Doomn00b/Open-SVGA/Docs/Connectors/USB-C/usbC-PIN/usb-type-c-hdmi.png

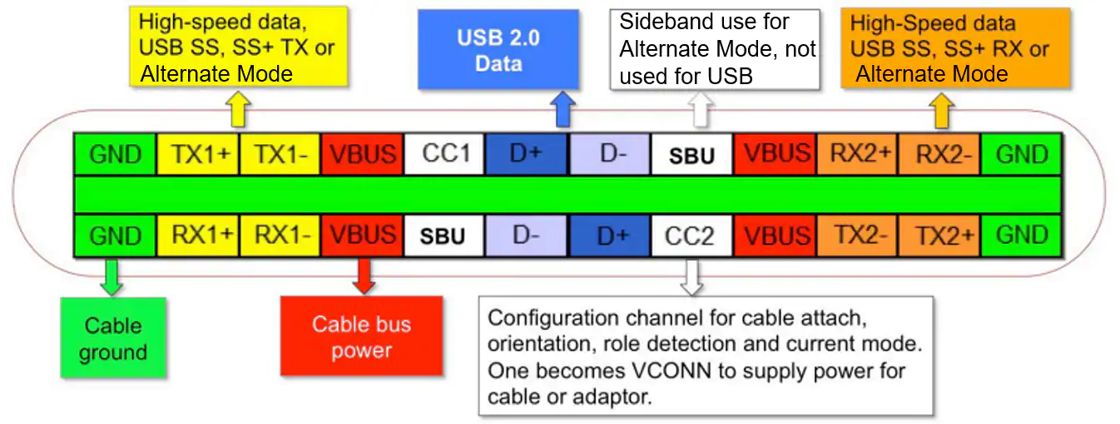
Docs/Connectors/USB-C/usbC-PIN/usb-type-c-hdmi.png
