Doomn00b/Open-SVGA/Docs/RAM/MT52L256M32D1PF-107-WT-B-package-BGA-178-new-original-genuine-ic-chip-DDR-SDRAM.png

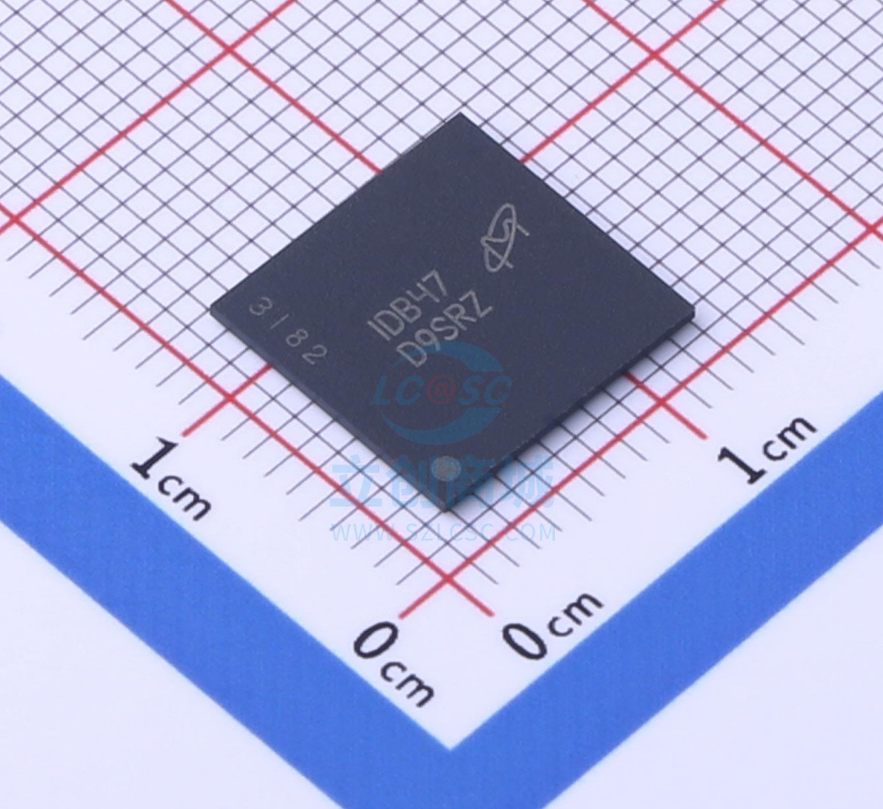
Docs/RAM/MT52L256M32D1PF-107-WT-B-package-BGA-178-new-original-genuine-ic-chip-DDR-SDRAM.png
