Doomn00b/Open-SVGA/README.md

# Open-SVGA
Video-card and GPU for the PC x86 platform, including PCB reference-design

This project is meant to encompass a PCI 3.0 31-bits video-card capable of displaying the majority of resolutions and video-modes from CGA, EGA, VGA and finally SVGA. Drivers are meant to be developed for DoS 6.5, Windows 98SE and Windows 10.
