Doomn00b/Open-SVGA/Docs/Connectors/VGA-pin/VGA-Connector.pdf

VGA connector | 1

# VGA connector

VGA connector (DE-15/HD-15)

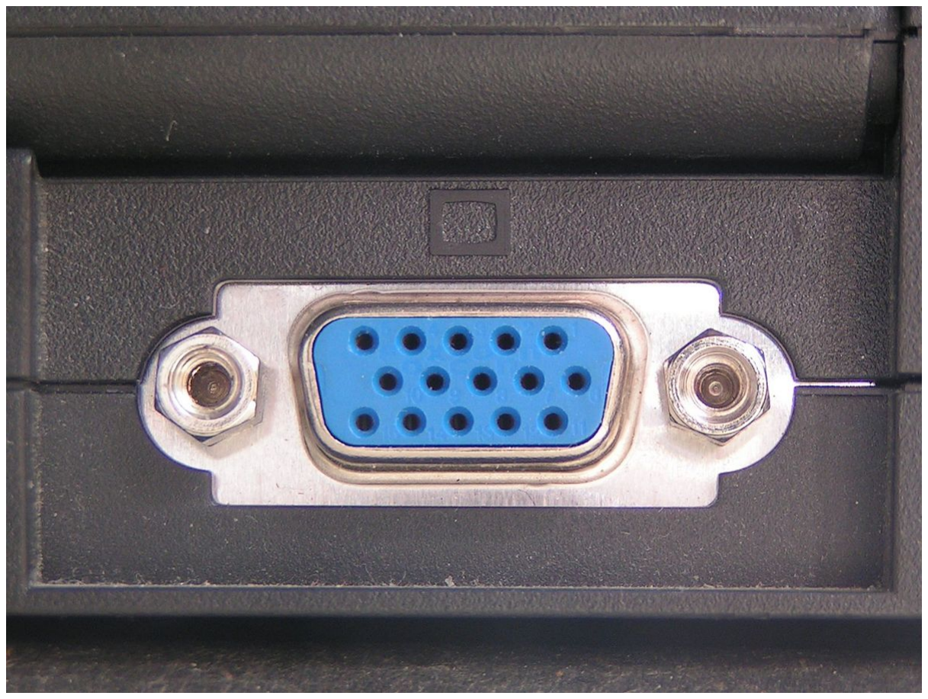
[picture p3: figure]

A female DE-15 output in a laptop computer.
Type | Computer analog video connector
| Production history
Designer | IBM (http://en.wikipedia.org/w/index.php?title=International_Business_Machines) based on D-subminiature (http://en.wikipedia.org/w/index.php?title=D-subminiature)
Designed | 1987
Produced | 1987 to present
Superseded by | DVI (http://en.wikipedia.org/w/index.php?title=Digital_Visual_Interface) (1999)

General specifications

Hot pluggable | No
Video signal | RGB video signal plus option H and V sync
Pins | 15
Connector | DE-15

Data

Data signal | I²C (http://en.wikipedia.org/w/index.php?title=I%C2%B2C) data channel for DDC (http://en.wikipedia.org/w/index.php?title=Display_Data_Channel) information
| Pin out

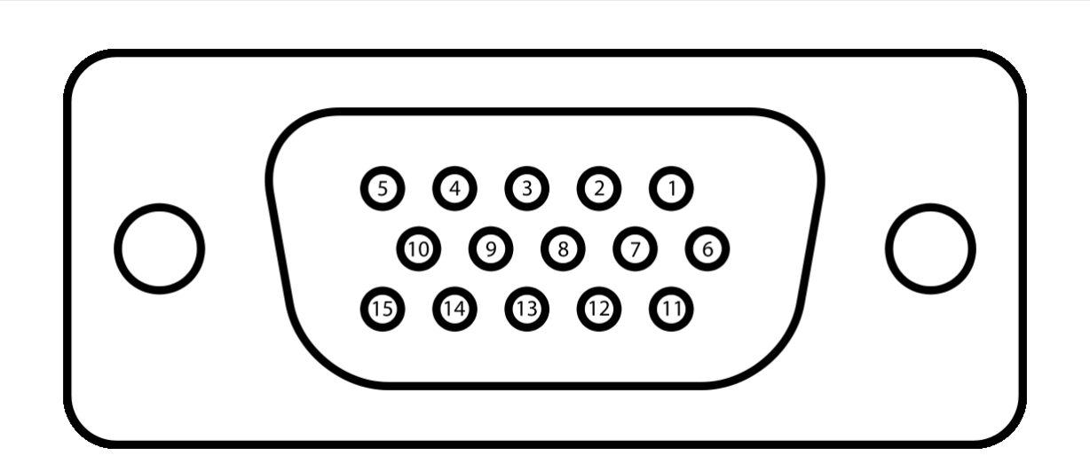
[picture p4: figure]

A female DE15 socket (videocard side).

Pin 1 | RED | Red video
Pin 2 | GREEN | Green video
Pin 3 | BLUE | Blue video

Pin 4 | ID2/RES | formerly Monitor ID bit 2, reserved since E-DDC
Pin 5 | GND | Ground (HSync)
Pin 6 | RED_RTN | Red return
Pin 7 | GREEN_RTN | Green return
Pin 8 | BLUE_RTN | Blue return
Pin 9 | KEY/PWR | formerly key, now +5V DC
Pin 10 | GND | Ground (VSync, DDC)
Pin 11 | ID0/RES | formerly Monitor ID bit 0, reserved since E-DDC
Pin 12 | ID1/SDA | formerly Monitor ID bit 1, I²C (http://en.wikipedia.org/w/index.php?title=I%C2%B2C) data since DDC2
Pin 13 | HSync | Horizontal sync
Pin 14 | VSync | Vertical sync
Pin 15 | ID3/SCL | formerly Monitor ID bit 3, I²C (http://en.wikipedia.org/w/index.php?title=I%C2%B2C) clock since DDC2

The image and table detail the 15-pin VESA DDC2/E-DDC connector; the diagram’s pin numbering is that of a female connector functioning as the graphics adapter (http://en.wikipedia.org/w/index.php?title=Graphics_adapter) output. In the male connector, this pin numbering corresponds with the mirror image (http://en.wikipedia.org/w/index.php?title=Mirror_image) of the cable’s wire-and-solder side.

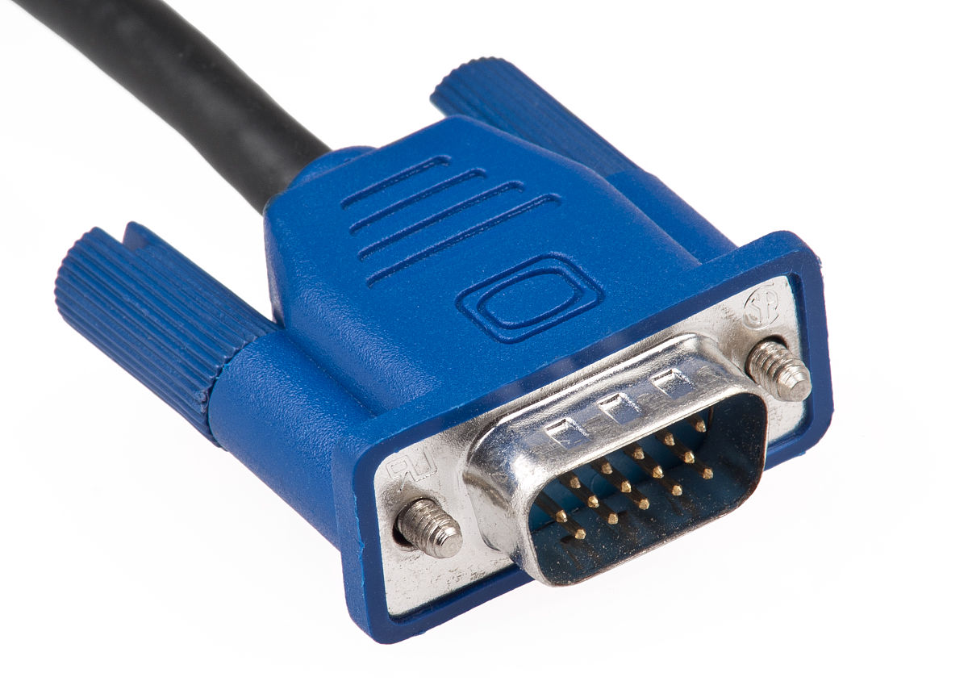
[picture p5: figure]

A VGA cable

A Video Graphics Array (http://en.wikipedia.org/w/index.php?title=Video_Graphics_Array) (VGA) connector is a three-row 15-pin DE-15 (http://en.wikipedia.org/w/index.php?title=D-subminiature) connector. The 15-pin VGA connector is found on many video cards, computer monitors, and some high definition television (http://en.wikipedia.org/w/index.php?title=High_definition_television) sets. On laptop computers or other small devices, a mini-VGA (http://en.wikipedia.org/w/index.php?title=Mini-VGA) port is sometimes used in place of the full-sized VGA connector.

DE-15 is also conventionally called RGB connector, D-sub (http://en.wikipedia.org/w/index.php?title=D-subminiature) 15, mini sub D15, mini D15, DB-15, HDB-15, HD-15 or HD15 (High Density, to distinguish it from the older and less flexible DE-9 connector (http://en.wikipedia.org/w/index.php?title=DE-9_connector) used on some older VGA cards, which has the same shell size but only two rows of pins).

VGA connectors and cables carry analog (http://en.wikipedia.org/w/index.php?title=Analog_television) component (http://en.wikipedia.org/w/index.php?title=Component_video) RGBHV (red, green, blue, horizontal sync, (http://en.wikipedia.org/w/index.php?title=Horizontal_sync) vertical sync) (http://en.wikipedia.org/w/index.php?title=Vertical_sync) video signals, and VESA (http://en.wikipedia.org/w/index.php?title=VESA) Display Data Channel (http://en.wikipedia.org/w/index.php?title=Display_Data_Channel) (VESA DDC) data. In the original version of DE-15 pinout, one pin was keyed and 4 pins carried Monitor ID bits (http://en.wikipedia.org/w/index.php?title=Display_Data_Channel%23Physical_link) which were rarely used; VESA DDC redefined some of these pins and replaced the key pin with +5 V DC power supply.

The VGA interface is not engineered to be hotpluggable (so that the user can connect or disconnect the output device while the host is running), although in practice this can be done and usually does not cause damage to the hardware or other problems. However, nothing in the design ensures that the ground pins make a connection first and break last, so hotplugging may introduce surges in signal lines which may or may not be adequately protected against. Also, depending on the hardware and software, detecting a monitor being connected might not work properly in all cases.

## Cable quality

The same VGA cable can be used with a variety of supported VGA resolutions, ranging from 640×400px @70 Hz (24 MHz of signal bandwidth) (http://en.wikipedia.org/w/index.php?title=Signal_bandwidth) to 1280×1024px (SXGA) (http://en.wikipedia.org/w/index.php?title=SXGA) @85 Hz (160 MHz) and up to 2048×1536px (QXGA) (http://en.wikipedia.org/w/index.php?title=QXGA) @85 Hz (388 MHz). There are no standards defining the quality required for each resolution, but higher-quality cables typically contain coaxial wiring and insulation which make them thicker. A quality cable should not suffer from signal crosstalk which occurs when the signals in one wire induce unwanted currents in adjacent wires, ghosting (http://en.wikipedia.org/w/index.php?title=Ghosting_%28television%29) which occurs when impedance mismatches cause signals to be reflected (note that ghosting with long cables may not be the fault of the cable but may instead be caused by equipment with incorrect termination or by use of passive splitters), and other signal degradation effects; shorter VGA cables are less likely to introduce significant degradation. Some higher-end monitors and video cards featured 5 separate BNC connectors (http://en.wikipedia.org/w/index.php?title=BNC_connector) for RGBHV (http://en.wikipedia.org/w/index.php?title=RGBHV) signal, allowing highest quality connection using five 75 ohm coaxial cables. (http://en.wikipedia.org/w/index.php?title=Coaxial_cable)

## Adapters

There are HDMI (http://en.wikipedia.org/w/index.php?title=HDMI) to VGA [1] and DVI (http://en.wikipedia.org/w/index.php?title=Digital_Visual_Interface) to VGA adapters, and VGA to SCART (http://en.wikipedia.org/w/index.php?title=SCART) converters. [2][3][4]

For a simple VGA to SCART adapter cable to be viable, the display card must have sufficient features. Namely the ability to provide interlaced output and adjust the frequency, number of total scan lines and number of visible lines (the actual resolution) to match those of the prevailing TV standard. [5] Signal incompatibility rises from the fact that

SCART uses composite sync, (http://en.wikipedia.org/w/index.php?title=Composite_sync) so either display card must be able to do so too, or sync signals must be summed with a simple circuit. Additionally some TV sets may require 1 volt voltage on SCART pin 16 as explicit signal to use component instead of composite signal. [6] Likewise, three conductor analog RGB signal uses composite sync on

green, (http://en.wikipedia.org/w/index.php?title=Sync_on_green) but a converter circuit for to achieve that is simple as well. http://www. epanorama. net/ circuits/sync_r. html (http://www.epanorama.net/circuits/sync_r.html)

HDMI/DVI to VGA adapters do not carry the audio channel. Separate audio cables are used.

HDMI to VGA adapters generally won't be useful as most displays can't read analog over the HDMI port. The display's EDID (http://en.wikipedia.org/w/index.php?title=EDID) can still be read.

## References

[1] http://www.amazon.com/dp/B001OLCHJ6
[2] http://www.epanorama.net/circuits/vga2tv/cindex.html
[3] http://pinouts.ru/VideoCables/scart2vga_scheme_pinout.shtml
[4] http://www.amazon.co.uk/dp/B0002W69MY
[5] http://www.nexusuk.org/projects/vga2scart/
[6] http://www.nexusuk.org/projects/vga2scart/

## External links

- DE-9 pinout (http://old.pinouts.ru/Video/VGA9_pinout.shtml)
- DE-15 Monitor ID pinout (http://pinouts.ru/data/VGA15_pinout.shtml)
- DE-15 VESA DDC pinout (http://pinouts.ru/Video/VGAVesaDdc_pinout.shtml)
- DE-15 to 5 BNC (http://www.repairfaq.org/REPAIR/F_vidconv.html#VIDCONV_056)

Article Sources and Contributors | 4

# Article Sources and Contributors

VGA connector Source: http://en.wikipedia.org/w/index.php?oldid=498841275 Contributors: Abisys, Academic Challenger, Airplaneman, Alansohn, Ali@gwc.org.uk, Antilived, ArglebargleIV, Atif5561, Atlant, Ayda D, Beland, Bourgeoisdude, Brycen, Canterbury Tail, Cburnett, Ctachme, David Edgar, Dherm8or, Diamondland, DmitryKo, DracoDan82, Dtcdthingy, Edwulf, Electron9, Etienne.navarro, Evan-Amos, Evil saltine, Fastilysock, Femto, FlyingPenguins, Frap, Fredylibrary, Fuhghettaboutit, Gbm, Ghiraddje, GoingBatty, Gotanda, Gracefool, Guyom, Harvalumn, Heywøød, Hummingbirdfrost, IceCreamAntisocial, Inferno, Lord of Penguins, Int21h, Jncraton, Johnchiu, JonHarder, Joshua 70448, Julien, Kainaw, Kevin, Kickin' Da Speaker, Kkemp, Kstinch, Lordkosmos, Mark Rizo, Markhobley, Mcleodm, Megapixie, Merlion444, Mhazard9, Miernik, Mobius, Mrschimpf, Nicolaasuni, Oldmountains, Ozkidzez91, Pagingmrherman, Pako, Pbb, Peaceduck, Pfranson, Phy1729, Plugwash, Reisio, RevRagnarok, Rjwilmsi, RoseTech, ST47, SmartAVI, Stickeylabel, Strandist, TX-TransAm, ULTRA
ANNIHILATOR, Ugnich Anton, VasuVR, Venkatesan2488, Vespristiano, Vrenator, Wbm1058, Wtshymanski, WuWei, Xx521xx, Ydroneaud, Yottie, Zujua, | المحارب | محمد | , 178 anonymous edits

# Image Sources, Licenses and Contributors

Image:SVGA port.jpg Source: http://en.wikipedia.org/w/index.php?title=File:SVGA_port.jpg License: Public Domain Contributors: Duncan Lithgow
Image:DE15 Connector Pinout.svg Source: http://en.wikipedia.org/w/index.php?title=File:DE15_Connector_Pinout.svg License: Public Domain Contributors: 32bitmaschine, Mobius Image:Vga-cable.jpg Source: http://en.wikipedia.org/w/index.php?title=File:Vga-cable.jpg License: Public Domain Contributors: Evan-Amos

# License

Creative Commons Attribution-Share Alike 3.0 Unported //creativecommons.org/licenses/by-sa/3.0/
