Doomn00b/Open-SVGA/Docs/Connectors/dvi/2000px-DVI_Connector_Types.svg.png

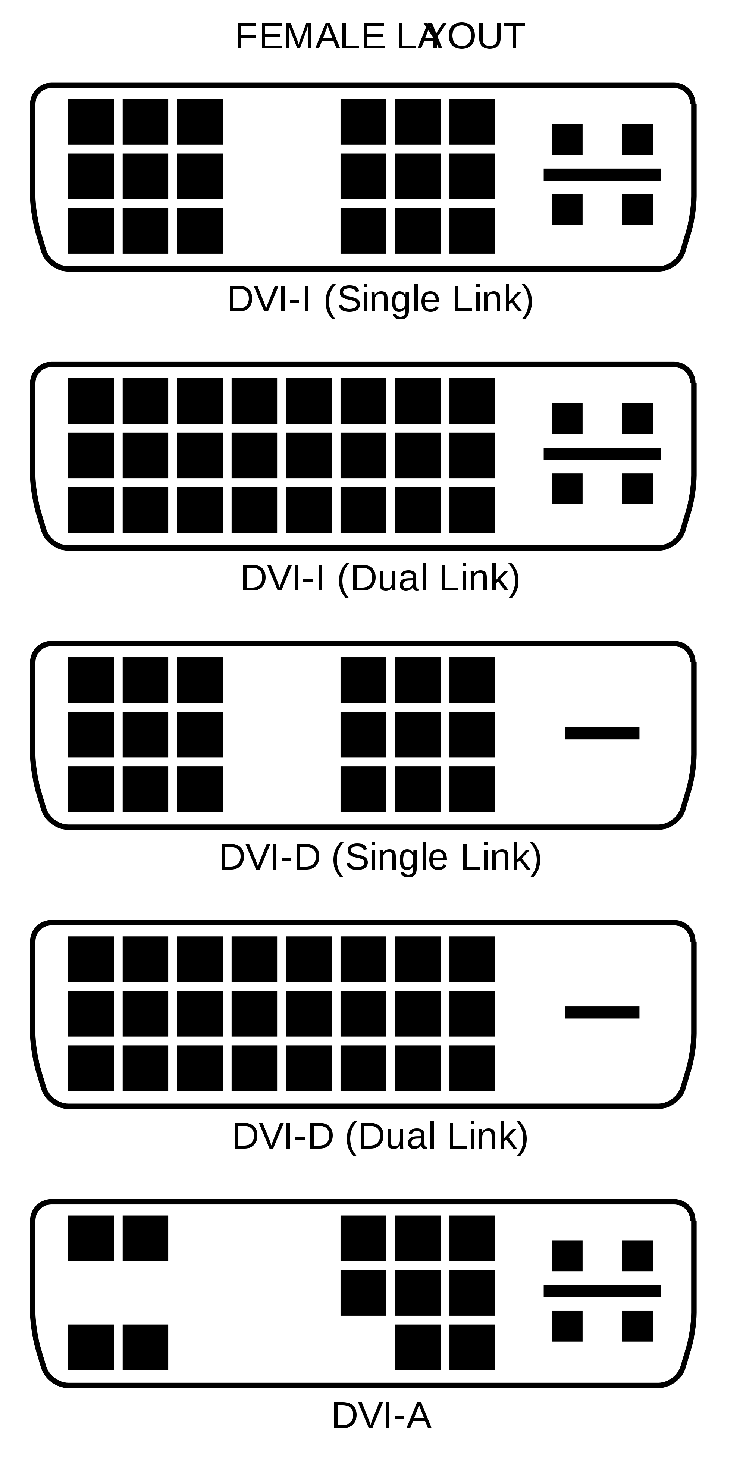
Docs/Connectors/dvi/2000px-DVI_Connector_Types.svg.png
