Doomn00b/Open-SVGA/Docs/Connectors/dvi/2000px-DVI_pinout.svg.png

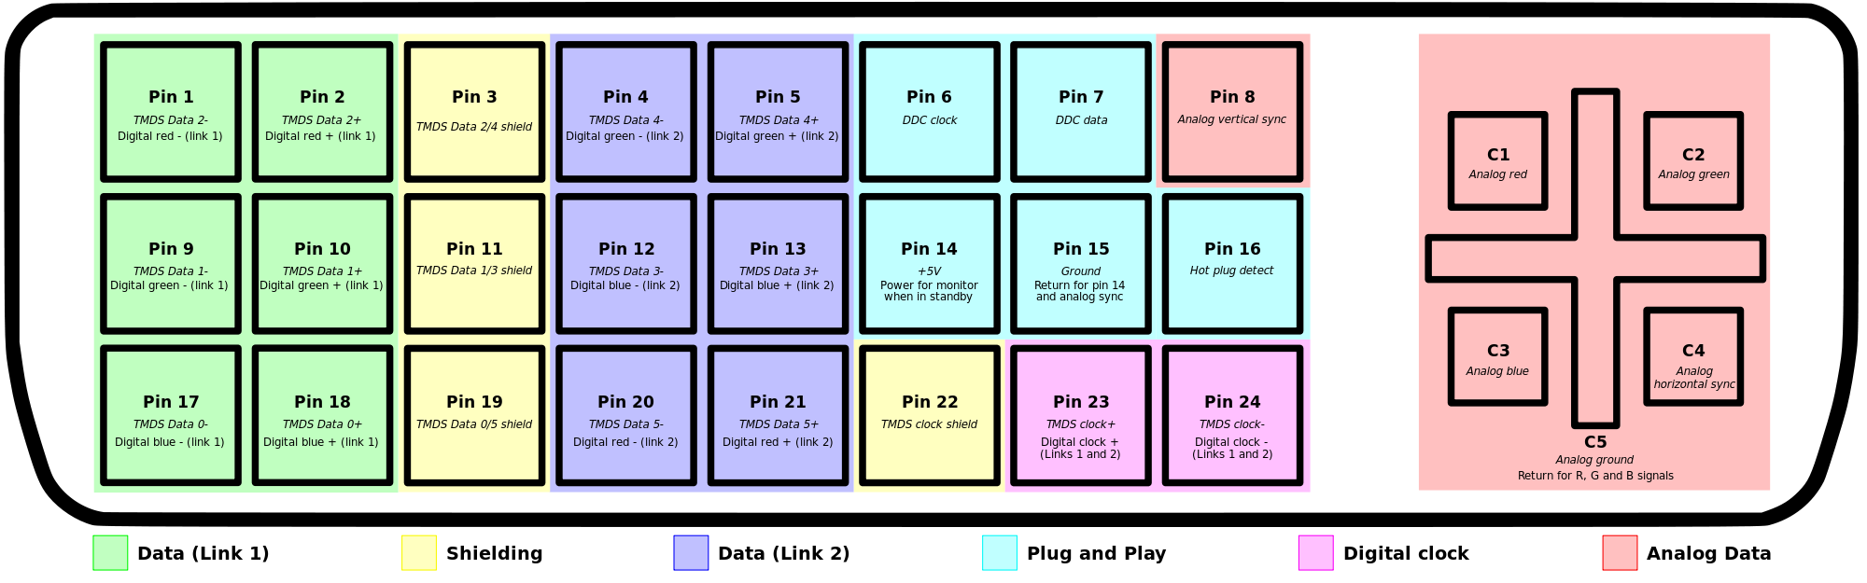
Docs/Connectors/dvi/2000px-DVI_pinout.svg.png
