Doomn00b/Open-SVGA/Docs/Connectors/dvi/dvi_to_vga_adapter.jpg

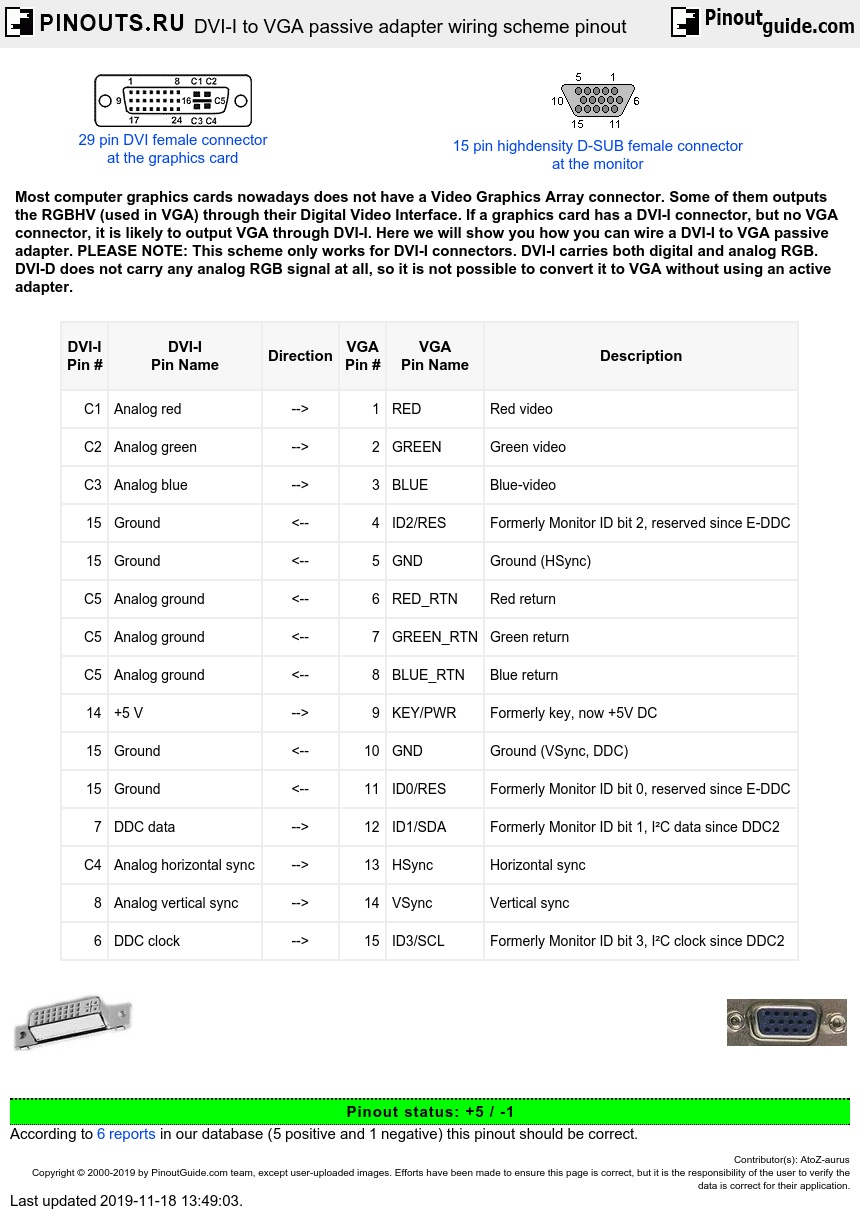
Docs/Connectors/dvi/dvi_to_vga_adapter.jpg
