Doomn00b/Open-SVGA/Docs/Connectors/hdmi/hdmi-pinout.jpg

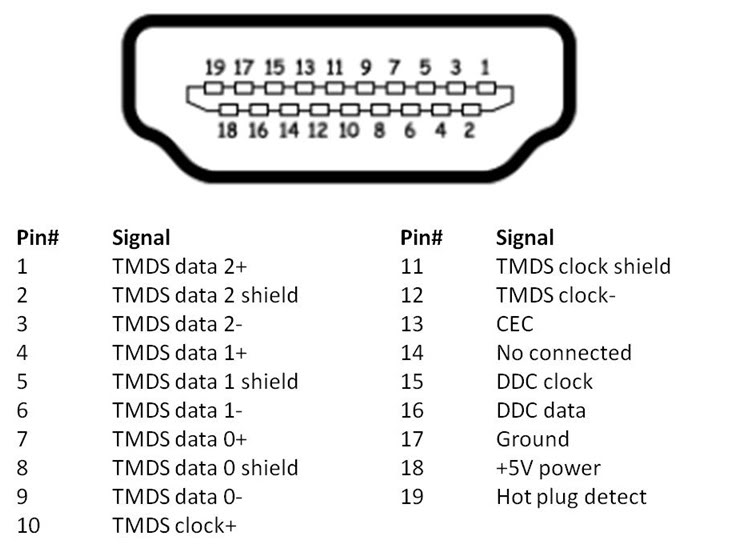
Docs/Connectors/hdmi/hdmi-pinout.jpg
