Doomn00b/Open-SVGA/Docs/Connectors/hdmi/HDMI_Connector_Pinout.svg.png

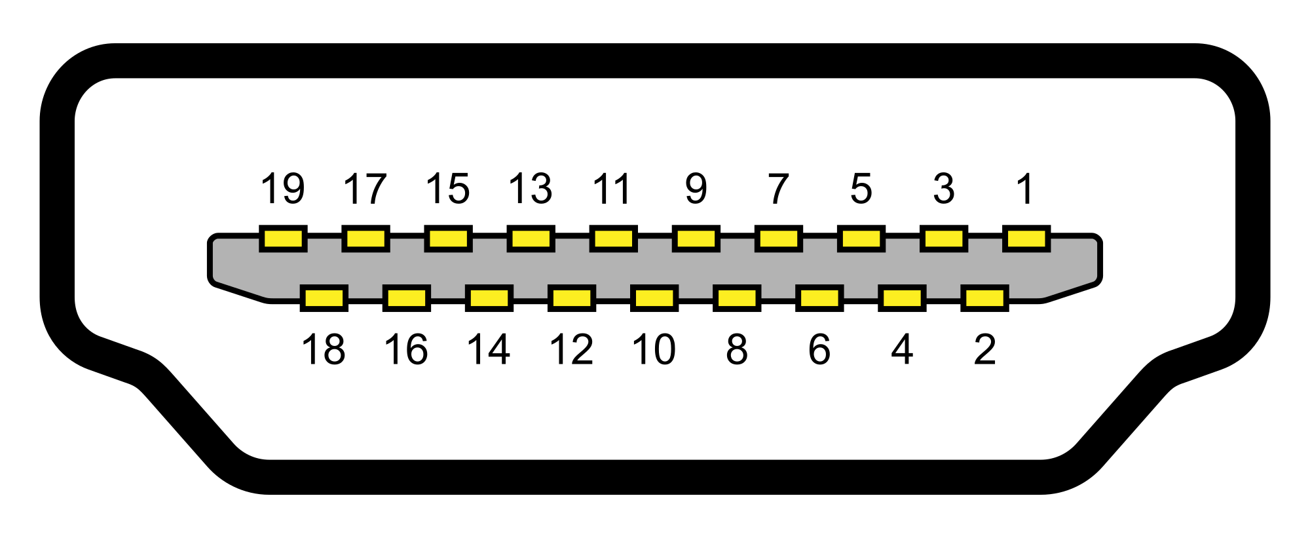
Docs/Connectors/hdmi/HDMI_Connector_Pinout.svg.png
