Doomn00b/Open-SVGA/Docs/Connectors/hot_plug_pinouts.png

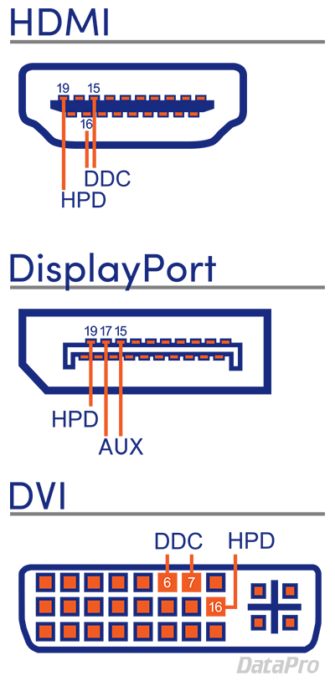
Docs/Connectors/hot_plug_pinouts.png
