Doomn00b/Open-SVGA/Docs/Connectors/PCI/pci-conn-types.png

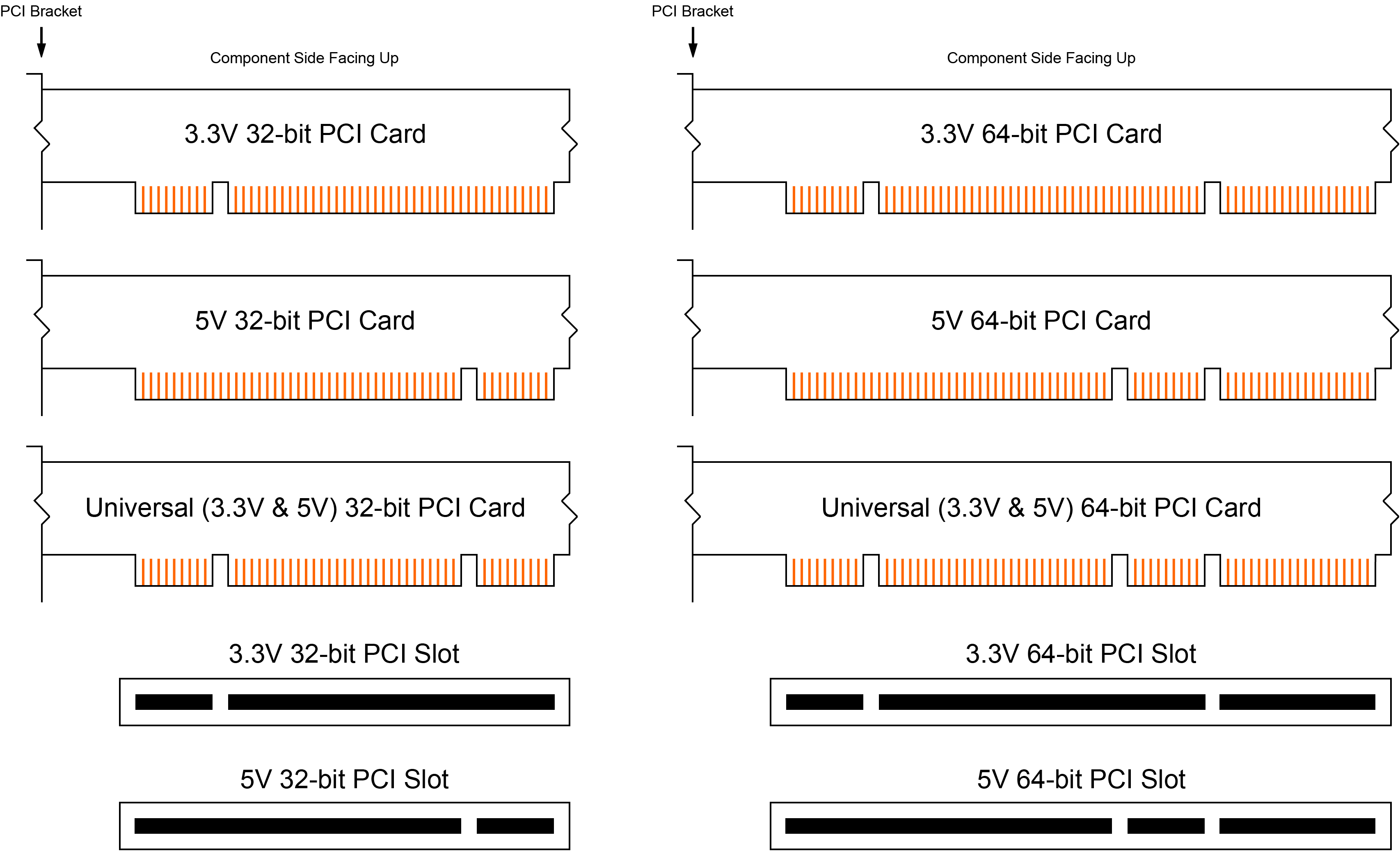
Docs/Connectors/PCI/pci-conn-types.png
