Doomn00b/Open-SVGA/Docs/Connectors/USB-C/USB-C_to_DP.png

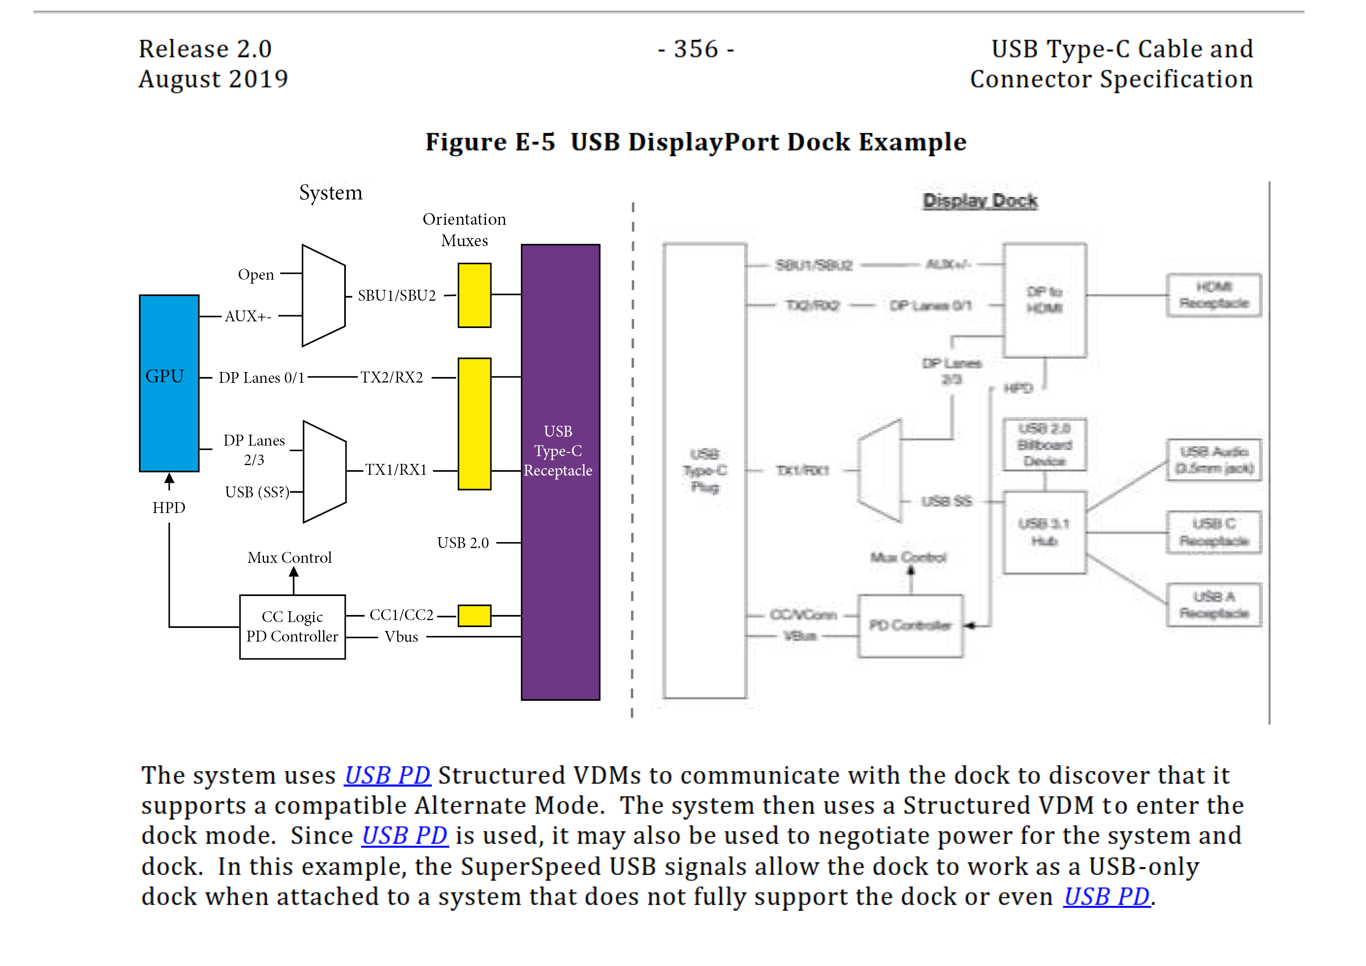
Docs/Connectors/USB-C/USB-C_to_DP.png
