Doomn00b/Open-SVGA/Docs/Connectors/USB-C/usbC-PIN/USB3_2-Diag-1_.jpg

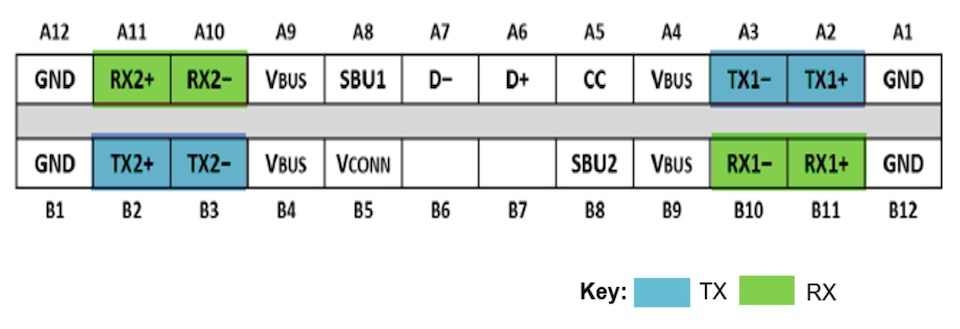
Docs/Connectors/USB-C/usbC-PIN/USB3_2-Diag-1_.jpg
