Doomn00b/Open-SVGA/Docs/Connectors/USB-C/usbC-PIN/usb-c-port.png

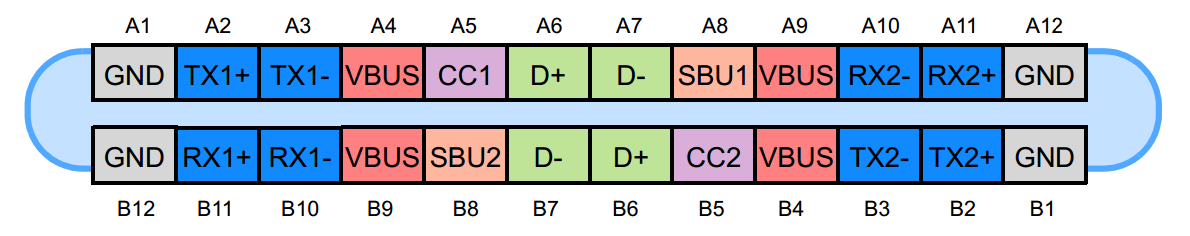
Docs/Connectors/USB-C/usbC-PIN/usb-c-port.png
