Doomn00b/Open-SVGA/Docs/Connectors/VGA-pin/svgamonitor.gif

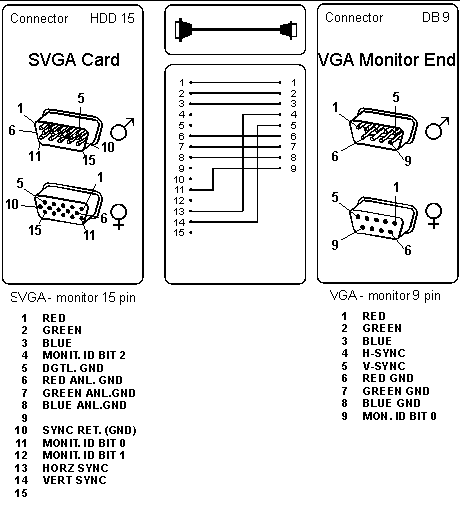
Docs/Connectors/VGA-pin/svgamonitor.gif
