Doomn00b/Open-SVGA/Docs/Connectors/VGA-pin/VGA-Pinout.jpg

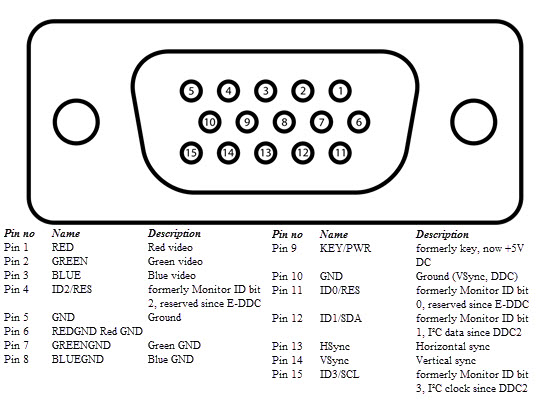
Docs/Connectors/VGA-pin/VGA-Pinout.jpg
