Doomn00b/Open-SVGA/Docs/Connectors/VGA-pin/VGA-Pinouts-16fe4wk.png

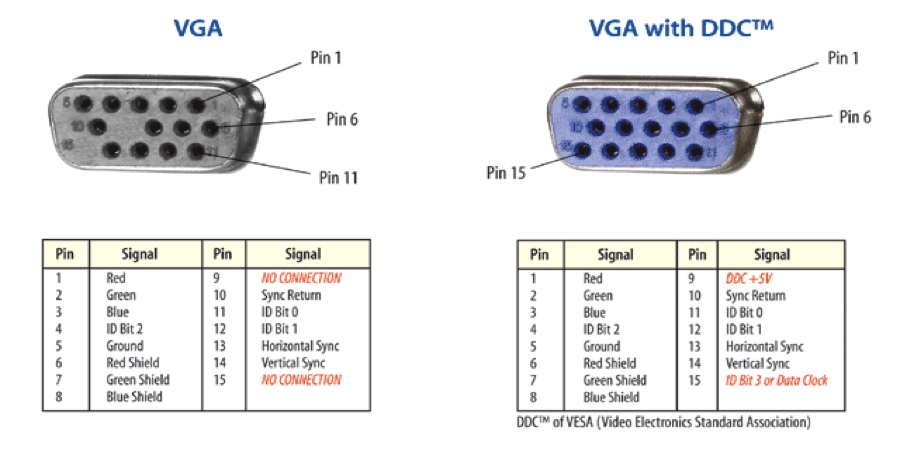
Docs/Connectors/VGA-pin/VGA-Pinouts-16fe4wk.png
