Doomn00b/Open-SVGA/Docs/datasheets-osvga/Voltage-translation/bus-datasheet.png

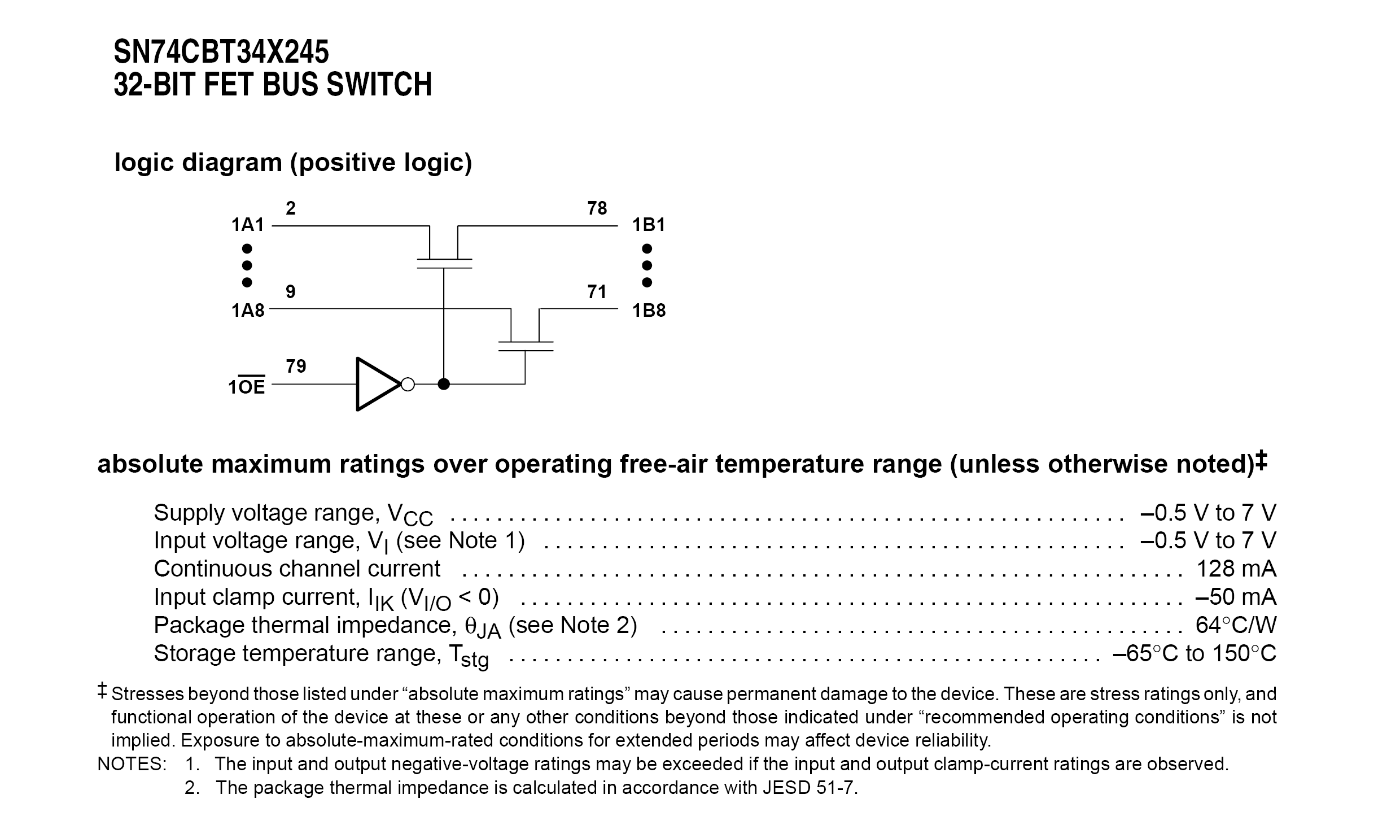
Docs/datasheets-osvga/Voltage-translation/bus-datasheet.png
