Doomn00b/Open-SVGA/Docs/datasheets-osvga/Voltage-translation/bus-switches.png

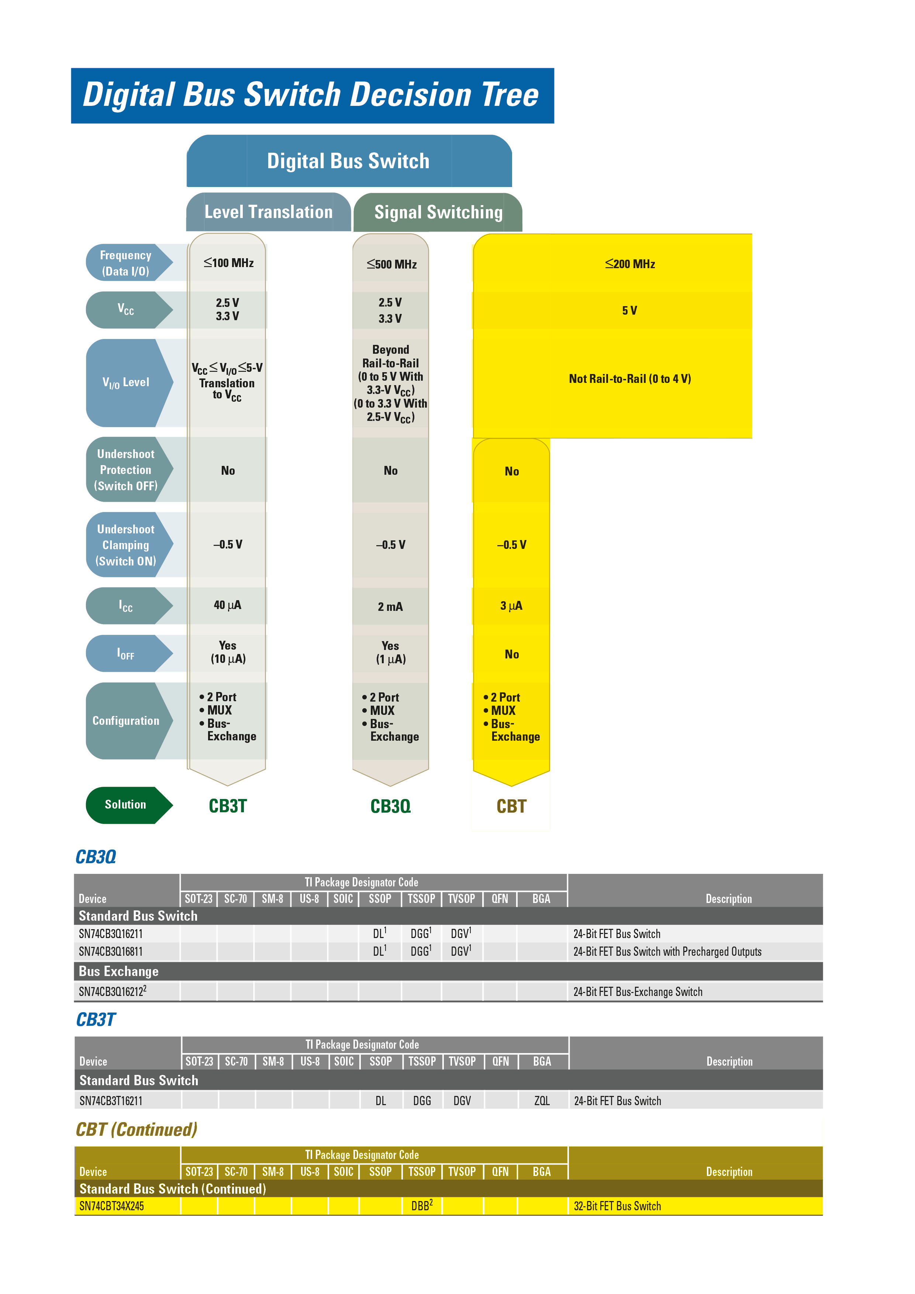
Docs/datasheets-osvga/Voltage-translation/bus-switches.png
