Doomn00b/Open-SVGA/Docs/Design-rules-pcb/JLCPCB-drill-hole_rules.png

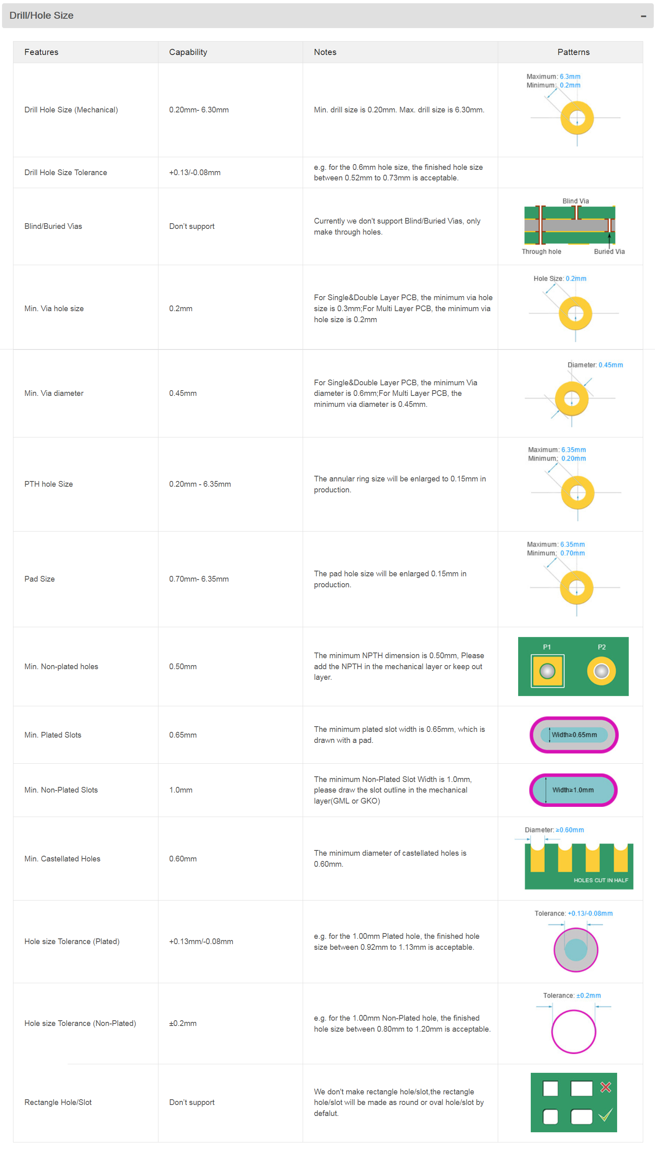
Docs/Design-rules-pcb/JLCPCB-drill-hole_rules.png
