Doomn00b/Open-SVGA/Docs/Design-rules-pcb/JLCPCB-min-clear_rules.png

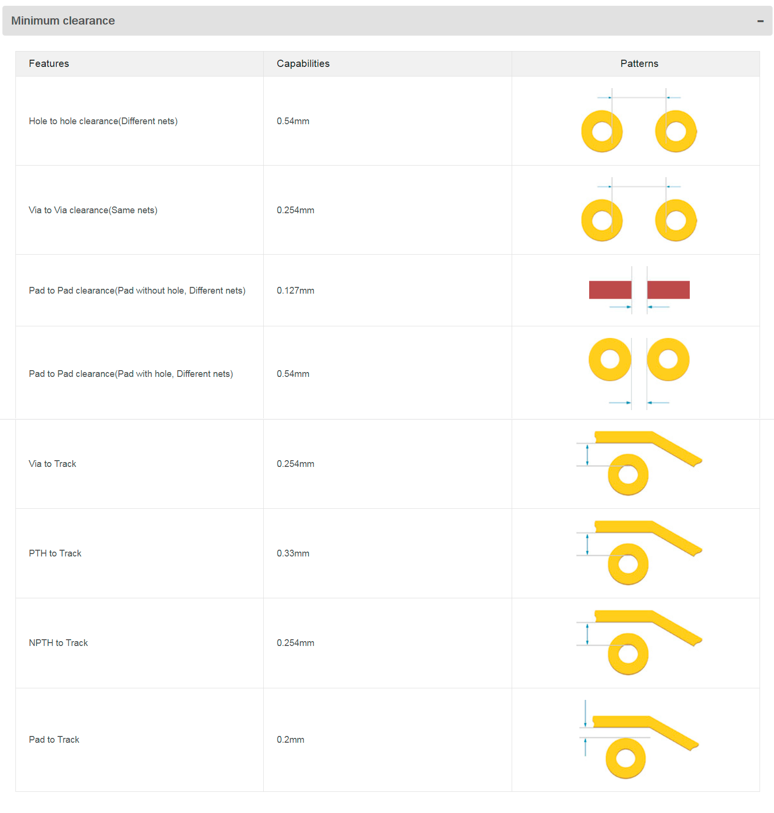
Docs/Design-rules-pcb/JLCPCB-min-clear_rules.png
