Doomn00b/Open-SVGA/Docs/Design-rules-pcb/JLCPCB-pcb-spec_rules.png

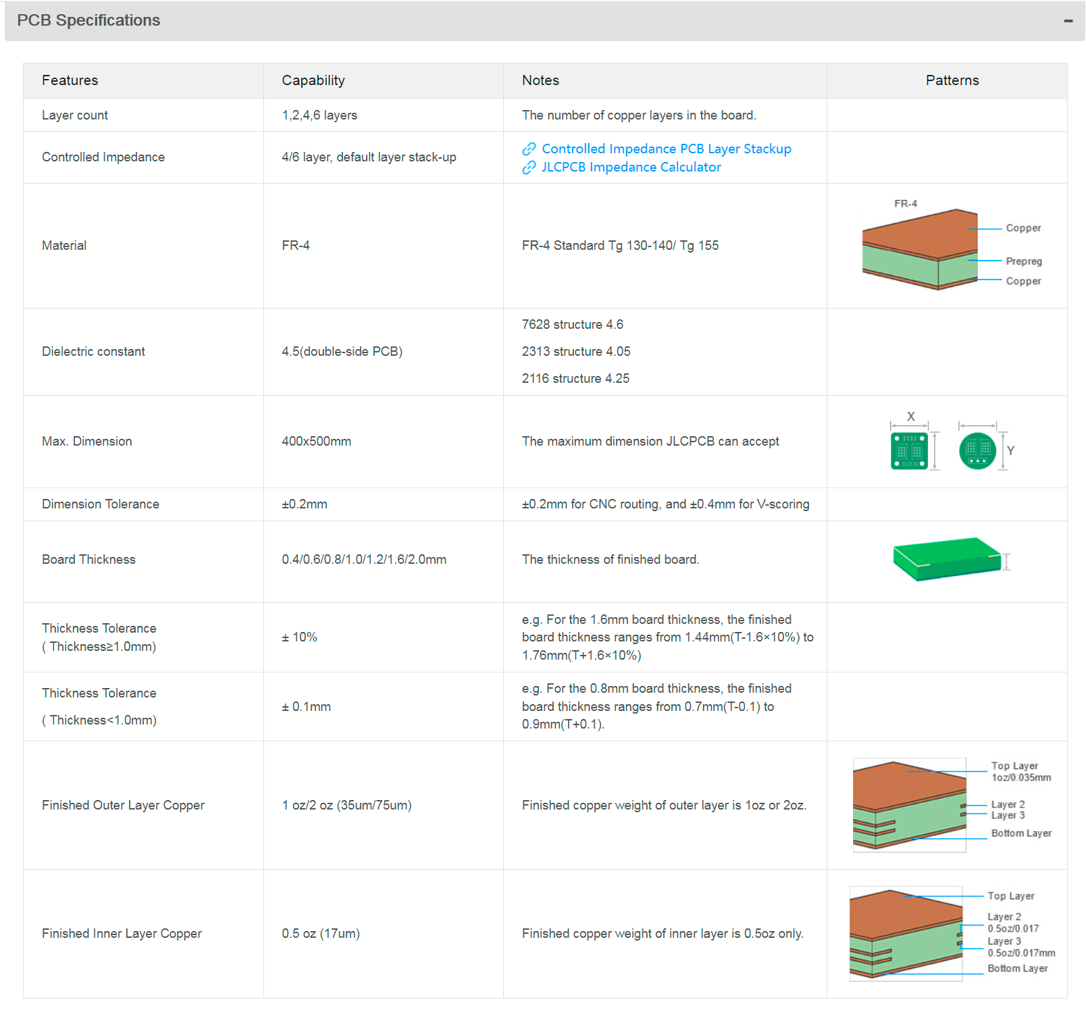
Docs/Design-rules-pcb/JLCPCB-pcb-spec_rules.png
