Doomn00b/Open-SVGA/Docs/Design-rules-pcb/True_JLCPCB-rules.png

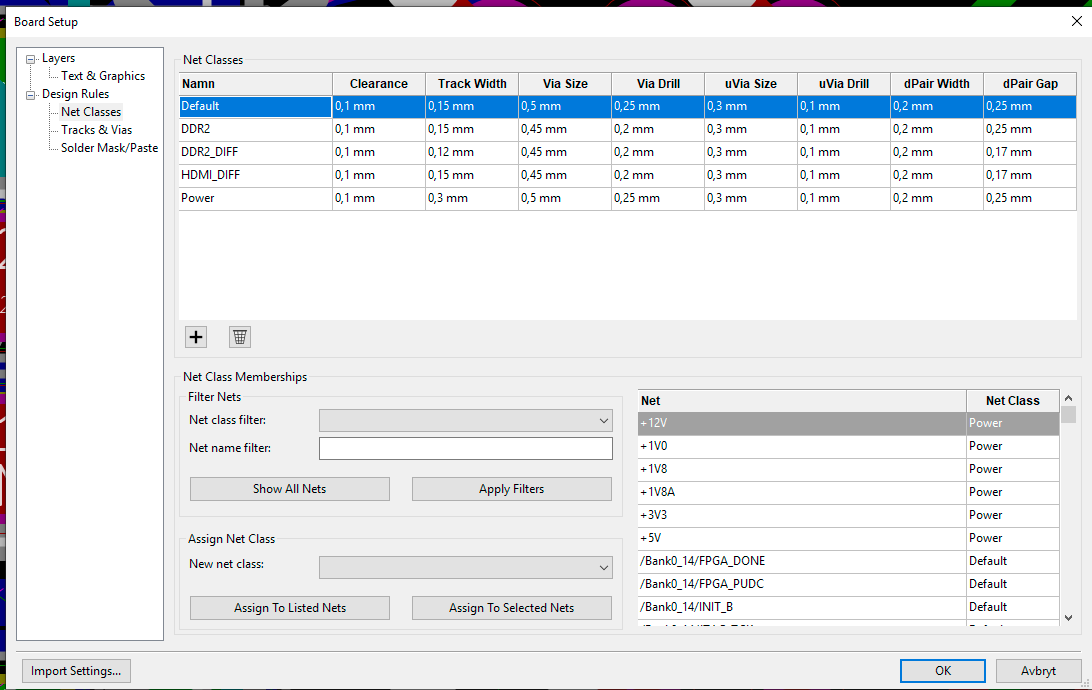
Docs/Design-rules-pcb/True_JLCPCB-rules.png
