Doomn00b/Open-SVGA/Docs/GPLGPU/gpgpu-files.png

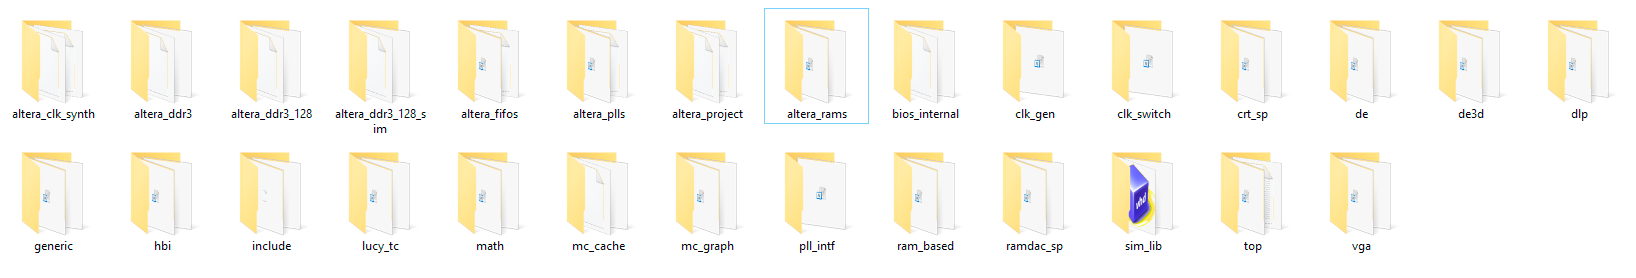
Docs/GPLGPU/gpgpu-files.png
