Doomn00b/Open-SVGA/Docs/PMP9462_Schematic_Full.png

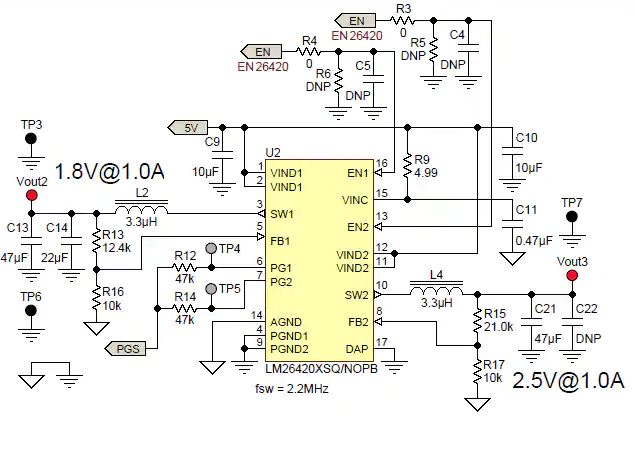
Docs/PMP9462_Schematic_Full.png
