Doomn00b/Open-SVGA/Docs/RAM/dram-balls.png

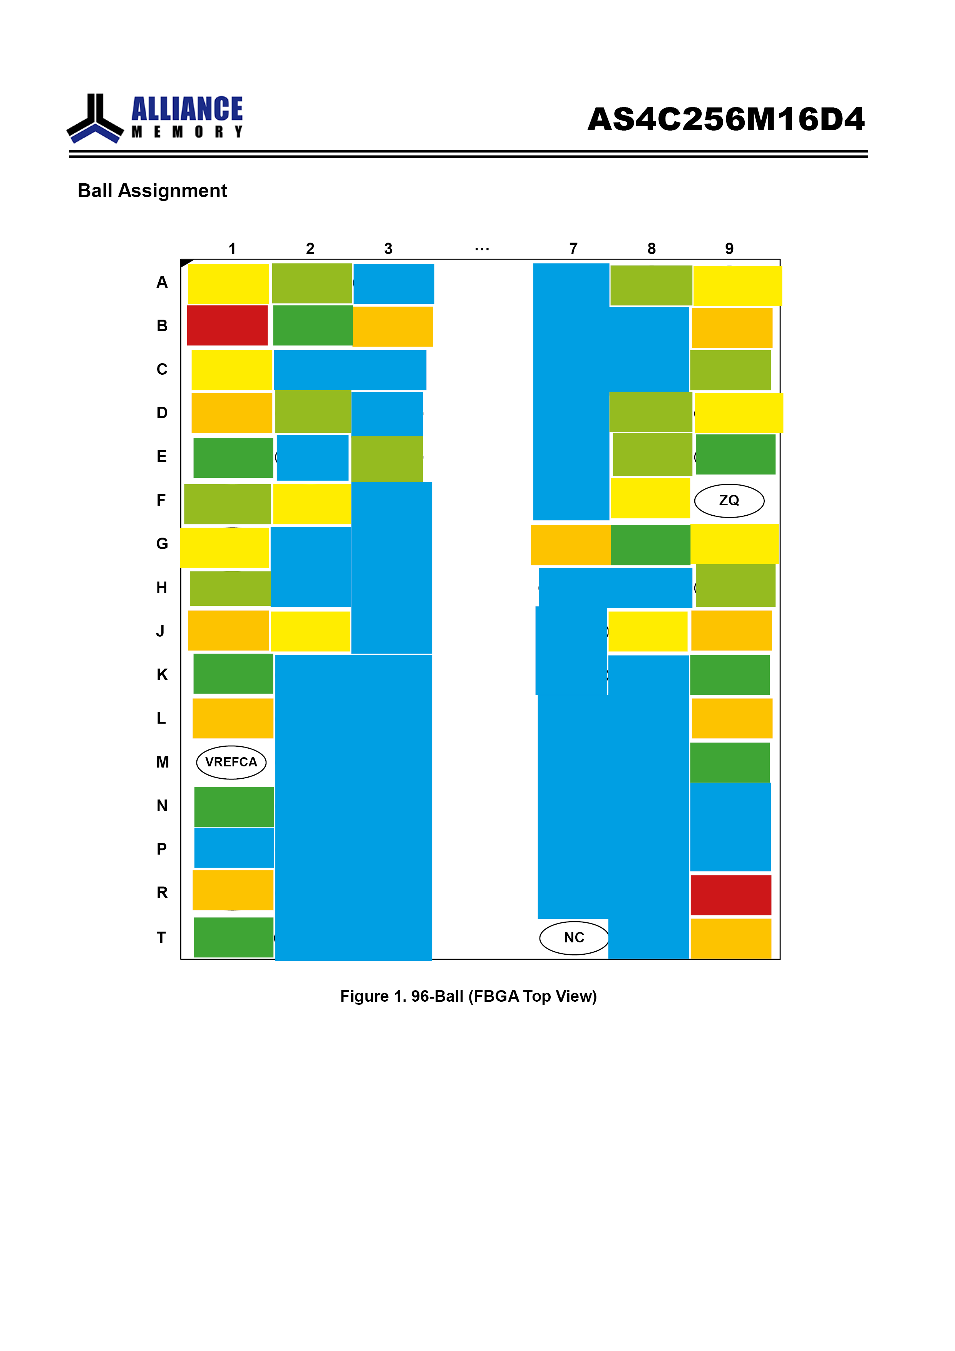
Docs/RAM/dram-balls.png
