Doomn00b/Open-SVGA/Docs/ref-pictures/71Xu-13G7zL._AC_SL800_.jpg

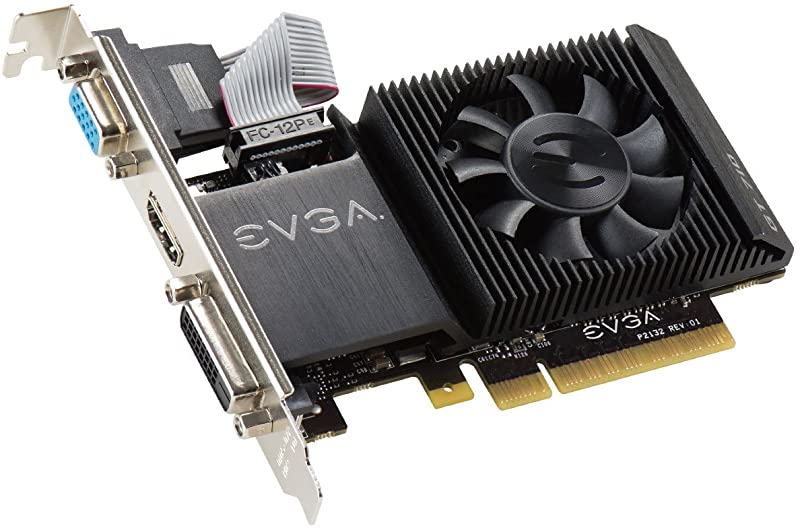
Docs/ref-pictures/71Xu-13G7zL._AC_SL800_.jpg
