Doomn00b/Open-SVGA/Docs/signal-translators/vt-ti-products.png

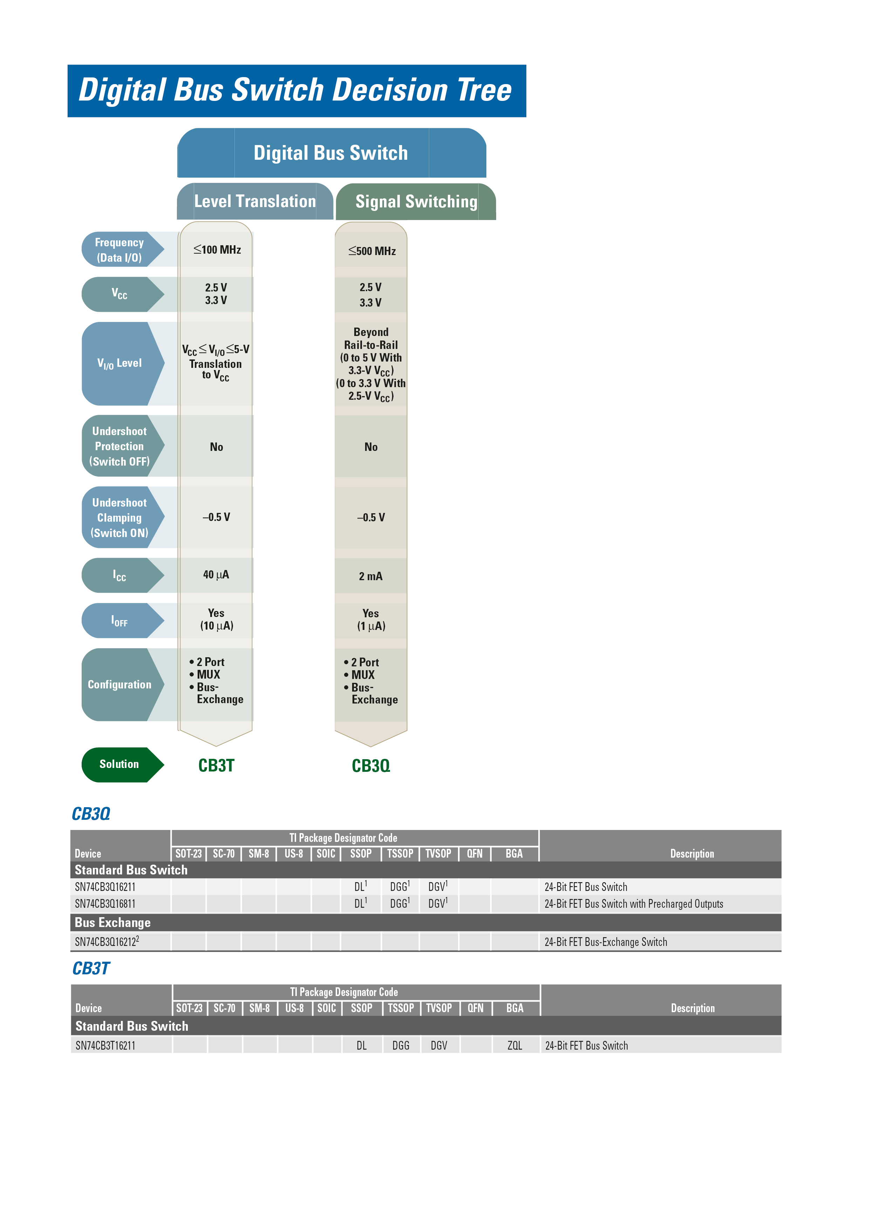
Docs/signal-translators/vt-ti-products.png
