Doomn00b/Open-SVGA/Docs/VGA-docs/1920px-Vector_Video_Standards8.png

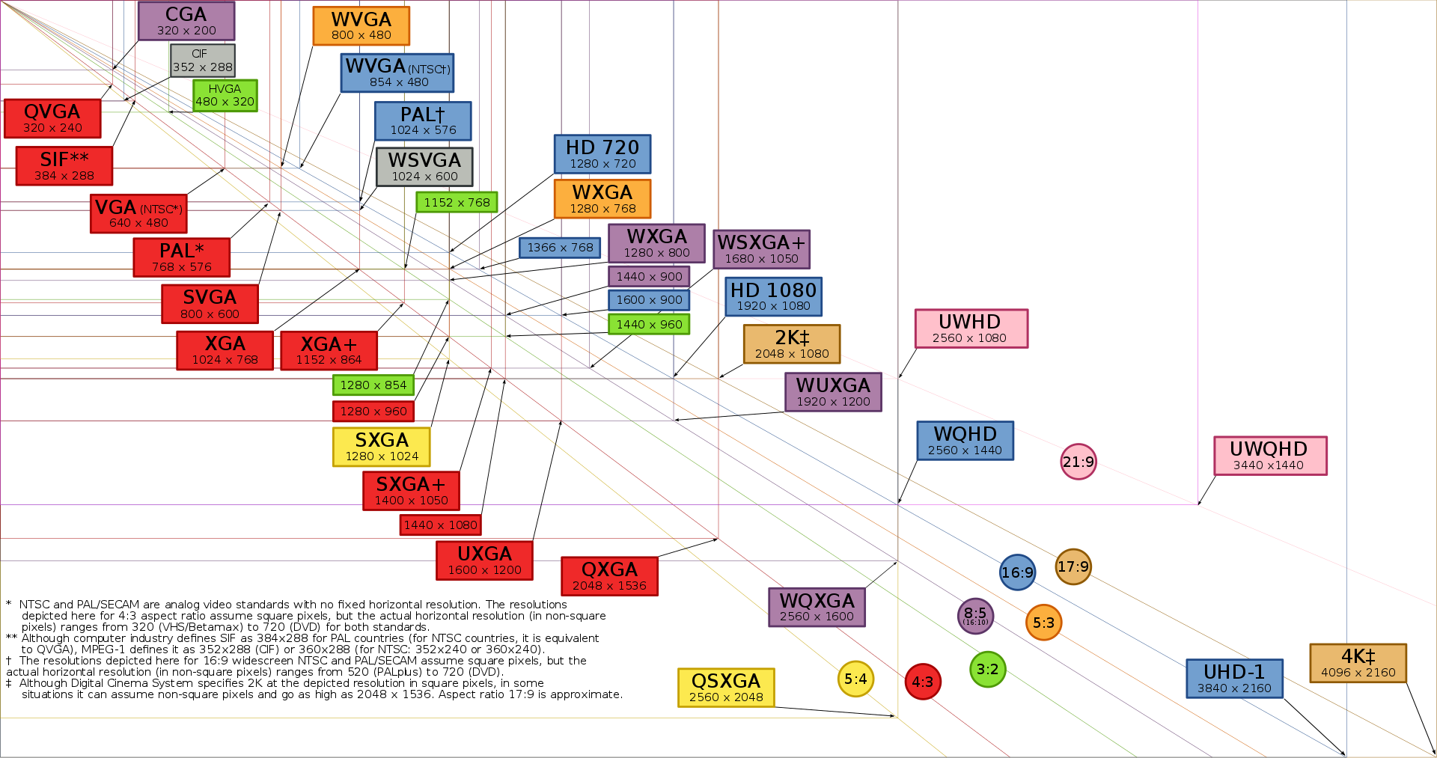
Docs/VGA-docs/1920px-Vector_Video_Standards8.png
