Doomn00b/Open-SVGA/Docs/signal-translators/vt-s.xlsx

Mouser Part Number | Mfr Part Number | Mfr. | Datasheet | Pricing | Product Detail | Type | Propagation Delay Time | Supply Voltage - Max | Supply Voltage - Min | Minimum Operating Temperature | Maximum Operating Temperature | Package/Case | Data Rate | Points: | 2 points
 |  |  |  |  |  |  |  |  |  |  |  |  |  |  | 1 point
595-SN74AVCH4T245PWR | SN74AVCH4T245PWR | Texas Instruments | http://www.ti.com/general/docs/suppproductinfo.tsp?distId=26 | 8.89 | https://www.mouser.se/ProductDetail/Texas-Instruments/SN74AVCH4T245PWR?qs=eXyjQBh9UFj9uUSkgDwR9A== | 0 | 2.9 ns | 3.6 V | 1.2 V | - 40 C | + 85 C | TSSOP-16 | 380 Mb/s | 5 | minus 1
595-SN74AVCH4T245DR | SN74AVCH4T245DR | Texas Instruments | http://www.ti.com/general/docs/suppproductinfo.tsp?distId=26 | 8.89 | https://www.mouser.se/ProductDetail/Texas-Instruments/SN74AVCH4T245DR?qs=eXyjQBh9UFgd8jxt13zTpQ== | 0 | 2.9 ns | 3.6 V | 1.2 V | - 40 C | + 85 C | SOP-16 | 380 Mb/s | 5
595-SN74AVCH4T245PW | SN74AVCH4T245PW | Texas Instruments | http://www.ti.com/general/docs/suppproductinfo.tsp?distId=26 | 10.6 | https://www.mouser.se/ProductDetail/Texas-Instruments/SN74AVCH4T245PW?qs=eXyjQBh9UFjGuf1byV0Ymw== | Configurable Voltage Level Translators | 2.9 ns | 3.6 V | 1.2 V | - 40 C | + 85 C | TSSOP-16 | 380 Mb/s | 6
595-SN74AVCH4T245DGV | SN74AVCH4T245DGVR | Texas Instruments | http://www.ti.com/general/docs/suppproductinfo.tsp?distId=26 | 8.89 | https://www.mouser.se/ProductDetail/Texas-Instruments/SN74AVCH4T245DGVR?qs=PVVDbbWpW3JSLTdSuV1LkA== | 0 | 2.9 ns | 3.6 V | 1.2 V | - 40 C | + 85 C | TVSOP-16 | 380 Mb/s | 5
595-SN74AVC4T245PWR | SN74AVC4T245PWR | Texas Instruments | http://www.ti.com/general/docs/suppproductinfo.tsp?distId=26 | 7.58 | https://www.mouser.se/ProductDetail/Texas-Instruments/SN74AVC4T245PWR?qs=eXyjQBh9UFjikDDZFUGXXQ== | 0 | 2.9 ns | 3.6 V | 1.2 V | - 40 C | + 85 C | TSSOP-16 | 380 Mb/s | 5
595-SN74AVC4T245RGYR | SN74AVC4T245RGYR | Texas Instruments | http://www.ti.com/general/docs/suppproductinfo.tsp?distId=26 | 8.37 | https://www.mouser.se/ProductDetail/Texas-Instruments/SN74AVC4T245RGYR?qs=eXyjQBh9UFit%2Brml6JbBlQ== | 0 | 2.9 ns | 3.6 V | 1.2 V | - 40 C | + 85 C | VQFN-16 | 380 Mb/s | 5
595-SN74AVC4T245RSVR | SN74AVC4T245RSVR | Texas Instruments | http://www.ti.com/general/docs/suppproductinfo.tsp?distId=26 | 8.37 | https://www.mouser.se/ProductDetail/Texas-Instruments/SN74AVC4T245RSVR?qs=wkx8pu8tL7IC8gMRyn9Geg== | 0 | 2.9 ns | 3.6 V | 1.2 V | - 40 C | + 85 C | UQFN-16 | 380 Mb/s | 5
595-SN74AVC4T774PWR | SN74AVC4T774PWR | Texas Instruments | http://www.ti.com/general/docs/suppproductinfo.tsp?distId=26 | 9.59 | https://www.mouser.se/ProductDetail/Texas-Instruments/SN74AVC4T774PWR?qs=WxL8HmPi5r562Eu/2kE2LA== | Configurable Voltage Level Translators | 2.4 ns | 3.6 V | 1.2 V | - 40 C | + 85 C | TSSOP-16 | 380 Mb/s | 7
 | SN74LVCH8T245PWR |  |  | 11.52 kr |  | Configurable Voltage Level Translators | 23.8 ns | 5.5 V | 1.65 V | - 40 C | + 85 C |  |  | 3
 | 74LVC1T45GM-Q100X
 | 74LVCH1T45GW,125
 | 74LVCH2T45DC-Q100H
 | 74LVCH8T245
