Doomn00b/Open-SVGA/Docs/RAM/digi-DRAM1.xlsx

Datablad | Bild | Digi-Keys artikelnummer | Tillverkarens artikelnummer | Tillverkare | Beskrivning | TillgÃ¤ngligt antal | Fabrikslager | Enhetspris (SEK) | Minsta tillÃ¥tna antal | Inkapsling | Artikelstatus | Minnesformat | Teknologi | Minnesstorlek | MinnesgrÃ¤nssnitt | Klockfrekvens | Skrivcykeltid - ord, sida | Ã…tkomsttid | SpÃ¤nning - kÃ¤lla | Arbetstemperatur | Inkapsling/lÃ¥da | LeverantÃ¶rens enhetsfÃ¶rpackning | Points
https://www.alliancememory.com/wp-content/uploads/pdf/ddr4/AllianceMemory_4Gb_DDR4_AS4C256M16D4_August2019_v1.0.pdf | //media.digikey.com/Photos/Alliance%20Memory%20Photos/Alliance-96-TFBGA.jpg | 1450-AS4C256M16D4-83BCN-ND | AS4C256M16D4-83BCN | Alliance Memory, Inc. | 4G, DDR4, 256 X 16, 1.2V, 96-BAL | 904 | 0 | 53.03000 | 1 | TrÃ¥g | Aktiv | DRAM | SDRAM - DDR4 | 4 Gb (256M x 16) | Parallell | 1,2GHz | 15ns | 18ns | 1,14V ~ 1,26V | 0Â°C ~ 95Â°C (TC) | 96-TFBGA | 96-FBGA (7,5x13,5) | 8
https://www.alliancememory.com/wp-content/uploads/pdf/ddr4/AllianceMemory_4Gb_DDR4_AS4C512M8D4_August2019_v1.0.pdf | //media.digikey.com/Photos/Alliance%20Memory%20Photos/Alliance-78-TFBGA.jpg | 1450-AS4C512M8D4-83BCN-ND | AS4C512M8D4-83BCN | Alliance Memory, Inc. | 4G, DDR4, 512 X 8, 1.2V, 78-BALL | 60 | 0 | 53.03000 | 1 | TrÃ¥g | Aktiv | DRAM | SDRAM - DDR4 | 4 Gb (512M x 8) | Parallell | 1,2GHz | 15ns | 18ns | 1,14V ~ 1,26V | 0Â°C ~ 95Â°C (TC) | 78-TFBGA | 78-FBGA (7,5x10,6) | 8
https://www.micron.com/~/media/documents/products/data-sheet/dram/ddr4/4gb_ddr4_sdram.pdf | //media.digikey.com/Renders/Micron%20Renders/557;96FBGA-1.2-9x14;GE;96.jpg | 557-2039-6-ND | MT40A256M16LY-062E AAT:F TR | Micron Technology Inc. | IC DRAM 4G PARALLEL 96FBGA | 13 | 0 | Digi-Reel | 1 | Digi-ReelÂ® | Aktiv | DRAM | SDRAM - DDR4 | 4 Gb (256M x 16) | Parallell | 1,6GHz | 15ns | 19ns | 1,14V ~ 1,26V | -40Â°C ~ 105Â°C (TC) | 96-TFBGA | 96-FBGA (7,5x13,5) | 8
http://insignis-tech.com/download/785 | //media.digikey.com/renders/Insignis%20Tech%20Renders/1982;78FBGA-1-8x10.5;;78.jpg | 1982-1009-2-ND | NDL28PFH-9MET | Insignis Technology Corporation | IC SDRAM 2GBIT 933MHZ 78FBGA | 5000 | 0 | 37.55913 | 2500 | Remsa och spole (TR) | Aktiv | DRAM | SDRAM - DDR3L | 2 Gb (256M x 8) | Parallell | 933MHz | 15ns | 20ns | 1,283V ~ 1,45V | 0Â°C ~ 95Â°C (TC) | 78-VFBGA | 78-FBGA (8x10,5) | 5
 |  |  |  |  |  |  |  |  |  |  |  |  |  |  |  |  |  |  |  |  |  |  | Legend
 |  |  |  |  |  |  |  |  |  |  |  |  |  |  |  |  |  |  |  |  |  |  | -1
 |  |  |  |  |  |  |  |  |  |  |  |  |  |  |  |  |  |  |  |  |  |  | 2
 |  |  |  |  |  |  |  |  |  |  |  |  |  |  |  |  |  |  |  |  |  |  | 1
 |  |  |  |  |  |  |  |  |  |  |  |  |  |  |  |  |  |  |  |  |  |  | 0
