Doomn00b/Open-SVGA/Docs/RAM/digi-dram2.xlsx

Digi-Keys artikelnummer | Tillverkarens artikelnummer | Tillverkare | Enhetspris (SEK) | Minsta tillÃ¥tna antal | Artikelstatus | Teknologi | Minnesstorlek | Klockfrekvens | Ã…tkomsttid | SpÃ¤nning - kÃ¤lla | Arbetstemperatur | Points
1982-1007-1-ND | NDL26PFG-9MIT | Insignis Technology Corporation | 59.41000 | 1 | Aktiv | SDRAM - DDR3L | 2 Gb (128M x 16) | 933MHz | 20ns | 1,283V ~ 1,45V | 0Â°C ~ 95Â°C (TC) | 2
1982-1022-1-ND | NDT16PFJ-9MET | Insignis Technology Corporation | 38.68000 | 1 | Aktiv | SDRAM - DDR3 | 1 Gb (64M x 16) | 933MHz | 20ns | 1,425V ~ 1,575V | 0Â°C ~ 95Â°C (TC) | 2
1982-1007-6-ND | NDL26PFG-9MIT | Insignis Technology Corporation | Digi-Reel | 1 | Aktiv | SDRAM - DDR3L | 2 Gb (128M x 16) | 933MHz | 20ns | 1,283V ~ 1,45V | 0Â°C ~ 95Â°C (TC) | 2
1982-1009-6-ND | NDL28PFH-9MET | Insignis Technology Corporation | Digi-Reel | 1 | Aktiv | SDRAM - DDR3L | 2 Gb (256M x 8) | 933MHz | 20ns | 1,283V ~ 1,45V | 0Â°C ~ 95Â°C (TC) | 2
706-1720-ND | IS43TR16128D-125KBL | ISSI, Integrated Silicon Solution Inc | 36.40000 | 1 | Aktiv | SDRAM - DDR3 | 2 Gb (128M x 16) | 800MHz | 20ns | 1,425V ~ 1,575V | 0Â°C ~ 95Â°C (TC) | 2
706-1722-ND | IS43TR16128DL-107MBL | ISSI, Integrated Silicon Solution Inc | 58.01000 | 1 | Aktiv | SDRAM - DDR3L | 2 Gb (128M x 16) | 933MHz | 20ns | 1,283V ~ 1,45V | 0Â°C ~ 95Â°C (TC) | 2
706-1723-ND | IS43TR16128DL-107MBLI | ISSI, Integrated Silicon Solution Inc | 61.25000 | 1 | Aktiv | SDRAM - DDR3L | 2 Gb (128M x 16) | 933MHz | 20ns | 1,283V ~ 1,45V | -40Â°C ~ 95Â°C (TC) | 2
706-1724-ND | IS43TR16128DL-125KBL | ISSI, Integrated Silicon Solution Inc | 36.40000 | 1 | Aktiv | SDRAM - DDR3L | 2 Gb (128M x 16) | 800MHz | 20ns | 1,283V ~ 1,45V | 0Â°C ~ 95Â°C (TC) | 3
