Doomn00b/Open-SVGA/Docs/RAM/DRAM.xlsx

Mousers artikelnummer | Tillv. delnummer | Tillverk: | PrissÃ¤ttning: | Typ | Organisation | Minnesstorlek | Maximal klockfrekvens | Ã…tkomsttid | Minimal matningsspÃ¤nning | Maximal matningsspÃ¤nning | StrÃ¶mstyrka - Max | Maximal drifttemperatur | Minsta tillÃ¥tna antal | Points | ball-space
340-264444-REEL | MT41K64M16TW-107 XIT:J TR | Micron | 41.78 | SDRAM - DDR3L | 64 M x 16 | 1 Gbit | 933 MHz |  | 1.283 V | 1.45 V | 63 mA | + 95 C |  | 5
340-264443-REEL | MT41K64M16TW-107 AIT:J TR | Micron | 43.66 | SDRAM - DDR3L | 64 M x 16 | 1 Gbit | 933 MHz |  | 1.283 V | 1.45 V | 63 mA | + 95 C |  | 5
340-264442-REEL | MT41K64M16TW-107 AAT:J TR | Micron | 53.14 | SDRAM - DDR3L | 64 M x 16 | 1 Gbit | 933 MHz |  | 1.283 V | 1.45 V | 63 mA | + 105 C |  | 6
 | AS4C256M16D4-83BCN | Alliance Memory, Inc. | 53.03000 | SDRAM - DDR4 | 256M x 16 | 4 Gb | 1,2GHz | 18ns | 1,14V | 1,26V |  | 0°C ~ 95°C | 1 | 7
 |  |  |  |  |  |  |  |  |  |  |  |  |  |  |  | Legend
 |  |  |  |  |  |  |  |  |  |  |  |  |  |  |  | -1
 |  |  |  |  |  |  |  |  |  |  |  |  |  |  |  | 2
 |  |  |  |  |  |  |  |  |  |  |  |  |  |  |  | 1
 |  |  |  |  |  |  |  |  |  |  |  |  |  |  |  | 0
