Doomn00b/Open-SVGA/Docs/datasheets-osvga/connectors/usbc_2012670005.stp

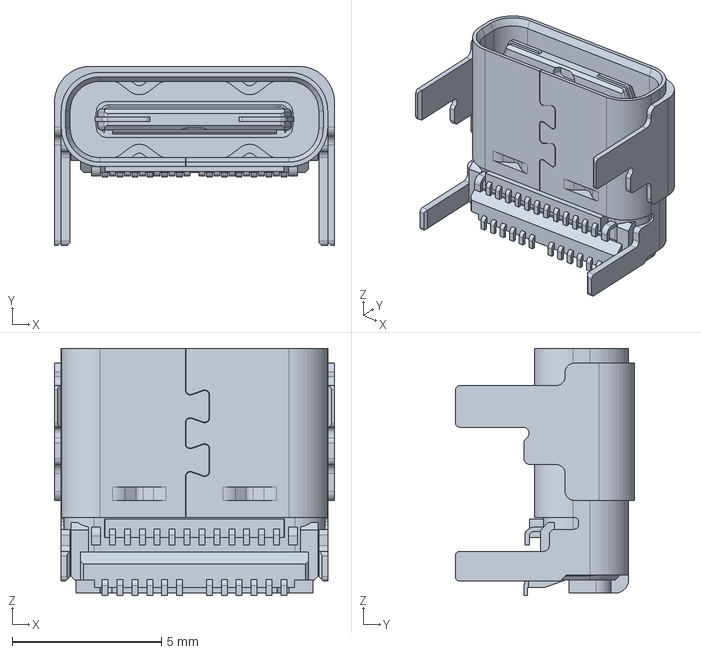
[picture p56: CAD file, 2023-07-09]
Docs/datasheets-osvga/connectors/usbc_2012670005.stp
9.39 x 6.01 x 8.30 mm
