Doomn00b/Open-SVGA/Docs/datasheets-osvga/connectors/DVI_743209010.stp

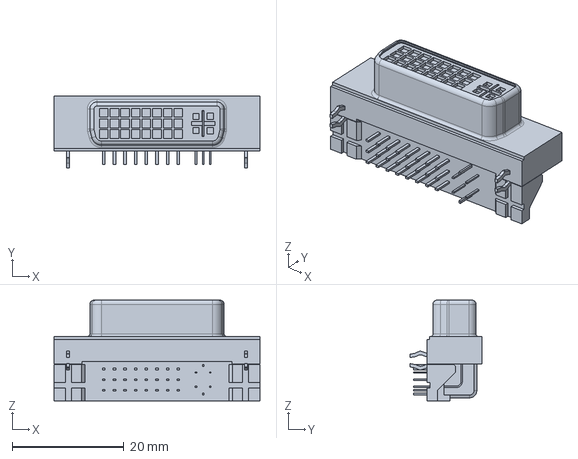
[picture p57: CAD file, 2023-07-09]
Docs/datasheets-osvga/connectors/DVI_743209010.stp
36.8 x 13.0 x 18.0 mm
