Doomn00b/Open-SVGA/Docs/Connectors/USB-C/10133476-10001LF.stp

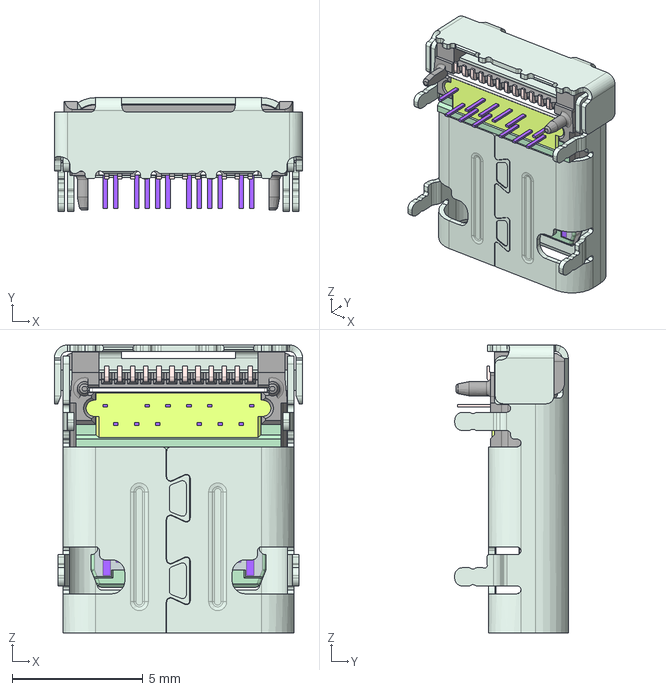
[picture p58: CAD file, 2023-07-09]
Docs/Connectors/USB-C/10133476-10001LF.stp
9.50 x 4.35 x 11.0 mm
