Doomn00b/Open-SVGA/Docs/datasheets-osvga/connectors/61201021721_Download_STP_61201021721_rev1.stp

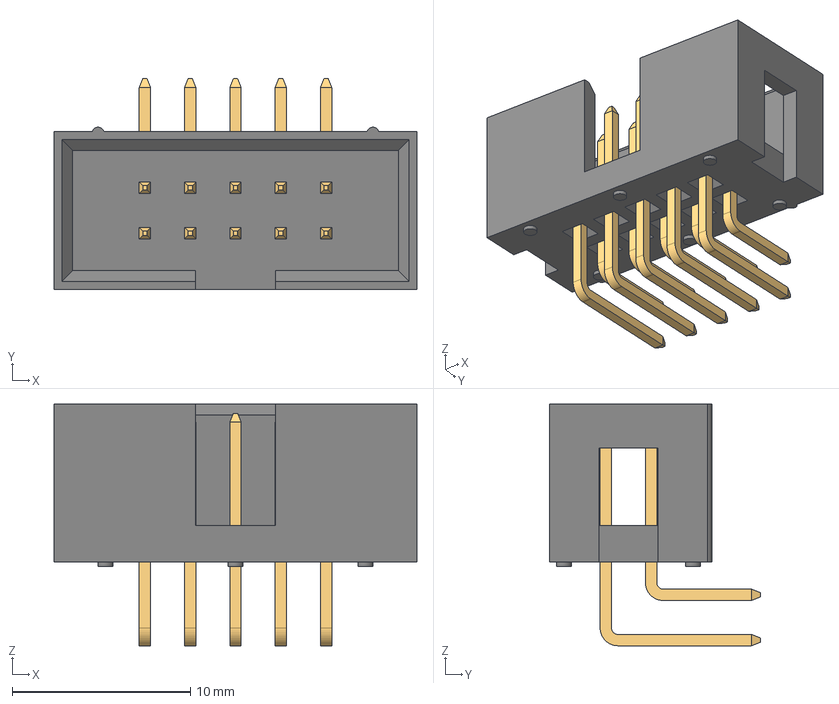
[picture p59: CAD file, 2023-07-09]
Docs/datasheets-osvga/connectors/61201021721_Download_STP_61201021721_rev1.stp
20.4 x 11.8 x 13.6 mm
6120xx21721_PIN x 5
6120xx21721_PIN_LONGUE x 5
