Doomn00b/Open-SVGA/(list of files, cad)

Other CAD files:
Gateware/hdl/altera_plls/stp1.stp
Gateware/hdl/altera_plls/stp_dlp_mc.stp
Gateware/hdl/altera_plls/stp1_mc.stp
