Doomn00b/Open-SVGA/Hardware/PCI-card-template1/PCI-card_template.sch

## KiCad design Hardware/PCI-card-template1/PCI-card_template.sch (2023-07-09)

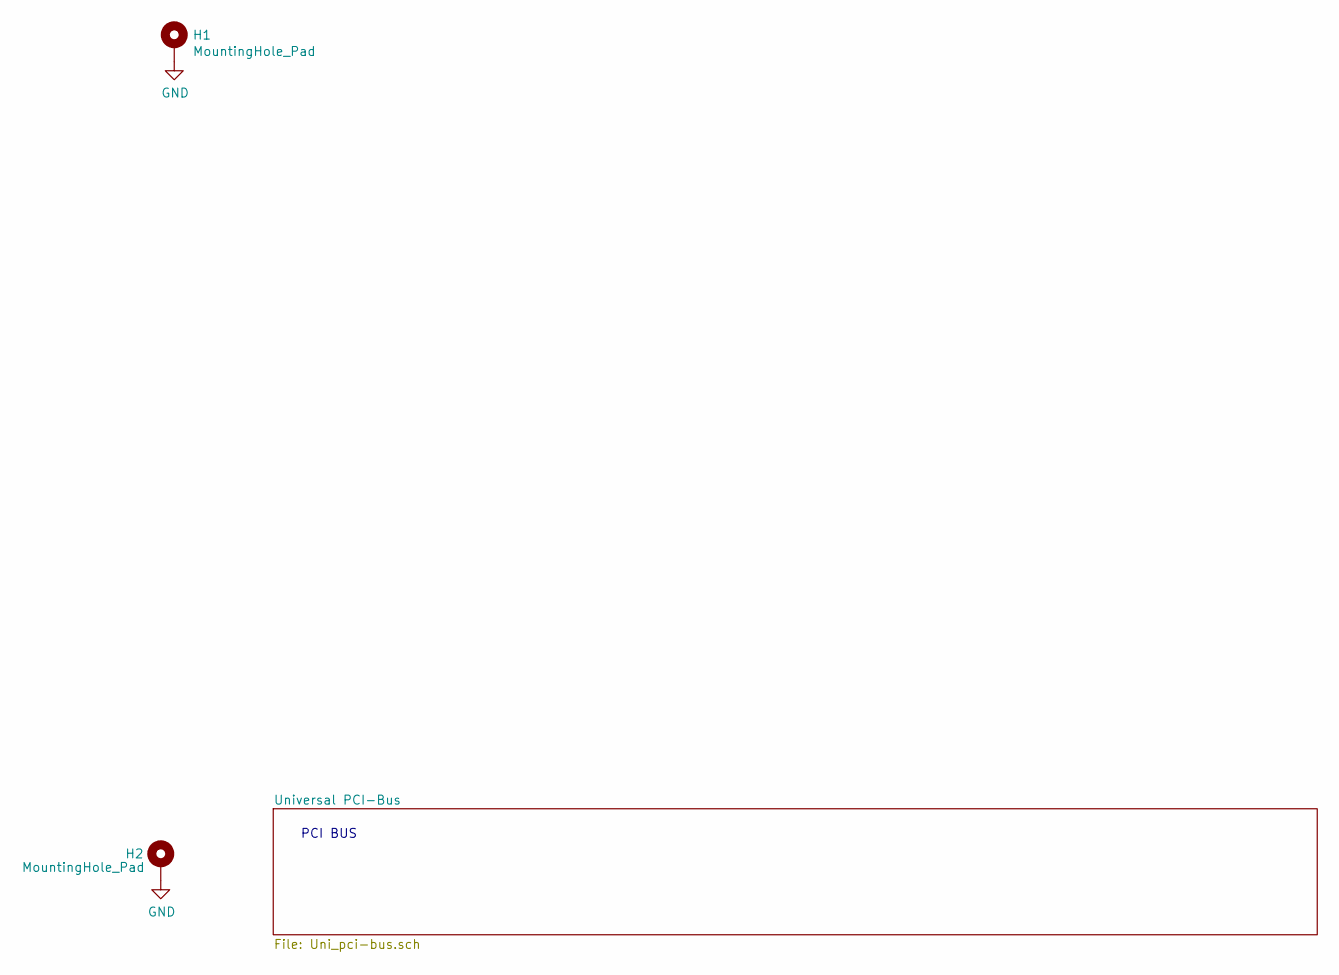
[picture p60: schematic PCI-card_template.sch]

Parts:
H1, H2: MountingHole_Pad; MountingHole_3.2mm_M3_Pad_Via

Connections:
GND: H1.1, H2.1

Notes on the sheet:
PCI BUS
