Doomn00b/Open-SVGA/Hardware/svga-devboard/DAC_osvga.kicad_sch

## KiCad design Hardware/svga-devboard/DAC_osvga.kicad_sch (2023-07-21, an earlier design)

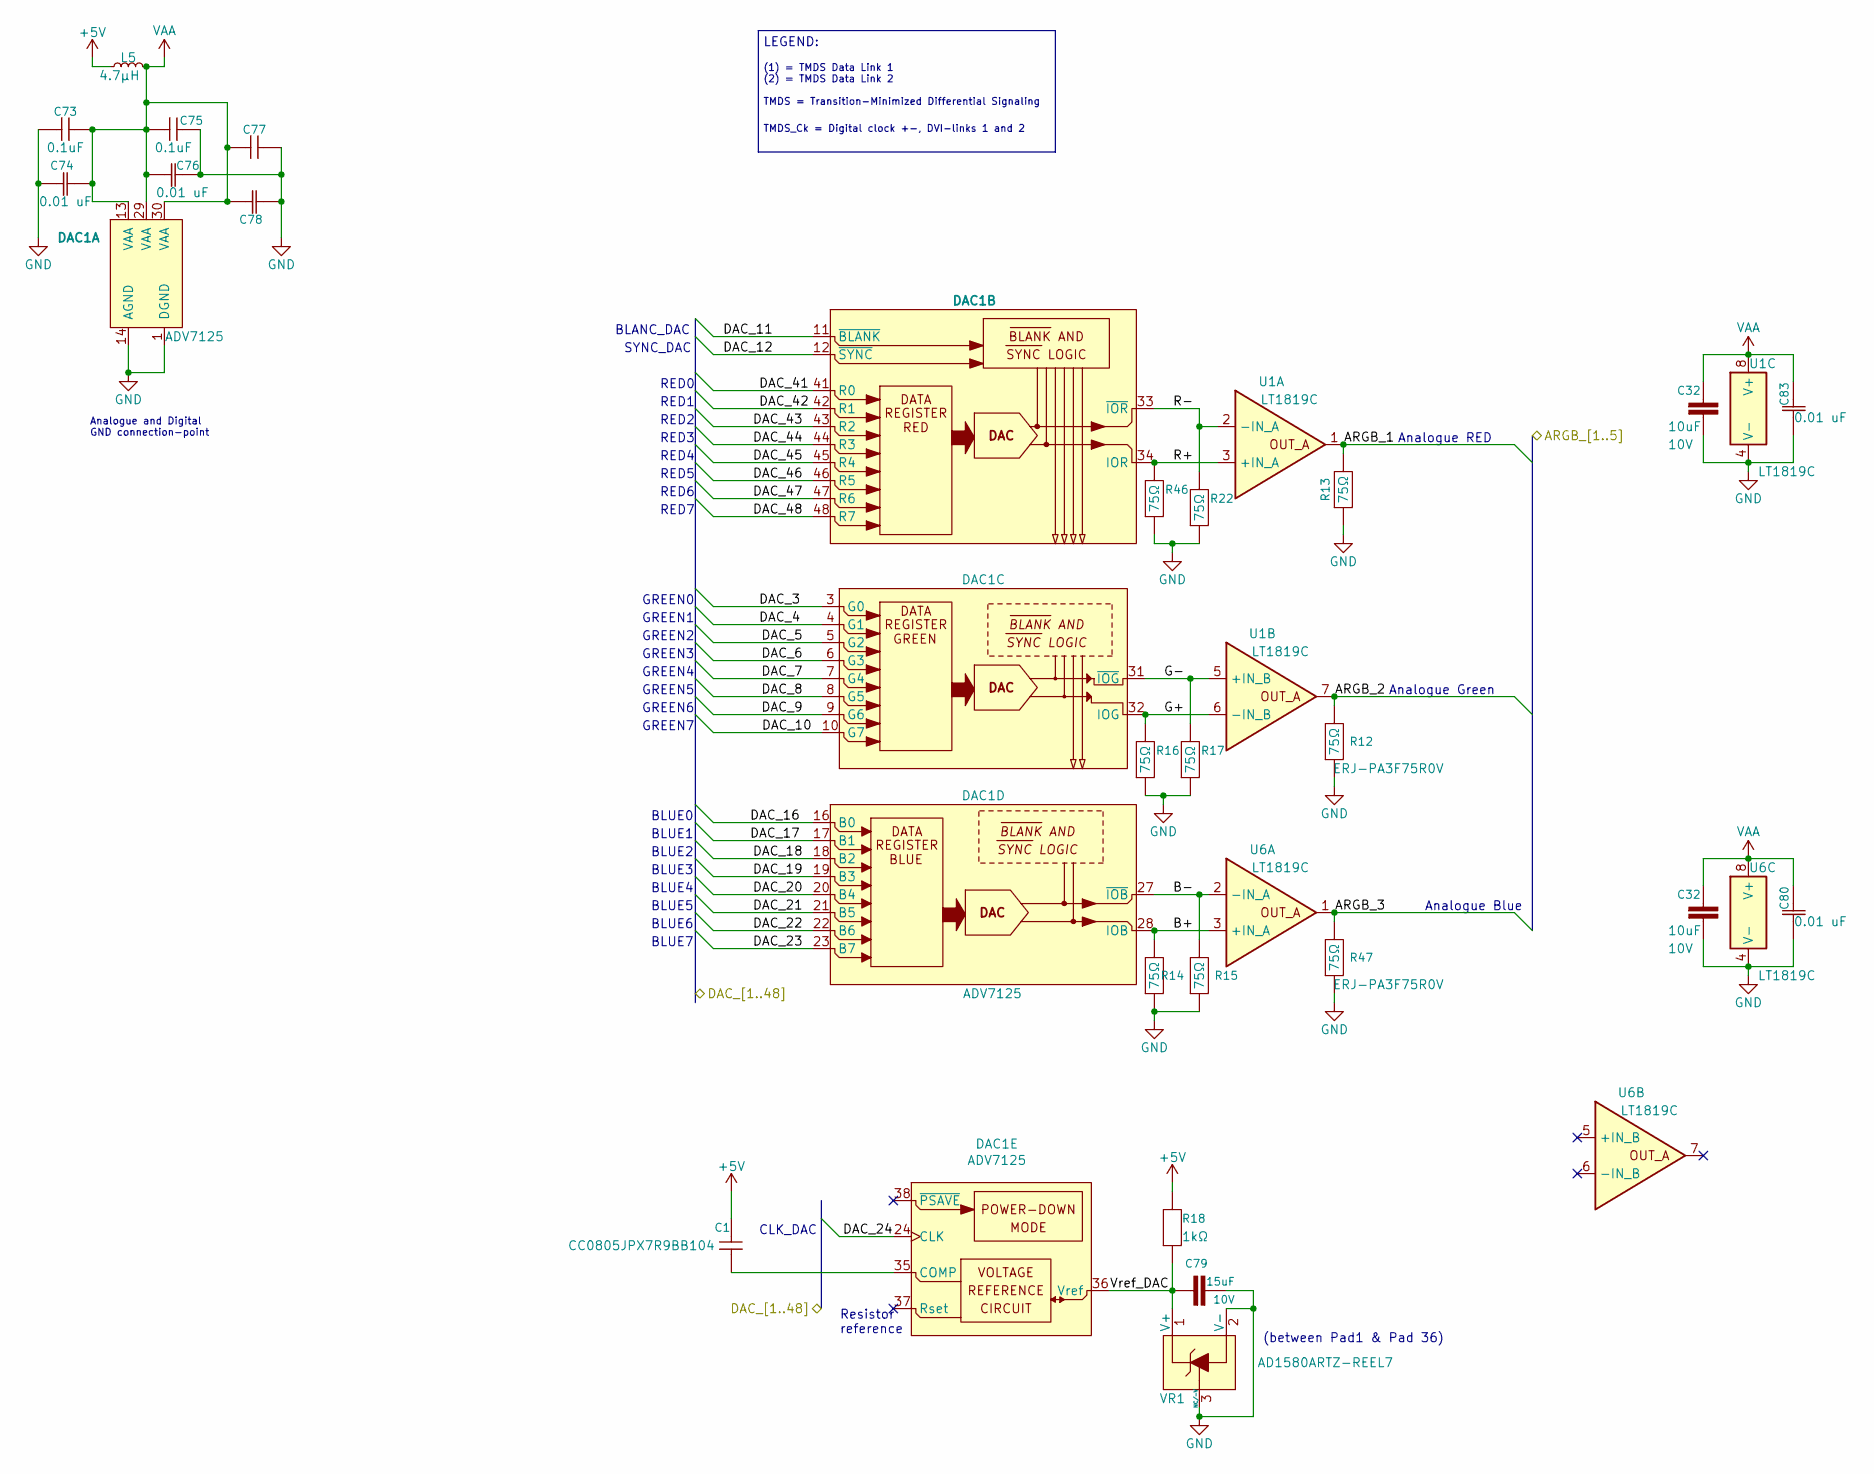
[picture p61: schematic DAC_osvga.kicad_sch]

Parts:
C1, C73, C75, C77: C_CC0805JPX7R9BB104; C_0805_2012Metric; Voltage rating 50V; MPN CC0805JPX7R9BB104
C32: C_GRM21BR71A106KA73K; C_0805_2012Metric_Pad1.18x1.45mm_HandSolder; Voltage rating 10V; Tolerance ±10%; MPN GRM21BR71A106KA73K
C74, C76, C78, C80, C83: C_CL21B103KBANNNC; C_0805_2012Metric; Voltage rating 50V; MPN CL21B103KBANNNC
C79: C_C2012X7S1A156M125AC; C_0805_2012Metric_Pad1.18x1.45mm_HandSolder; Voltage rating 10V; Tolerance ±20%; MPN C2012X7S1A156M125AC
DAC1: ADV7125; LQFP-48_7x7mm_P0.5mm; Voltage rating 7V; Current rating 0.072A; MPN ADV7125KSTZ50
L5: L_MLZ2012M4R7HT000; L_0805_2012Metric; Current Rating 0.4A; MPN MLZ2012M4R7HT000
R12, R13, R14, R15, R16, R17, R22, R46, R47: R_ERJ-PA3F75R0V; R_0603_1608Metric_roundcourt; Voltage rating 49V; Current rating n/a; MPN ERJ-PA3F75R0V
R18: R_ERJ-P06F1001V; R_0805_2012Metric_Pad1.20x1.40mm_HandSolder; Voltage rating 22V; MPN ERJ-P06F1001V
U1, U6: LT1819C; SO-8_3.9x4.9mm_P1.27mm; Voltage rating 12.6V; Current rating 0.07A; MPN LT1819CS8#PBF
VR1: AD1580ARTZ-REEL7; SOT-23-3; MPN AD1580ARTZ-REEL7; Digi-Key_PN AD1580ARTZ-REEL7TR-ND

Connections:
+5V: C1.1, L5.1, R18.2
ARGB_1: R13.2, U1.1 (OUT_A)
ARGB_2: R12.2, U1.7 (OUT_B)
ARGB_3: R47.2, U6.1 (OUT_A)
B+: DAC1.28 (IOB), R14.2, U6.3 (+IN_A)
B-: DAC1.27 (~IOB), R15.2, U6.2 (-IN_A)
DAC_3: DAC1.3 (G0)
DAC_4: DAC1.4 (G1)
DAC_5: DAC1.5 (G2)
DAC_6: DAC1.6 (G3)
DAC_7: DAC1.7 (G4)
DAC_8: DAC1.8 (G5)
DAC_9: DAC1.9 (G6)
DAC_10: DAC1.10 (G7)
DAC_11: DAC1.11 (~BLANK)
DAC_12: DAC1.12 (~SYNC)
DAC_16: DAC1.16 (B0)
DAC_17: DAC1.17 (B1)
DAC_18: DAC1.18 (B2)
DAC_19: DAC1.19 (B3)
DAC_20: DAC1.20 (B4)
DAC_21: DAC1.21 (B5)
DAC_22: DAC1.22 (B6)
DAC_23: DAC1.23 (B7)
DAC_24: DAC1.24 (CLK)
DAC_41: DAC1.41 (R0)
DAC_42: DAC1.42 (R1)
DAC_43: DAC1.43 (R2)
DAC_44: DAC1.44 (R3)
DAC_45: DAC1.45 (R4)
DAC_46: DAC1.46 (R5)
DAC_47: DAC1.47 (R6)
DAC_48: DAC1.48 (R7)
G+: DAC1.32 (IOG), R16.2, U1.6 (-IN_B)
G-: DAC1.31 (~IOG), R17.2, U1.5 (+IN_B)
GND: C32.2, C73.2, C74.1, C75.1, C76.2, C77.1, C78.2, C79.2, C80.1, C83.1, DAC1.1 (DGND), DAC1.2 (DGND), DAC1.14 (AGND), DAC1.15 (DGND), DAC1.25 (DGND), DAC1.26 (AGND), DAC1.39 (DGND), DAC1.40 (DGND), R12.1, R13.1, R14.1, R15.1, R16.1, R17.1, R22.1, R46.1, R47.1, U1.4 (V-), U6.4 (V-), VR1.2 (V-), VR1.3 (NC/-V)
unnamed: C1.2, DAC1.35 (COMP)
R+: DAC1.34 (IOR), R46.2, U1.3 (+IN_A)
R-: DAC1.33 (~IOR), R22.2, U1.2 (-IN_A)
VAA: C32.1, C73.1, C74.2, C75.2, C76.1, C77.2, C78.1, C80.2, C83.2, DAC1.13 (VAA), DAC1.29 (VAA), DAC1.30 (VAA), L5.2, U1.8 (V+), U6.8 (V+)
Vref_DAC: C79.1, DAC1.36 (Vref), R18.1, VR1.1 (V+)

Notes on the sheet:
RED7
RED3
GREEN7
(between Pad1 & Pad 36)
GREEN5
BLUE1
BLUE3
Resistor reference
BLUE6
BLUE7
Analogue and Digital GND connection-point
Analogue RED
BLUE4
GREEN4
BLUE2
BLUE5
BLANC_DAC
Analogue Blue
CLK_DAC
GREEN3
GREEN2
RED5
RED4
GREEN0
Analogue Green
GREEN1
RED6
GREEN6
(1) = TMDS Data Link 1 (2) = TMDS Data Link 2 TMDS = Transition-Minimized Differential Signaling
SYNC_DAC
RED0
RED1
LEGEND:
TMDS_Ck = Digital clock +-, DVI-links 1 and 2
RED2
BLUE0
