Doomn00b/Open-SVGA/Hardware/svga-devboard/VoltTranslate_osvga.kicad_sch

## KiCad design Hardware/svga-devboard/VoltTranslate_osvga.kicad_sch (2023-07-21, an earlier design)

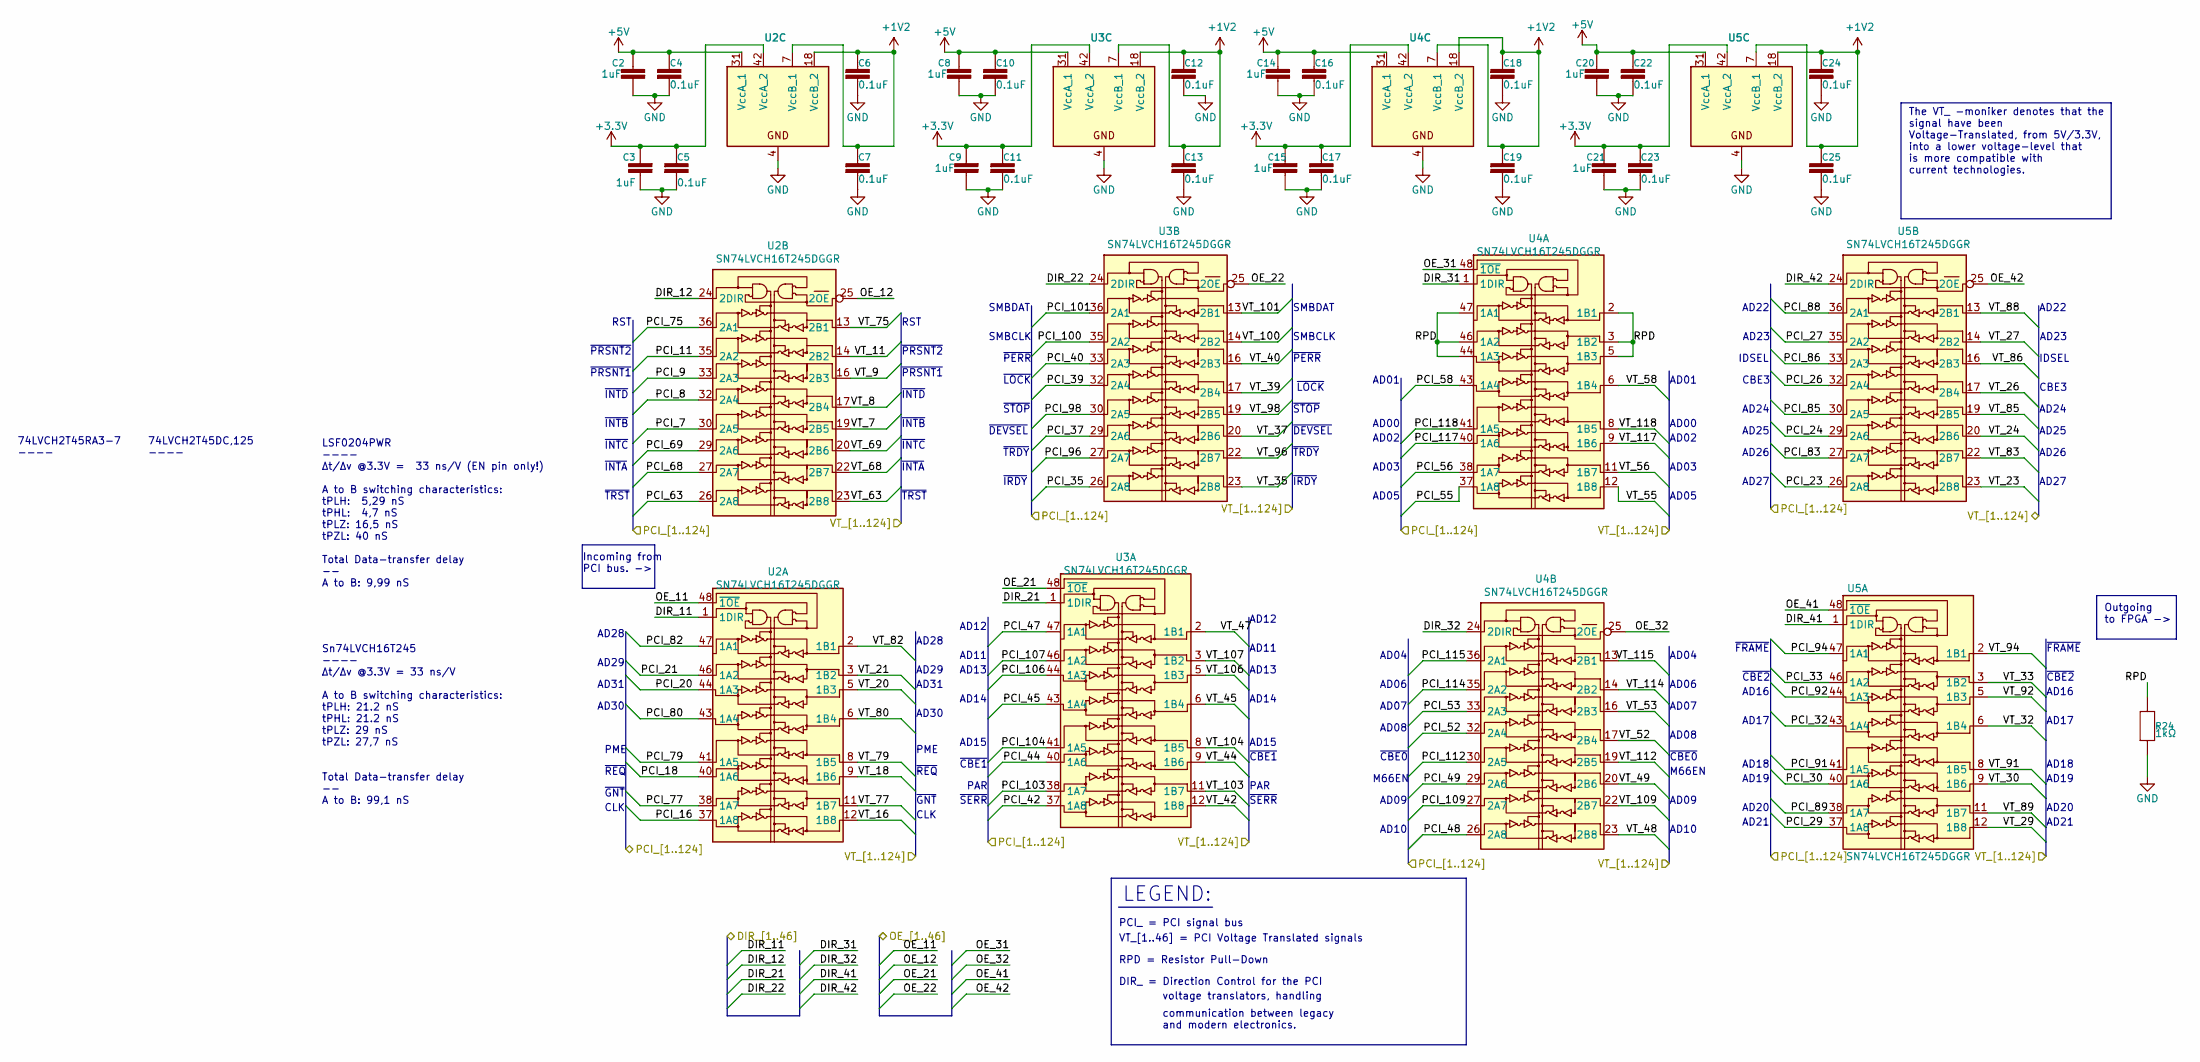
[picture p62: schematic VoltTranslate_osvga.kicad_sch]

Parts:
C2, C3, C8, C9, C14, C15, C20, C21: C_C1206C105K4; C_1206_3216Metric_Pad1.33x1.80mm_HandSolder; MPN C1206C105K4RACTU
C4, C5, C6, C7, C10, C11, C12, C13, C16, C17, C18, C19, C22, C23, C24, C25: VJ1206Y104JXAAR; C_1206_3216Metric; Voltage rating 50V; MPN VJ1206Y104JXAAR
R24: R_ERJ-P06F1001V; R_0805_2012Metric_Pad1.20x1.40mm_HandSolder; Voltage rating 22V; MPN ERJ-P06F1001V
U2, U3, U4, U5: SN74LVCH16T245DGGR; TI_SN74LVCH16T245_6.2x12.6mm_P0.5mm

Connections:
+1V2: C6.1, C7.1, C12.1, C13.1, C18.1, C19.1, C24.1, C25.1, U2.7 (VccB_1), U2.18 (VccB_2), U3.7 (VccB_1), U3.18 (VccB_2), U4.7 (VccB_1), U4.18 (VccB_2), U5.7 (VccB_1), U5.18 (VccB_2)
+3.3V: C3.2, C5.1, C9.2, C11.1, C15.2, C17.1, C21.2, C23.1, U2.42 (VccA_2), U3.42 (VccA_2), U4.42 (VccA_2), U5.42 (VccA_2)
+5V: C2.2, C4.1, C8.2, C10.1, C14.2, C16.1, C20.2, C22.1, U2.31 (VccA_1), U3.31 (VccA_1), U4.31 (VccA_1), U5.31 (VccA_1)
DIR_11: U2.1 (1DIR)
DIR_12: U2.24 (2DIR)
DIR_21: U3.1 (1DIR)
DIR_22: U3.24 (2DIR)
DIR_31: U4.1 (1DIR)
DIR_32: U4.24 (2DIR)
DIR_41: U5.1 (1DIR)
DIR_42: U5.24 (2DIR)
GND: C2.1, C3.1, C4.2, C5.2, C6.2, C7.2, C8.1, C9.1, C10.2, C11.2, C12.2, C13.2, C14.1, C15.1, C16.2, C17.2, C18.2, C19.2, C20.1, C21.1, C22.2, C23.2, C24.2, C25.2, R24.1, U2.4 (GND), U2.10 (GND_2), U2.15 (GND_3), U2.21 (GND_4), U2.28 (GND_5), U2.34 (GND_6), U2.39 (GND_7), U2.45 (GND_8), U3.4 (GND), U3.10 (GND_2), U3.15 (GND_3), U3.21 (GND_4), U3.28 (GND_5), U3.34 (GND_6), U3.39 (GND_7), U3.45 (GND_8), U4.4 (GND), U4.10 (GND_2), U4.15 (GND_3), U4.21 (GND_4), U4.28 (GND_5), U4.34 (GND_6), U4.39 (GND_7), U4.45 (GND_8), U5.4 (GND), U5.10 (GND_2), U5.15 (GND_3), U5.21 (GND_4), U5.28 (GND_5), U5.34 (GND_6), U5.39 (GND_7), U5.45 (GND_8)
OE_11: U2.48 (~1OE)
OE_12: U2.25 (2OE)
OE_21: U3.48 (~1OE)
OE_22: U3.25 (2OE)
OE_31: U4.48 (~1OE)
OE_32: U4.25 (2OE)
OE_41: U5.48 (~1OE)
OE_42: U5.25 (2OE)
PCI_7: U2.30 (2A5)
PCI_8: U2.32 (2A4)
PCI_9: U2.33 (2A3)
PCI_11: U2.35 (2A2)
PCI_16: U2.37 (1A8)
PCI_18: U2.40 (1A6)
PCI_20: U2.44 (1A3)
PCI_21: U2.46 (1A2)
PCI_23: U5.26 (2A8)
PCI_24: U5.29 (2A6)
PCI_26: U5.32 (2A4)
PCI_27: U5.35 (2A2)
PCI_29: U5.37 (1A8)
PCI_30: U5.40 (1A6)
PCI_32: U5.43 (1A4)
PCI_33: U5.46 (1A2)
PCI_35: U3.26 (2A8)
PCI_37: U3.29 (2A6)
PCI_39: U3.32 (2A4)
PCI_40: U3.33 (2A3)
PCI_42: U3.37 (1A8)
PCI_44: U3.40 (1A6)
PCI_45: U3.43 (1A4)
PCI_47: U3.47 (1A1)
PCI_48: U4.26 (2A8)
PCI_49: U4.29 (2A6)
PCI_52: U4.32 (2A4)
PCI_53: U4.33 (2A3)
PCI_55: U4.37 (1A8)
PCI_56: U4.38 (1A7)
PCI_58: U4.43 (1A4)
PCI_63: U2.26 (2A8)
PCI_68: U2.27 (2A7)
PCI_69: U2.29 (2A6)
PCI_75: U2.36 (2A1)
PCI_77: U2.38 (1A7)
PCI_79: U2.41 (1A5)
PCI_80: U2.43 (1A4)
PCI_82: U2.47 (1A1)
PCI_83: U5.27 (2A7)
PCI_85: U5.30 (2A5)
PCI_86: U5.33 (2A3)
PCI_88: U5.36 (2A1)
PCI_89: U5.38 (1A7)
PCI_91: U5.41 (1A5)
PCI_92: U5.44 (1A3)
PCI_94: U5.47 (1A1)
PCI_96: U3.27 (2A7)
PCI_98: U3.30 (2A5)
PCI_100: U3.35 (2A2)
PCI_101: U3.36 (2A1)
PCI_103: U3.38 (1A7)
PCI_104: U3.41 (1A5)
PCI_106: U3.44 (1A3)
PCI_107: U3.46 (1A2)
PCI_109: U4.27 (2A7)
PCI_112: U4.30 (2A5)
PCI_114: U4.35 (2A2)
PCI_115: U4.36 (2A1)
PCI_117: U4.40 (1A6)
PCI_118: U4.41 (1A5)
RPD: R24.2, U4.2 (1B1), U4.3 (1B2), U4.5 (1B3), U4.44 (1A3), U4.46 (1A2), U4.47 (1A1)
VT_7: U2.19 (2B5)
VT_8: U2.17 (2B4)
VT_9: U2.16 (2B3)
VT_11: U2.14 (2B2)
VT_16: U2.12 (1B8)
VT_18: U2.9 (1B6)
VT_20: U2.5 (1B3)
VT_21: U2.3 (1B2)
VT_23: U5.23 (2B8)
VT_24: U5.20 (2B6)
VT_26: U5.17 (2B4)
VT_27: U5.14 (2B2)
VT_29: U5.12 (1B8)
VT_30: U5.9 (1B6)
VT_32: U5.6 (1B4)
VT_33: U5.3 (1B2)
VT_35: U3.23 (2B8)
VT_37: U3.20 (2B6)
VT_39: U3.17 (2B4)
VT_40: U3.16 (2B3)
VT_42: U3.12 (1B8)
VT_44: U3.9 (1B6)
VT_45: U3.6 (1B4)
VT_47: U3.2 (1B1)
VT_48: U4.23 (2B8)
VT_49: U4.20 (2B6)
VT_52: U4.17 (2B4)
VT_53: U4.16 (2B3)
VT_55: U4.12 (1B8)
VT_56: U4.11 (1B7)
VT_58: U4.6 (1B4)
VT_63: U2.23 (2B8)
VT_68: U2.22 (2B7)
VT_69: U2.20 (2B6)
VT_75: U2.13 (2B1)
VT_77: U2.11 (1B7)
VT_79: U2.8 (1B5)
VT_80: U2.6 (1B4)
VT_82: U2.2 (1B1)
VT_83: U5.22 (2B7)
VT_85: U5.19 (2B5)
VT_86: U5.16 (2B3)
VT_88: U5.13 (2B1)
VT_89: U5.11 (1B7)
VT_91: U5.8 (1B5)
VT_92: U5.5 (1B3)
VT_94: U5.2 (1B1)
VT_96: U3.22 (2B7)
VT_98: U3.19 (2B5)
VT_100: U3.14 (2B2)
VT_101: U3.13 (2B1)
VT_103: U3.11 (1B7)
VT_104: U3.8 (1B5)
VT_106: U3.5 (1B3)
VT_107: U3.3 (1B2)
VT_109: U4.22 (2B7)
VT_112: U4.19 (2B5)
VT_114: U4.14 (2B2)
VT_115: U4.13 (2B1)
VT_117: U4.9 (1B6)
VT_118: U4.8 (1B5)

Notes on the sheet:
AD17
~{INTD}
CLK
AD14
AD19
AD30
~{SERR}
AD07
AD16
AD04
AD27
AD13
RST
~{REQ}
AD08
PME
Sn74LVCH16T245 ---- Δt/Δv @3.3V = 33 ns/V A to B switching characteristics: tPLH: 21.2 nS tPHL: 21.2 nS tPLZ: 29 nS tPZL: 27,7 nS Total Data-transfer delay -- A to B: 99,1 nS
AD09
SMBDAT
SMBCLK
CBE3
M66EN
AD24
The VT_ -moniker denotes that the signal have been Voltage-Translated, from 5V/3.3V, into a lower voltage-level that is more compatible with current technologies.
~{LOCK}
~{TRST}
AD25
AD20
AD18
~{TRDY}
~{INTB}
~{CBE2}
AD06
~{PERR}
AD15
~{DEVSEL}
AD29
AD12
AD21
~{STOP}
74LVCH2T45RA3-7 ----
AD03
AD11
~{CBE0}
AD23
~{IRDY}
~{GNT}
~{INTA}
74LVCH2T45DC,125 ----
~{PRSNT1}
AD26
AD02
~{FRAME}
AD00
LSF0204PWR ---- Δt/Δv @3.3V = 33 ns/V (EN pin only!) A to B switching characteristics: tPLH: 5,29 nS tPHL: 4,7 nS tPLZ: 16,5 nS tPZL: 40 nS Total Data-transfer delay -- A to B: 9,99 nS
communication between legacy and modern electronics.
AD28
AD05
IDSEL
AD22
Incoming from PCI bus. ->
~{CBE1}
AD10
RPD = Resistor Pull-Down
VT_[1..46] = PCI Voltage Translated signals
PAR
AD01
AD31
~{INTC}
~{PRSNT2}
DIR_ = Direction Control for the PCI
PCI_ = PCI signal bus
LEGEND:
Outgoing to FPGA ->
voltage translators, handling
