Doomn00b/Open-SVGA/Hardware/svga-devboard/dram_osvga.kicad_sch

## KiCad design Hardware/svga-devboard/dram_osvga.kicad_sch (2023-07-21, an earlier design)

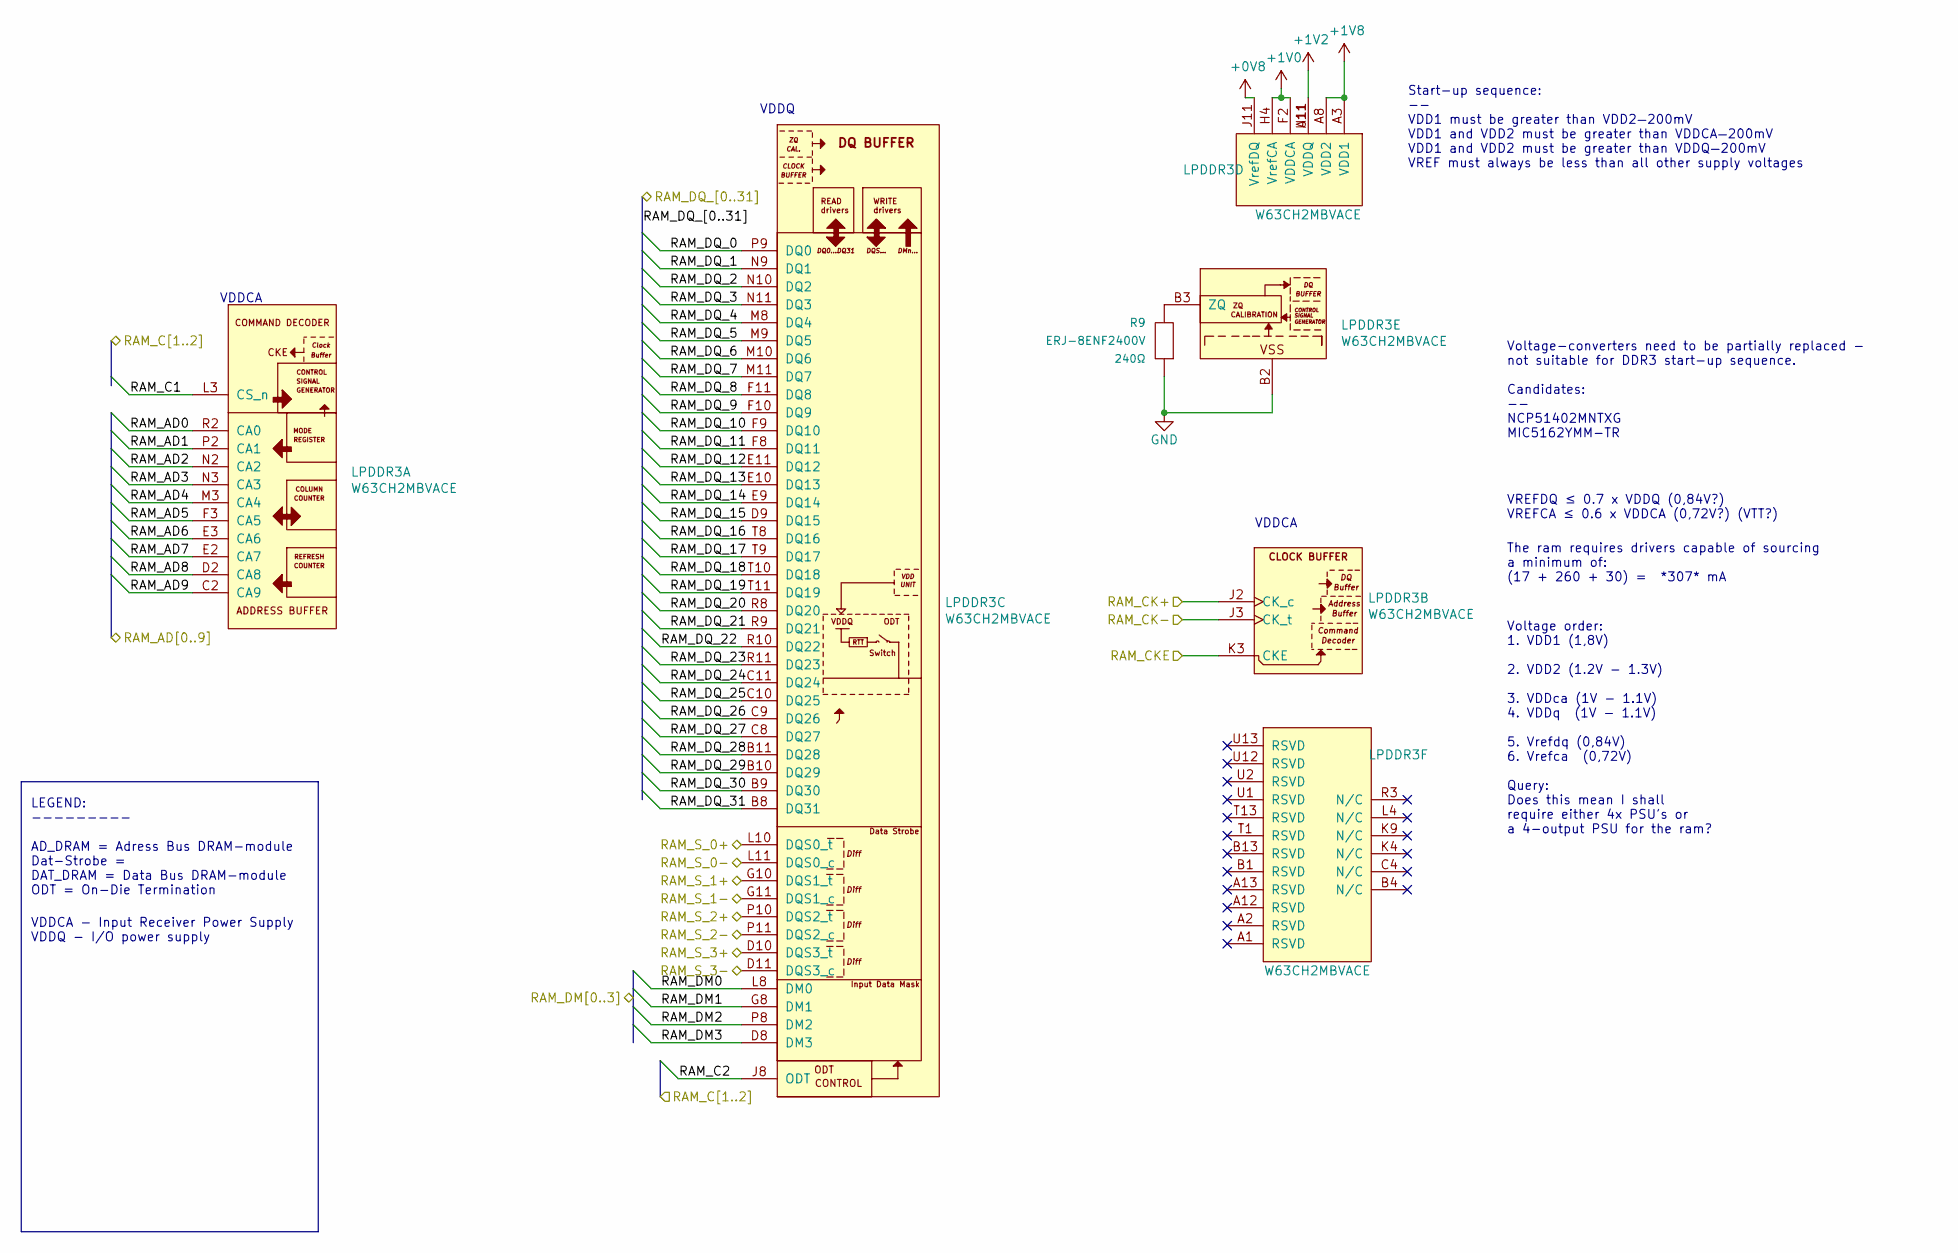
[picture p63: schematic dram_osvga.kicad_sch]

Parts:
LPDDR3: W63CH2MBVACE; Winbond_VFBGA-178_W63CH2MBVACE
R9: ERJ-8ENF2400V; R_1206_3216Metric; Tolerance ±1%; Voltage rating 200V; MPN ERJ-8ENF2400V

Connections:
+0V8: LPDDR3.J11 (VrefDQ)
+1V0: LPDDR3.F2 (VDDCA), LPDDR3.G2 (VDDCA), LPDDR3.H3 (VDDCA), LPDDR3.H4 (VrefCA), LPDDR3.L2 (VDDCA), LPDDR3.M2 (VDDCA)
+1V2: LPDDR3.A11 (VDDQ), LPDDR3.C12 (VDDQ), LPDDR3.E8 (VDDQ), LPDDR3.E12 (VDDQ), LPDDR3.G12 (VDDQ), LPDDR3.H8 (VDDQ), LPDDR3.H9 (VDDQ), LPDDR3.H11 (VDDQ), LPDDR3.J9 (VDDQ), LPDDR3.J10 (VDDQ), LPDDR3.K8 (VDDQ), LPDDR3.K11 (VDDQ), LPDDR3.L12 (VDDQ), LPDDR3.N8 (VDDQ), LPDDR3.N12 (VDDQ), LPDDR3.R12 (VDDQ), LPDDR3.U11 (VDDQ)
+1V8: LPDDR3.A3 (VDD1), LPDDR3.A4 (VDD1), LPDDR3.A5 (VDD1), LPDDR3.A6 (VDD1), LPDDR3.A8 (VDD2), LPDDR3.A9 (VDD2), LPDDR3.A10 (VDD1), LPDDR3.D4 (VDD2), LPDDR3.D5 (VDD2), LPDDR3.D6 (VDD2), LPDDR3.G5 (VDD2), LPDDR3.H5 (VDD2), LPDDR3.H6 (VDD2), LPDDR3.H12 (VDD2), LPDDR3.J5 (VDD2), LPDDR3.J6 (VDD2), LPDDR3.K5 (VDD2), LPDDR3.K6 (VDD2), LPDDR3.K12 (VDD2), LPDDR3.L5 (VDD2), LPDDR3.P4 (VDD2), LPDDR3.P5 (VDD2), LPDDR3.P6 (VDD2), LPDDR3.U3 (VDD1), LPDDR3.U4 (VDD1), LPDDR3.U5 (VDD1), LPDDR3.U6 (VDD1), LPDDR3.U8 (VDD2), LPDDR3.U9 (VDD2), LPDDR3.U10 (VDD1)
GND: LPDDR3.B2 (VSS), LPDDR3.B5 (VSS), LPDDR3.B6 (VSS), LPDDR3.B12 (VSS), LPDDR3.C3 (VSS), LPDDR3.C5 (VSS), LPDDR3.C6 (VSS), LPDDR3.D3 (VSS), LPDDR3.D12 (VSS), LPDDR3.E4 (VSS), LPDDR3.E5 (VSS), LPDDR3.E6 (VSS), LPDDR3.F4 (VSS), LPDDR3.F5 (VSS), LPDDR3.F6 (VSS), LPDDR3.F12 (VSS), LPDDR3.G3 (VSS), LPDDR3.G4 (VSS), LPDDR3.G6 (VSS), LPDDR3.G9 (VSS), LPDDR3.H2 (VSS), LPDDR3.H10 (VSS), LPDDR3.J4 (VSS), LPDDR3.J12 (VSS), LPDDR3.K2 (VSS), LPDDR3.K10 (VSS), LPDDR3.L6 (VSS), LPDDR3.L9 (VSS), LPDDR3.M4 (VSS), LPDDR3.M5 (VSS), LPDDR3.M6 (VSS), LPDDR3.M12 (VSS), LPDDR3.N4 (VSS), LPDDR3.N5 (VSS), LPDDR3.N6 (VSS), LPDDR3.P3 (VSS), LPDDR3.P12 (VSS), LPDDR3.R4 (VSS), LPDDR3.R5 (VSS), LPDDR3.R6 (VSS), LPDDR3.T2 (VSS), LPDDR3.T3 (VSS), LPDDR3.T4 (VSS), LPDDR3.T5 (VSS), LPDDR3.T6 (VSS), LPDDR3.T12 (VSS), R9.1
unnamed: LPDDR3.B3 (ZQ), R9.2
RAM_AD0: LPDDR3.R2 (CA0)
RAM_AD1: LPDDR3.P2 (CA1)
RAM_AD2: LPDDR3.N2 (CA2)
RAM_AD3: LPDDR3.N3 (CA3)
RAM_AD4: LPDDR3.M3 (CA4)
RAM_AD5: LPDDR3.F3 (CA5)
RAM_AD6: LPDDR3.E3 (CA6)
RAM_AD7: LPDDR3.E2 (CA7)
RAM_AD8: LPDDR3.D2 (CA8)
RAM_AD9: LPDDR3.C2 (CA9)
RAM_C1: LPDDR3.L3 (CS_n)
RAM_C2: LPDDR3.J8 (ODT)
RAM_CK+: LPDDR3.J2 (CK_c)
RAM_CK-: LPDDR3.J3 (CK_t)
RAM_CKE: LPDDR3.K3 (CKE)
RAM_DM0: LPDDR3.L8 (DM0)
RAM_DM1: LPDDR3.G8 (DM1)
RAM_DM2: LPDDR3.P8 (DM2)
RAM_DM3: LPDDR3.D8 (DM3)
RAM_DQ_0: LPDDR3.P9 (DQ0)
RAM_DQ_1: LPDDR3.N9 (DQ1)
RAM_DQ_2: LPDDR3.N10 (DQ2)
RAM_DQ_3: LPDDR3.N11 (DQ3)
RAM_DQ_4: LPDDR3.M8 (DQ4)
RAM_DQ_5: LPDDR3.M9 (DQ5)
RAM_DQ_6: LPDDR3.M10 (DQ6)
RAM_DQ_7: LPDDR3.M11 (DQ7)
RAM_DQ_8: LPDDR3.F11 (DQ8)
RAM_DQ_9: LPDDR3.F10 (DQ9)
RAM_DQ_10: LPDDR3.F9 (DQ10)
RAM_DQ_11: LPDDR3.F8 (DQ11)
RAM_DQ_12: LPDDR3.E11 (DQ12)
RAM_DQ_13: LPDDR3.E10 (DQ13)
RAM_DQ_14: LPDDR3.E9 (DQ14)
RAM_DQ_15: LPDDR3.D9 (DQ15)
RAM_DQ_16: LPDDR3.T8 (DQ16)
RAM_DQ_17: LPDDR3.T9 (DQ17)
RAM_DQ_18: LPDDR3.T10 (DQ18)
RAM_DQ_19: LPDDR3.T11 (DQ19)
RAM_DQ_20: LPDDR3.R8 (DQ20)
RAM_DQ_21: LPDDR3.R9 (DQ21)
RAM_DQ_22: LPDDR3.R10 (DQ22)
RAM_DQ_23: LPDDR3.R11 (DQ23)
RAM_DQ_24: LPDDR3.C11 (DQ24)
RAM_DQ_25: LPDDR3.C10 (DQ25)
RAM_DQ_26: LPDDR3.C9 (DQ26)
RAM_DQ_27: LPDDR3.C8 (DQ27)
RAM_DQ_28: LPDDR3.B11 (DQ28)
RAM_DQ_29: LPDDR3.B10 (DQ29)
RAM_DQ_30: LPDDR3.B9 (DQ30)
RAM_DQ_31: LPDDR3.B8 (DQ31)
RAM_S_0+: LPDDR3.L10 (DQS0_t)
RAM_S_0-: LPDDR3.L11 (DQS0_c)
RAM_S_1+: LPDDR3.G10 (DQS1_t)
RAM_S_1-: LPDDR3.G11 (DQS1_c)
RAM_S_2+: LPDDR3.P10 (DQS2_t)
RAM_S_2-: LPDDR3.P11 (DQS2_c)
RAM_S_3+: LPDDR3.D10 (DQS3_t)
RAM_S_3-: LPDDR3.D11 (DQS3_c)

Notes on the sheet:
VDDQ
The ram requires drivers capable of sourcing a minimum of: (17 + 260 + 30) = *307* mA
Start-up sequence: -- VDD1 must be greater than VDD2—200mV VDD1 and VDD2 must be greater than VDDCA—200mV VDD1 and VDD2 must be greater than VDDQ—200mV VREF must always be less than all other supply voltages
Voltage-converters need to be partially replaced - not suitable for DDR3 start-up sequence. Candidates: -- NCP51402MNTXG MIC5162YMM-TR
LEGEND: --------- AD_DRAM = Adress Bus DRAM-module Dat-Strobe = DAT_DRAM = Data Bus DRAM-module ODT = On-Die Termination
VDDCA
VDDCA - Input Receiver Power Supply VDDQ - I/O power supply
VREFDQ ≤ 0.7 x VDDQ (0,84V?) VREFCA ≤ 0.6 x VDDCA (0,72V?) (VTT?)
Voltage order: 1. VDD1 (1,8V) 2. VDD2 (1.2V - 1.3V) 3. VDDca (1V - 1.1V) 4. VDDq (1V - 1.1V) 5. Vrefdq (0,84V) 6. Vrefca (0,72V) Query: Does this mean I shall require either 4x PSU's or a 4-output PSU for the ram?
