Doomn00b/Open-SVGA/Hardware/svga-devboard/jtag_osvga.kicad_sch

## KiCad design Hardware/svga-devboard/jtag_osvga.kicad_sch (2023-07-21, an earlier design)

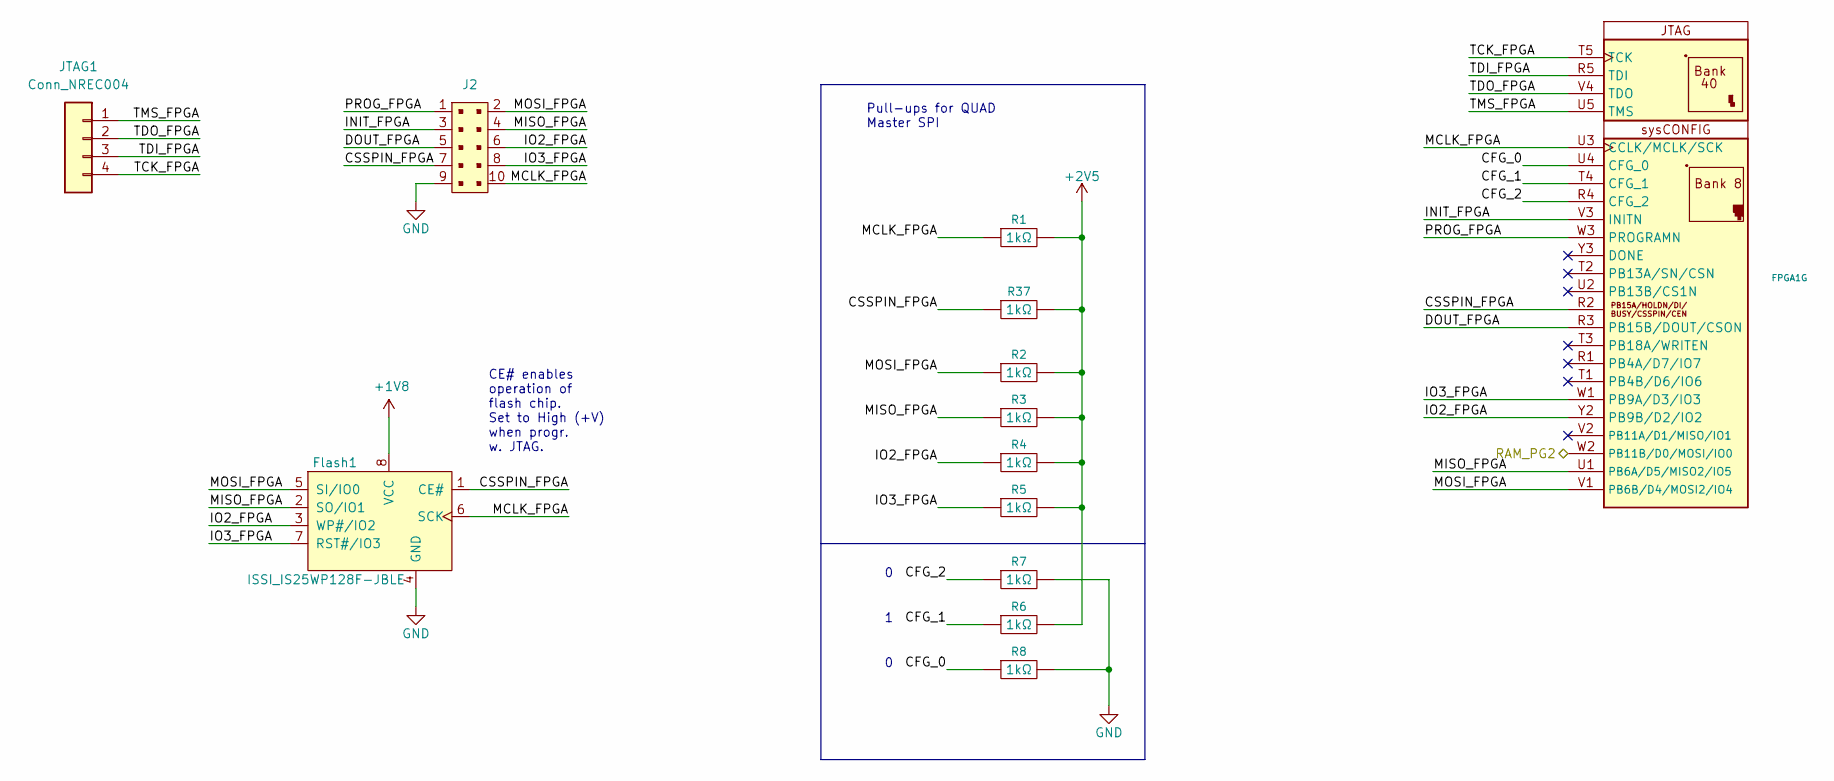
[picture p64: schematic jtag_osvga.kicad_sch]

Parts:
FPGA1: LFE5U-85F-8BG381; Lattice_caBGA-381_17.0x17.0_Layout18x18_P0.8_Ball0.4_Pad0.4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; Voltage rating 3.63V; MPN LFE5U-85F-8BG381
Flash1: ISSI_IS25WP128F-JBLE; SOIC-8_5.28x5.28mm_P1.27mm
J2: Wurth_WR-BHD_61201021721; Wuerth_WR-BHD_61201021721_2x05_P2.54mm_Horizontal; MPN 61201021721
JTAG1: Conn_NREC004; PinHeader_1x04_P2.54mm_Vertical_SMD_Pin1Right; Current Rating 3A; MPN NREC004SABC-M30RC
R1, R2, R3, R4, R5, R6, R7, R8, R37: R_ERJ-P06F1001V; R_0805_2012Metric_Pad1.20x1.40mm_HandSolder; Voltage rating 22V; MPN ERJ-P06F1001V

Connections:
+1V8: Flash1.8 (VCC)
+2V5: R1.2, R2.2, R3.2, R4.2, R5.2, R6.2, R37.2
CFG_0: FPGA1.U4 (CFG_0), R8.1
CFG_1: FPGA1.T4 (CFG_1), R6.1
CFG_2: FPGA1.R4 (CFG_2), R7.1
CSSPIN_FPGA: FPGA1.R2 (PB15A/HOLDN/DI/BUSY/CSSPIN/CEN), Flash1.1 (CE#), J2.7, R37.1
DOUT_FPGA: FPGA1.R3 (PB15B/DOUT/CSON), J2.5
GND: Flash1.4 (GND), J2.9, R7.2, R8.2
INIT_FPGA: FPGA1.V3 (INITN), J2.3
IO2_FPGA: FPGA1.Y2 (PB9B/D2/IO2), Flash1.3 (WP#/IO2), J2.6, R4.1
IO3_FPGA: FPGA1.W1 (PB9A/D3/IO3), Flash1.7 (RST#/IO3), J2.8, R5.1
MCLK_FPGA: FPGA1.U3 (CCLK/MCLK/SCK), Flash1.6 (SCK), J2.10, R1.1
MISO_FPGA: FPGA1.U1 (PB6A/D5/MISO2/IO5), Flash1.2 (SO/IO1), J2.4, R3.1
MOSI_FPGA: FPGA1.V1 (PB6B/D4/MOSI2/IO4), Flash1.5 (SI/IO0), J2.2, R2.1
PROG_FPGA: FPGA1.W3 (PROGRAMN), J2.1
RAM_PG2: FPGA1.W2 (PB11B/D0/MOSI/IO0)
TCK_FPGA: FPGA1.T5 (TCK), JTAG1.4
TDI_FPGA: FPGA1.R5 (TDI), JTAG1.3
TDO_FPGA: FPGA1.V4 (TDO), JTAG1.2
TMS_FPGA: FPGA1.U5 (TMS), JTAG1.1

Notes on the sheet:
Pull-ups for QUAD Master SPI
CE# enables operation of flash chip. Set to High (+V) when progr. w. JTAG.
