Doomn00b/Open-SVGA/Hardware/svga-devboard/pci-bus_osvga.kicad_sch

## KiCad design Hardware/svga-devboard/pci-bus_osvga.kicad_sch (2023-07-21, an earlier design)

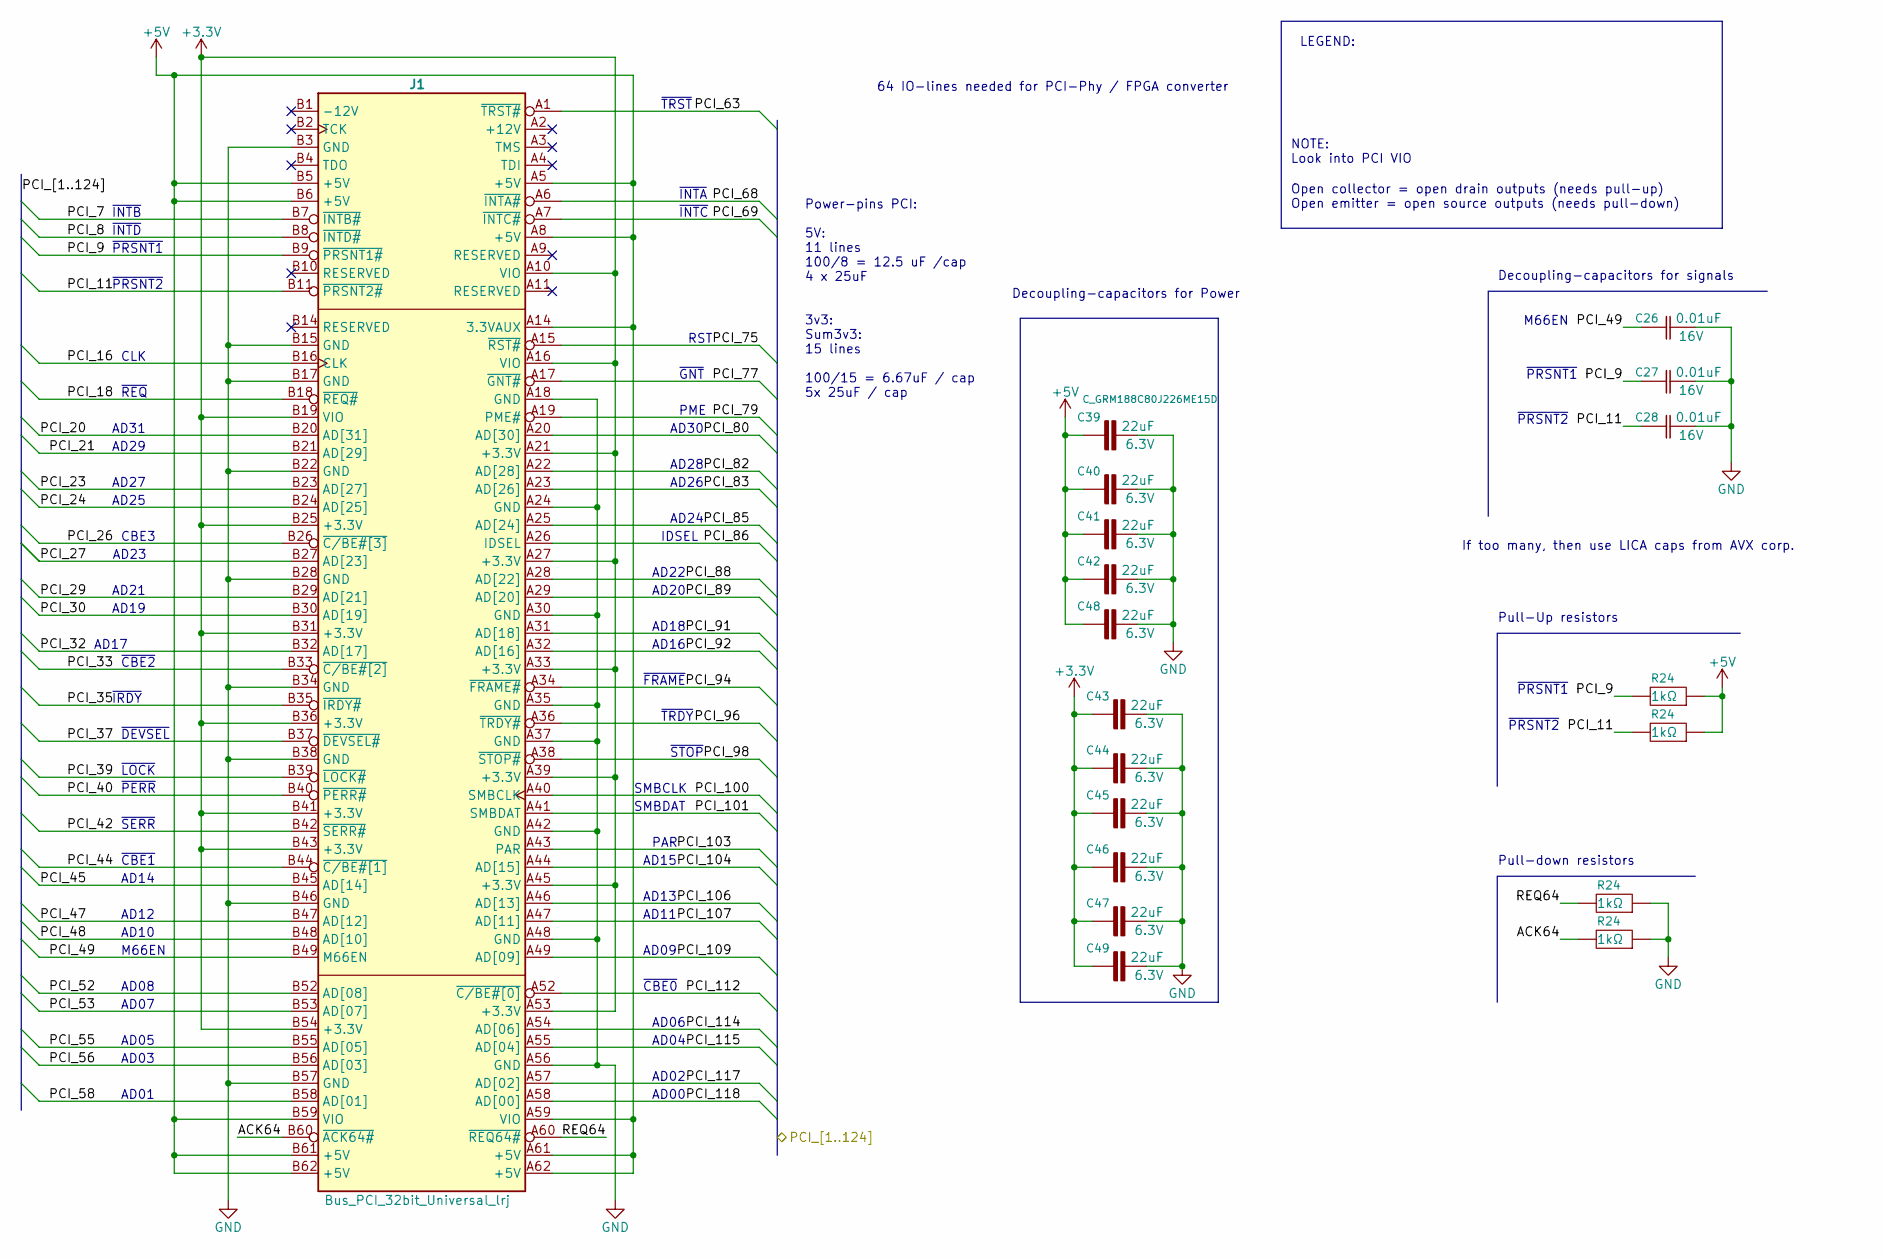
[picture p65: schematic pci-bus_osvga.kicad_sch]

Parts:
C26, C27, C28: C_0306YC103KAT2A; C_AVX_0306_0816Metric; Voltage rating 16V; Tolerance ±10%; MPN 0306YC103KAT2A
C39, C40, C41, C42, C43, C44, C45, C46, C47, C48, C49: C_GRM188C80J226ME15D; C_0603_1608Metric; Voltage rating 6.3V; MPN GRM188C80J226ME15D
J1: Bus_PCI_32bit_Universal_lrj; BUS_PCI_UNI_32-lrj2
R24: R_ERJ-P06F1001V; R_0805_2012Metric_Pad1.20x1.40mm_HandSolder; Voltage rating 22V; MPN ERJ-P06F1001V

Connections:
+3.3V: C43.1, C44.1, C45.1, C46.1, C47.1, C49.1, J1.A10 (VIO), J1.A16 (VIO), J1.A21 (+3.3V), J1.A27 (+3.3V), J1.A33 (+3.3V), J1.A39 (+3.3V), J1.A45 (+3.3V), J1.A53 (+3.3V), J1.B19 (VIO), J1.B25 (+3.3V), J1.B31 (+3.3V), J1.B36 (+3.3V), J1.B41 (+3.3V), J1.B43 (+3.3V), J1.B54 (+3.3V)
+5V: C39.1, C40.1, C41.1, C42.1, C48.1, J1.A5 (+5V), J1.A8 (+5V), J1.A14 (3.3VAUX), J1.A59 (VIO), J1.A61 (+5V), J1.A62 (+5V), J1.B5 (+5V), J1.B6 (+5V), J1.B59 (VIO), J1.B61 (+5V), J1.B62 (+5V), R24.1
ACK64: J1.B60 (~ACK64#), R24.2
GND: C26.2, C27.2, C28.2, C39.2, C40.2, C41.2, C42.2, C43.2, C44.2, C45.2, C46.2, C47.2, C48.2, C49.2, J1.A18 (GND), J1.A24 (GND), J1.A30 (GND), J1.A35 (GND), J1.A37 (GND), J1.A42 (GND), J1.A48 (GND), J1.A56 (GND), J1.B3 (GND), J1.B15 (GND), J1.B17 (GND), J1.B22 (GND), J1.B28 (GND), J1.B34 (GND), J1.B38 (GND), J1.B46 (GND), J1.B57 (GND), R24.1
PCI_7: J1.B7 (~INTB#)
PCI_8: J1.B8 (~INTD#)
PCI_9: C27.1, J1.B9 (~PRSNT1#), R24.2
PCI_11: C28.1, J1.B11 (~PRSNT2#), R24.2
PCI_16: J1.B16 (CLK)
PCI_18: J1.B18 (~REQ#)
PCI_20: J1.B20 (AD[31])
PCI_21: J1.B21 (AD[29])
PCI_23: J1.B23 (AD[27])
PCI_24: J1.B24 (AD[25])
PCI_26: J1.B26 (~C/BE#[3])
PCI_27: J1.B27 (AD[23])
PCI_29: J1.B29 (AD[21])
PCI_30: J1.B30 (AD[19])
PCI_32: J1.B32 (AD[17])
PCI_33: J1.B33 (~C/BE#[2])
PCI_35: J1.B35 (~IRDY#)
PCI_37: J1.B37 (~DEVSEL#)
PCI_39: J1.B39 (~LOCK#)
PCI_40: J1.B40 (~PERR#)
PCI_42: J1.B42 (~SERR#)
PCI_44: J1.B44 (~C/BE#[1])
PCI_45: J1.B45 (AD[14])
PCI_47: J1.B47 (AD[12])
PCI_48: J1.B48 (AD[10])
PCI_49: C26.1, J1.B49 (M66EN)
PCI_52: J1.B52 (AD[08])
PCI_53: J1.B53 (AD[07])
PCI_55: J1.B55 (AD[05])
PCI_56: J1.B56 (AD[03])
PCI_58: J1.B58 (AD[01])
PCI_63: J1.A1 (~TRST#)
PCI_68: J1.A6 (~INTA#)
PCI_69: J1.A7 (~INTC#)
PCI_75: J1.A15 (~RST#)
PCI_77: J1.A17 (~GNT#)
PCI_79: J1.A19 (PME#)
PCI_80: J1.A20 (AD[30])
PCI_82: J1.A22 (AD[28])
PCI_83: J1.A23 (AD[26])
PCI_85: J1.A25 (AD[24])
PCI_86: J1.A26 (IDSEL)
PCI_88: J1.A28 (AD[22])
PCI_89: J1.A29 (AD[20])
PCI_91: J1.A31 (AD[18])
PCI_92: J1.A32 (AD[16])
PCI_94: J1.A34 (~FRAME#)
PCI_96: J1.A36 (~TRDY#)
PCI_98: J1.A38 (~STOP#)
PCI_100: J1.A40 (SMBCLK)
PCI_101: J1.A41 (SMBDAT)
PCI_103: J1.A43 (PAR)
PCI_104: J1.A44 (AD[15])
PCI_106: J1.A46 (AD[13])
PCI_107: J1.A47 (AD[11])
PCI_109: J1.A49 (AD[09])
PCI_112: J1.A52 (~C/BE#[0])
PCI_114: J1.A54 (AD[06])
PCI_115: J1.A55 (AD[04])
PCI_117: J1.A57 (AD[02])
PCI_118: J1.A58 (AD[00])
REQ64: J1.A60 (~REQ64#), R24.2

Notes on the sheet:
~{PERR}
~{CBE1}
~{INTA}
AD00
AD04
~{PRSNT2}
~{CBE0}
~{PRSNT1}
LEGEND:
~{LOCK}
AD10
AD02
M66EN
~{IRDY}
PAR
AD09
If too many, then use LICA caps from AVX corp.
AD18
AD14
~{SERR}
AD30
AD13
AD16
AD24
Open collector = open drain outputs (needs pull-up) Open emitter = open source outputs (needs pull-down)
IDSEL
AD31
AD29
AD03
~{INTC}
CBE3
Pull-Up resistors
64 IO-lines needed for PCI-Phy / FPGA converter
AD01
~{STOP}
PME
AD28
AD22
AD27
~{TRST}
AD07
AD21
~{TRDY}
SMBCLK
NOTE: Look into PCI VIO
AD11
~{CBE2}
AD17
AD23
AD06
AD05
Power-pins PCI: 5V: 11 lines 100/8 = 12.5 uF /cap 4 x 25uF 3v3: Sum3v3: 15 lines 100/15 = 6.67uF / cap 5x 25uF / cap
Pull-down resistors
AD08
RST
~{INTB}
~{REQ}
~{INTD}
AD20
~{DEVSEL}
SMBDAT
~{GNT}
AD26
Decoupling-capacitors for signals
CLK
AD12
AD19
AD15
AD25
~{FRAME}
Decoupling-capacitors for Power
