Doomn00b/Open-SVGA/Hardware/svga-devboard/power_osvga.kicad_sch

## KiCad design Hardware/svga-devboard/power_osvga.kicad_sch (2023-07-21, an earlier design)

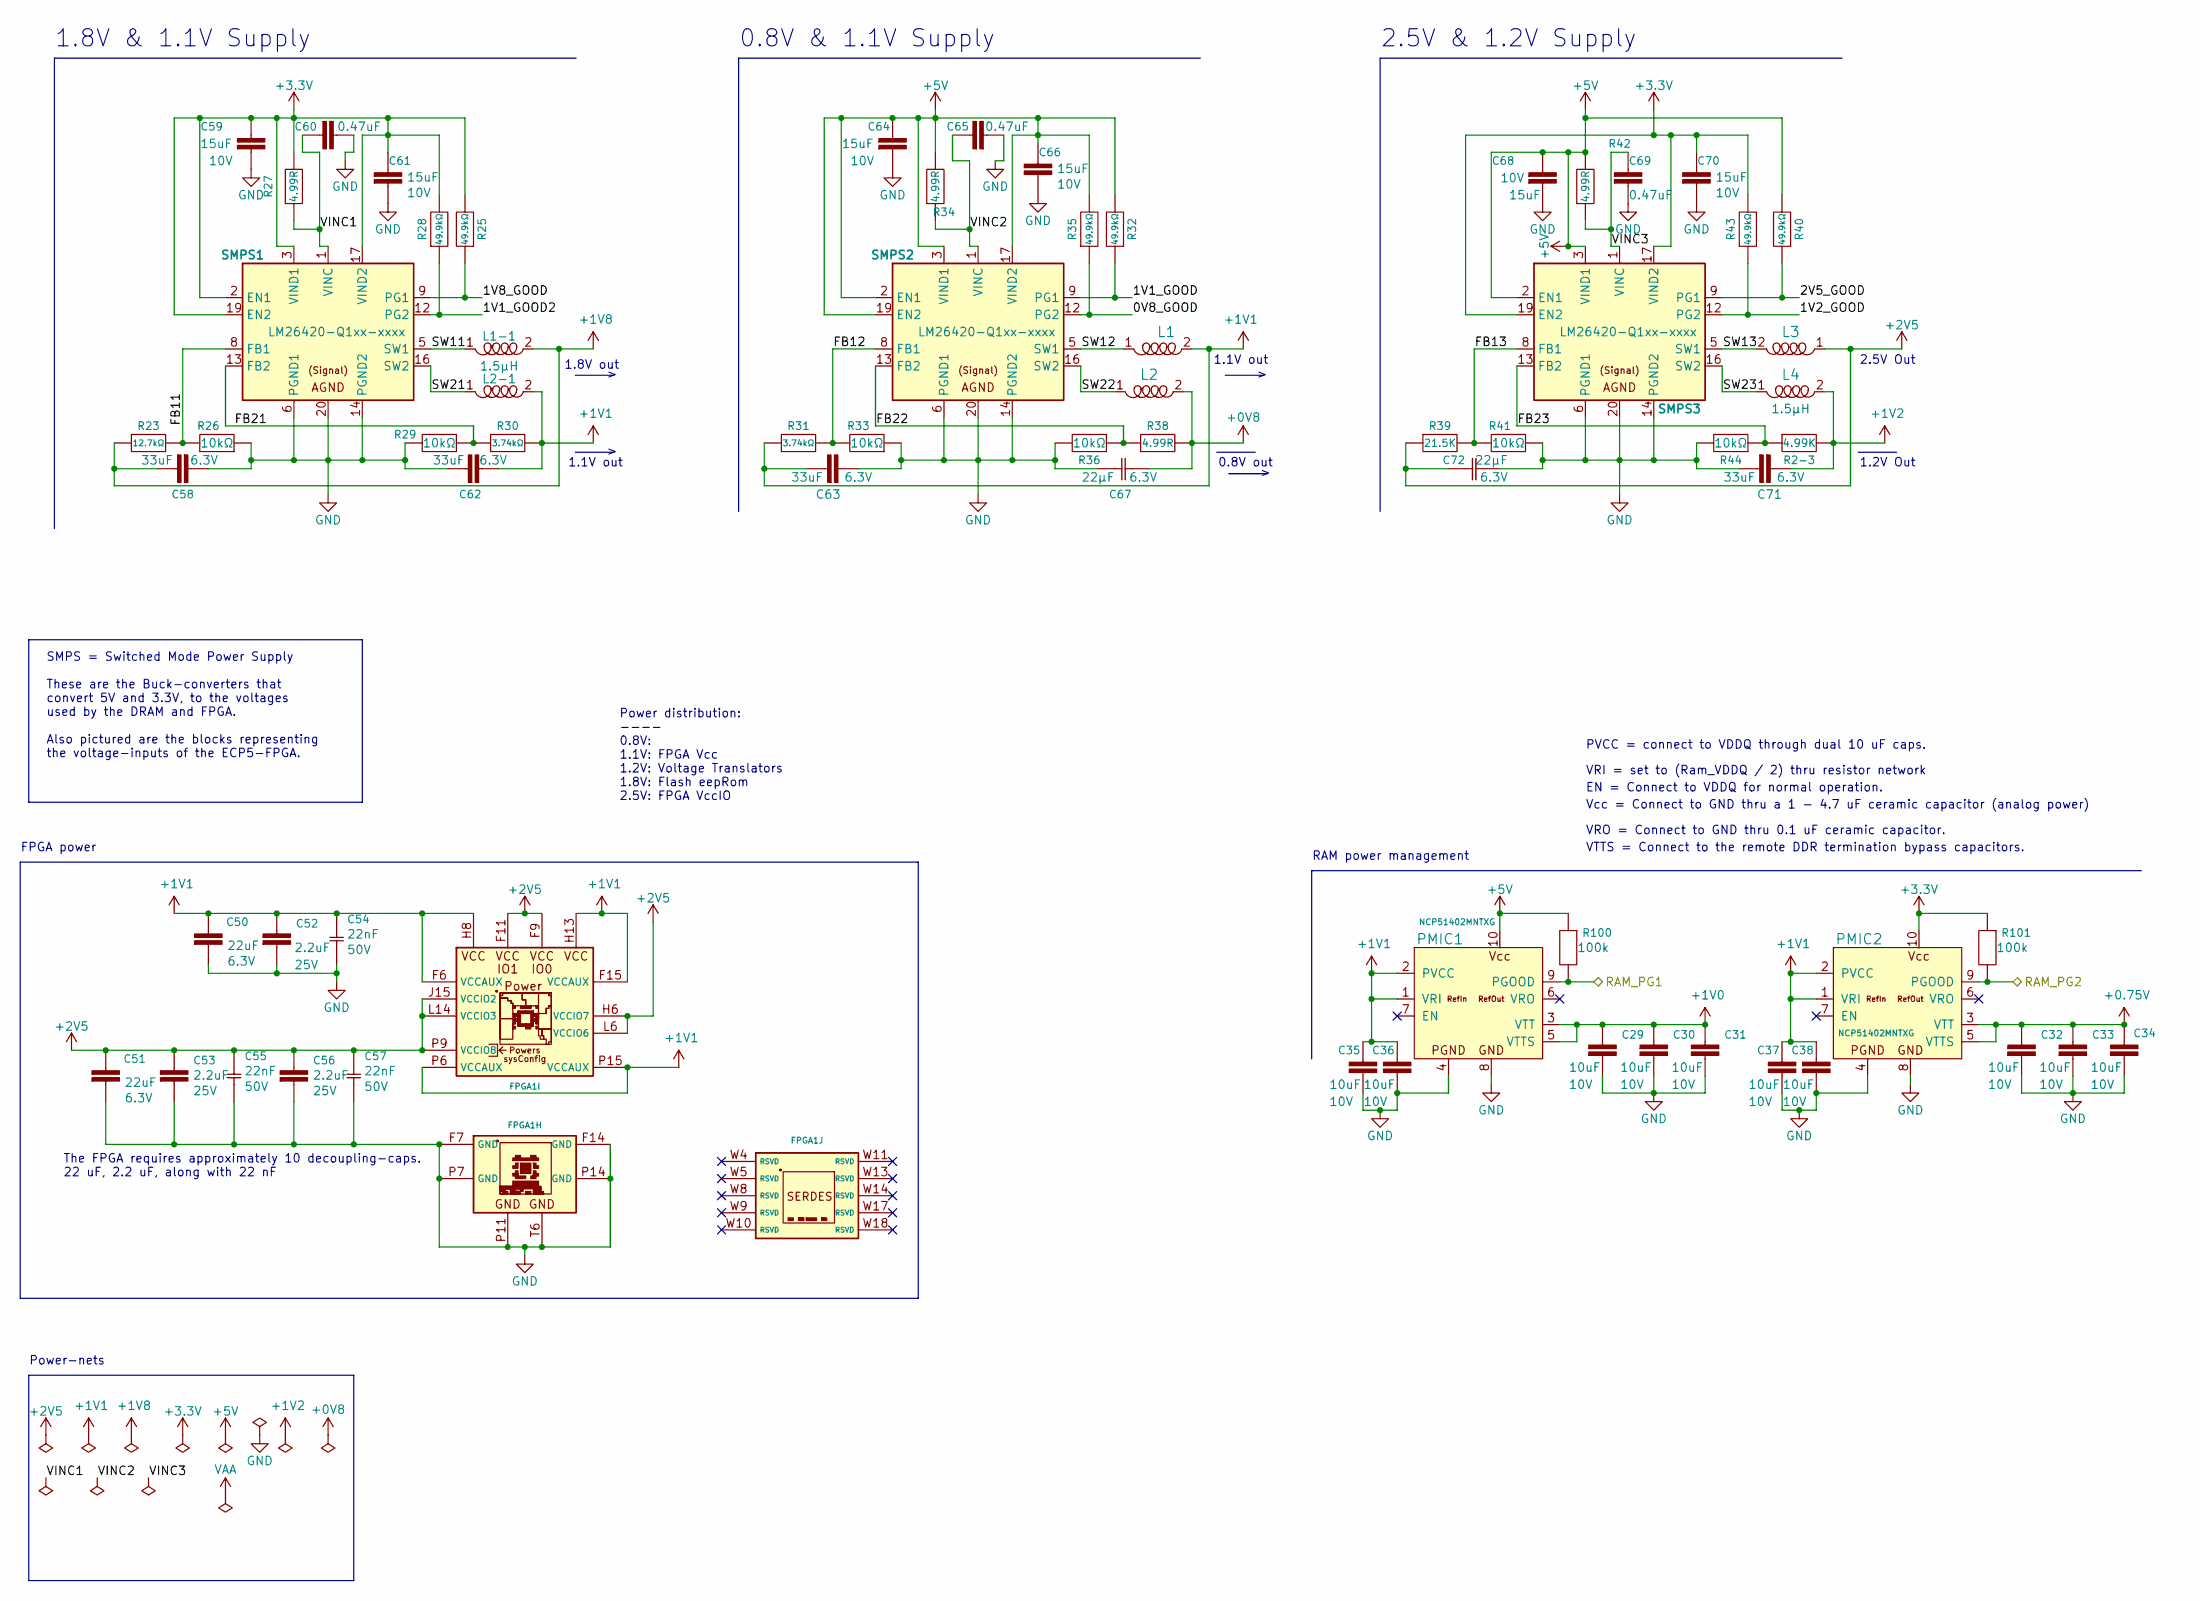
[picture p66: schematic power_osvga.kicad_sch]

Parts:
C29, C30, C31, C32, C33, C34, C35, C36, C37, C38: C_GRM21BR71A106KA73K; C_0805_2012Metric_Pad1.18x1.45mm_HandSolder; Voltage rating 10V; Tolerance ±10%; MPN GRM21BR71A106KA73K
C50, C51: C_GRM188C80J226ME15D; C_0603_1608Metric; Voltage rating 6.3V; MPN GRM188C80J226ME15D
C52, C53, C56: C_CL21B225KAFNFNE; C_0805_2012Metric_Pad1.18x1.45mm_HandSolder; Voltage rating 25V; Tolerance ±10%; MPN CL21B225KAFNFNE
C54, C55, C57: C_CL21B223KBANFNC; C_0805_2012Metric_Pad1.18x1.45mm_HandSolder; Voltage rating 50V; Tolerance ±10%; MPN CL21B223KBANFNC
C58, C62, C63, C71: C_C3216X7S0J336M160AC; C_1206_3216Metric; Voltage Rating 6.3V; MPN C3216X7S0J336M160AC
C59, C61, C64, C66, C68, C70: C_C2012X7S1A156M125AC; C_0805_2012Metric_Pad1.18x1.45mm_HandSolder; Voltage rating 10V; Tolerance ±20%; MPN C2012X7S1A156M125AC
C60, C65, C69: C_CL21B474KOFNNNG; C_0805_2012Metric_Pad1.18x1.45mm_HandSolder; Voltage rating 16V; Tolerance ±10%; MPN CL21B474KOFNNNG
C67, C72: C_CL21A226MQQNNNE; C_0805_2012Metric; Voltage rating 6.3V; MPN CL21A226MQQNNNE
FPGA1: LFE5U-85F-8BG381; Lattice_caBGA-381_17.0x17.0_Layout18x18_P0.8_Ball0.4_Pad0.4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; Voltage rating 3.63V; MPN LFE5U-85F-8BG381
L1, L2, L2-1: XFL4015-701MEC; L_Coilcraft_XFL4015; MPN XFL4015-701MEC; Mouser No: 994-XFL4015-701MEC
L1-1, L4: VLS3015CX-1R5M-1; L_TDK_VLS3015CX-1_handsoldering; MPN VLS3015CX-1R5M-1; Mouser No: 810-VLS3015CX1R5M1
L3: 1008PS-152KLC; L_1008_2520Metric; MPN 1008PS-152KLC; Mouser No: 994-1008PS-152KLC
PMIC1, PMIC2: NCP51402MNTXG; On_Semi_DFN-10-1EP_3x3mm_P0.5mm_EP1.7x2.7mm; Voltage - Input 2.375V to 5.5V; Voltage - Output 0.5V to 1.8V; MPN NCP51402; Digi-Key_PN NCP51402MNTXGOSCT-ND
R2-3: R_CRCW08054K99FKEAHP; R_0805_2012Metric_Pad1.20x1.40mm_HandSolder; MPN CRCW08054K99FKEAHP
R23: R_ERJ-P06F1272V; R_0805_2012Metric_Pad1.20x1.40mm_HandSolder; Voltage rating 79V; MPN ERJ-P06F1272V
R25, R28, R32, R35, R40, R43: R_CRCW080549K9FKEAHP; R_0805_2012Metric_Pad1.20x1.40mm_HandSolder; Voltage rating 150V; MPN CRCW080549K9FKEAHP
R26, R29, R33, R36, R41, R44: R_ERJ-P06F1002V; R_0805_2012Metric_Pad1.20x1.40mm_HandSolder; Voltage rating 70V; MPN ERJ-P06F1002V
R27, R34, R38, R42: R_WK73S2ATTD4R99F; R_0508_1220Metric_reverse; Tolerance ±1%; Power rating 1W; MPN WK73S2ATTD4R99F
R30, R31: R_CRCW08053K74FKEAHP; R_0805_2012Metric_Pad1.20x1.40mm_HandSolder; Voltage rating 150V; MPN CRCW08053K74FKEAHP
R39: R_RK73H2ATTD2152F; R_0805_2012Metric_Pad1.20x1.40mm_HandSolder
R100, R101: R_RC0805JR-07100KL; R_0805_2012Metric; Voltage Rating 150V; MPN RC0805JR-07100KL
SMPS1, SMPS2, SMPS3: LM26420-Q1xx-xxxx; HTSSOP-20-1EP_4.4x6.5mm_P0.42mm_EP3.2x6.4mm_Mask3.0x4.2mm_T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; Voltage rating 5.5V; Current rating 2A

Connections:
0V8_GOOD: R35.1, SMPS2.12 (PG2)
1V1_GOOD: R32.1, SMPS2.9 (PG1)
1V1_GOOD2: R28.1, SMPS1.12 (PG2)
1V2_GOOD: R43.1, SMPS3.12 (PG2)
1V8_GOOD: R25.1, SMPS1.9 (PG1)
2V5_GOOD: R40.1, SMPS3.9 (PG1)
+0.75V: C32.1, C33.1, C34.1, PMIC2.3 (VTT), PMIC2.5 (VTTS)
+0V8: C67.2, L2.2, R38.2
+1V0: C29.1, C30.1, C31.1, PMIC1.3 (VTT), PMIC1.5 (VTTS)
+1V1: C35.1, C36.1, C37.1, C38.1, C50.1, C52.1, C54.1, C62.2, C63.1, FPGA1.F6 (VCCAUX), FPGA1.F15 (VCCAUX), FPGA1.H8 (VCC), FPGA1.H9 (VCC), FPGA1.H10 (VCC), FPGA1.H11 (VCC), FPGA1.H12 (VCC), FPGA1.H13 (VCC), FPGA1.J8 (VCC), FPGA1.J13 (VCC), FPGA1.K8 (VCC), FPGA1.K13 (VCC), FPGA1.L8 (VCC), FPGA1.L13 (VCC), FPGA1.M8 (VCC), FPGA1.M13 (VCC), FPGA1.N8 (VCC), FPGA1.N9 (VCC), FPGA1.N10 (VCC), FPGA1.N11 (VCC), FPGA1.N12 (VCC), FPGA1.N13 (VCC), FPGA1.P6 (VCCAUX), FPGA1.P15 (VCCAUX), L1.2, L2-1.2, PMIC1.1 (VRI), PMIC1.2 (PVCC), PMIC2.1 (VRI), PMIC2.2 (PVCC), R30.2, R31.1
+1V2: C71.1, L4.2, R2-3.2
+1V8: C58.2, L1-1.2, R23.1
+2V5: C51.1, C53.1, C55.1, C56.1, C57.1, C72.1, FPGA1.F9 (VCCIO0), FPGA1.F10 (VCCIO0), FPGA1.F11 (VCCIO1), FPGA1.F12 (VCCIO1), FPGA1.H6 (VCCIO7), FPGA1.H7 (VCCIO7), FPGA1.H14 (VCCIO2), FPGA1.H15 (VCCIO2), FPGA1.J6 (VCCIO7), FPGA1.J15 (VCCIO2), FPGA1.L6 (VCCIO6), FPGA1.L7 (VCCIO6), FPGA1.L14 (VCCIO3), FPGA1.L15 (VCCIO3), FPGA1.M6 (VCCIO6), FPGA1.M15 (VCCIO3), FPGA1.P9 (VCCIO8), FPGA1.P10 (VCCIO8), L3.1, R39.1
+3.3V: C59.1, C61.1, C70.1, PMIC2.10 (Vcc), R25.2, R27.2, R28.2, R43.2, R101.1, SMPS1.2 (EN1), SMPS1.3 (VIND1), SMPS1.4 (VIND1), SMPS1.17 (VIND2), SMPS1.18 (VIND2), SMPS1.19 (EN2), SMPS3.17 (VIND2), SMPS3.18 (VIND2), SMPS3.19 (EN2)
+5V: C64.1, C66.1, C68.1, PMIC1.10 (Vcc), R32.2, R34.2, R35.2, R40.2, R42.2, R100.1, SMPS2.2 (EN1), SMPS2.3 (VIND1), SMPS2.4 (VIND1), SMPS2.17 (VIND2), SMPS2.18 (VIND2), SMPS2.19 (EN2), SMPS3.2 (EN1), SMPS3.3 (VIND1), SMPS3.4 (VIND1)
FB11: R23.2, R26.2, SMPS1.8 (FB1)
FB12: R31.2, R33.2, SMPS2.8 (FB1)
FB13: R39.2, R41.2, SMPS3.8 (FB1)
FB21: R29.1, R30.1, SMPS1.13 (FB2)
FB22: R36.1, R38.1, SMPS2.13 (FB2)
FB23: R2-3.1, R44.1, SMPS3.13 (FB2)
GND: C29.2, C30.2, C31.2, C32.2, C33.2, C34.2, C35.2, C36.2, C37.2, C38.2, C50.2, C51.2, C52.2, C53.2, C54.2, C55.2, C56.2, C57.2, C58.1, C59.2, C60.1, C61.2, C62.1, C63.2, C64.2, C65.2, C66.2, C67.1, C68.2, C69.2, C70.2, C71.2, C72.2, FPGA1.B7 (GND), FPGA1.B14 (GND), FPGA1.C19 (GND), FPGA1.D4 (GND), FPGA1.F7 (GND), FPGA1.F8 (GND), FPGA1.F13 (GND), FPGA1.F14 (GND), FPGA1.G4 (GND), FPGA1.G6 (GND), FPGA1.G7 (GND), FPGA1.G8 (GND), FPGA1.G9 (GND), FPGA1.G10 (GND), FPGA1.G11 (GND), FPGA1.G12 (GND), FPGA1.G13 (GND), FPGA1.G14 (GND), FPGA1.G15 (GND), FPGA1.G17 (GND), FPGA1.H19 (GND), FPGA1.J2 (GND), FPGA1.J7 (GND), FPGA1.J9 (GND), FPGA1.J10 (GND), FPGA1.J11 (GND), FPGA1.J12 (GND), FPGA1.J14 (GND), FPGA1.K6 (GND), FPGA1.K7 (GND), FPGA1.K9 (GND), FPGA1.K10 (GND), FPGA1.K11 (GND), FPGA1.K12 (GND), FPGA1.K14 (GND), FPGA1.K15 (GND), FPGA1.L9 (GND), FPGA1.L10 (GND), FPGA1.L11 (GND), FPGA1.L12 (GND), FPGA1.M2 (GND), FPGA1.M7 (GND), FPGA1.M9 (GND), FPGA1.M10 (GND), FPGA1.M11 (GND), FPGA1.M12 (GND), FPGA1.M14 (GND), FPGA1.M16 (GND), FPGA1.N6 (GND), FPGA1.N7 (GND), FPGA1.N14 (GND), FPGA1.N15 (GND), FPGA1.P7 (GND), FPGA1.P8 (GND), FPGA1.P11 (GND), FPGA1.P12 (GND), FPGA1.P13 (GND), FPGA1.P14 (GND), FPGA1.R19 (GND), FPGA1.T6 (GND), FPGA1.T7 (GND), FPGA1.T8 (GND), FPGA1.T9 (GND), FPGA1.T10 (GND), FPGA1.T11 (GND), FPGA1.T12 (GND), FPGA1.T13 (GND), FPGA1.T14 (GND), FPGA1.T15 (GND), FPGA1.U6 (GND), FPGA1.U7 (GND), FPGA1.U8 (GND), FPGA1.U9 (GND), FPGA1.U10 (GND), FPGA1.U11 (GND), FPGA1.U12 (GND), FPGA1.U13 (GND), FPGA1.U14 (GND), FPGA1.U15 (GND), FPGA1.V5 (GND), FPGA1.V6 (GND), FPGA1.V7 (GND), FPGA1.V8 (GND), FPGA1.V9 (GND), FPGA1.V10 (GND), FPGA1.V11 (GND), FPGA1.V12 (GND), FPGA1.V13 (GND), FPGA1.V14 (GND), FPGA1.V15 (GND), FPGA1.V16 (GND), FPGA1.V17 (GND), FPGA1.V18 (GND), FPGA1.V19 (GND), FPGA1.V20 (GND), FPGA1.W6 (GND), FPGA1.W7 (GND), FPGA1.W12 (GND), FPGA1.W15 (GND), FPGA1.W16 (GND), FPGA1.W19 (GND), FPGA1.W20 (GND), FPGA1.Y5 (GND), FPGA1.Y6 (GND), FPGA1.Y7 (GND), FPGA1.Y8 (GND), FPGA1.Y11 (GND), FPGA1.Y12 (GND), FPGA1.Y14 (GND), FPGA1.Y15 (GND), FPGA1.Y16 (GND), FPGA1.Y17 (GND), FPGA1.Y19 (GND), PMIC1.4 (PGND), PMIC1.8 (GND), PMIC1.11 (DAP), PMIC2.4 (PGND), PMIC2.8 (GND), PMIC2.11 (DAP), R26.1, R29.2, R33.1, R36.2, R41.1, R44.2, SMPS1.6 (PGND1), SMPS1.7 (PGND1), SMPS1.10 (DAP), SMPS1.11 (DAP), SMPS1.14 (PGND2), SMPS1.15 (PGND2), SMPS1.20 (AGND), SMPS1.21 (DAP), SMPS2.6 (PGND1), SMPS2.7 (PGND1), SMPS2.10 (DAP), SMPS2.11 (DAP), SMPS2.14 (PGND2), SMPS2.15 (PGND2), SMPS2.20 (AGND), SMPS2.21 (DAP), SMPS3.6 (PGND1), SMPS3.7 (PGND1), SMPS3.10 (DAP), SMPS3.11 (DAP), SMPS3.14 (PGND2), SMPS3.15 (PGND2), SMPS3.20 (AGND), SMPS3.21 (DAP)
RAM_PG1: PMIC1.9 (PGOOD), R100.2
RAM_PG2: PMIC2.9 (PGOOD), R101.2
SW11: L1-1.1, SMPS1.5 (SW1)
SW12: L1.1, SMPS2.5 (SW1)
SW13: L3.2, SMPS3.5 (SW1)
SW21: L2-1.1, SMPS1.16 (SW2)
SW22: L2.1, SMPS2.16 (SW2)
SW23: L4.1, SMPS3.16 (SW2)
VINC1: C60.2, R27.1, SMPS1.1 (VINC)
VINC2: C65.1, R34.1, SMPS2.1 (VINC)
VINC3: C69.1, R42.1, SMPS3.1 (VINC)

Notes on the sheet:
1.1V out
1.2V Out
1.8V out
0.8V out
VRO = Connect to GND thru 0.1 uF ceramic capacitor.
VTTS = Connect to the remote DDR termination bypass capacitors.
2.5V Out
VRI = set to (Ram_VDDQ / 2) thru resistor network
The FPGA requires approximately 10 decoupling-caps. 22 uF, 2.2 uF, along with 22 nF
EN = Connect to VDDQ for normal operation.
SMPS = Switched Mode Power Supply These are the Buck-converters that convert 5V and 3.3V, to the voltages used by the DRAM and FPGA. Also pictured are the blocks representing the voltage-inputs of the ECP5-FPGA.
Power distribution: ---- 0.8V: 1.1V: FPGA Vcc 1.2V: Voltage Translators 1.8V: Flash eepRom 2.5V: FPGA VccIO
1.8V & 1.1V Supply
2.5V & 1.2V Supply
0.8V & 1.1V Supply
Power-nets
PVCC = connect to VDDQ through dual 10 uF caps.
RAM power management
Vcc = Connect to GND thru a 1 − 4.7 uF ceramic capacitor (analog power)
FPGA power
