Doomn00b/Open-SVGA/Hardware/svga-devboard/svga-devboard.kicad_sch

## KiCad design Hardware/svga-devboard/svga-devboard.kicad_sch (2023-07-21, an earlier design)

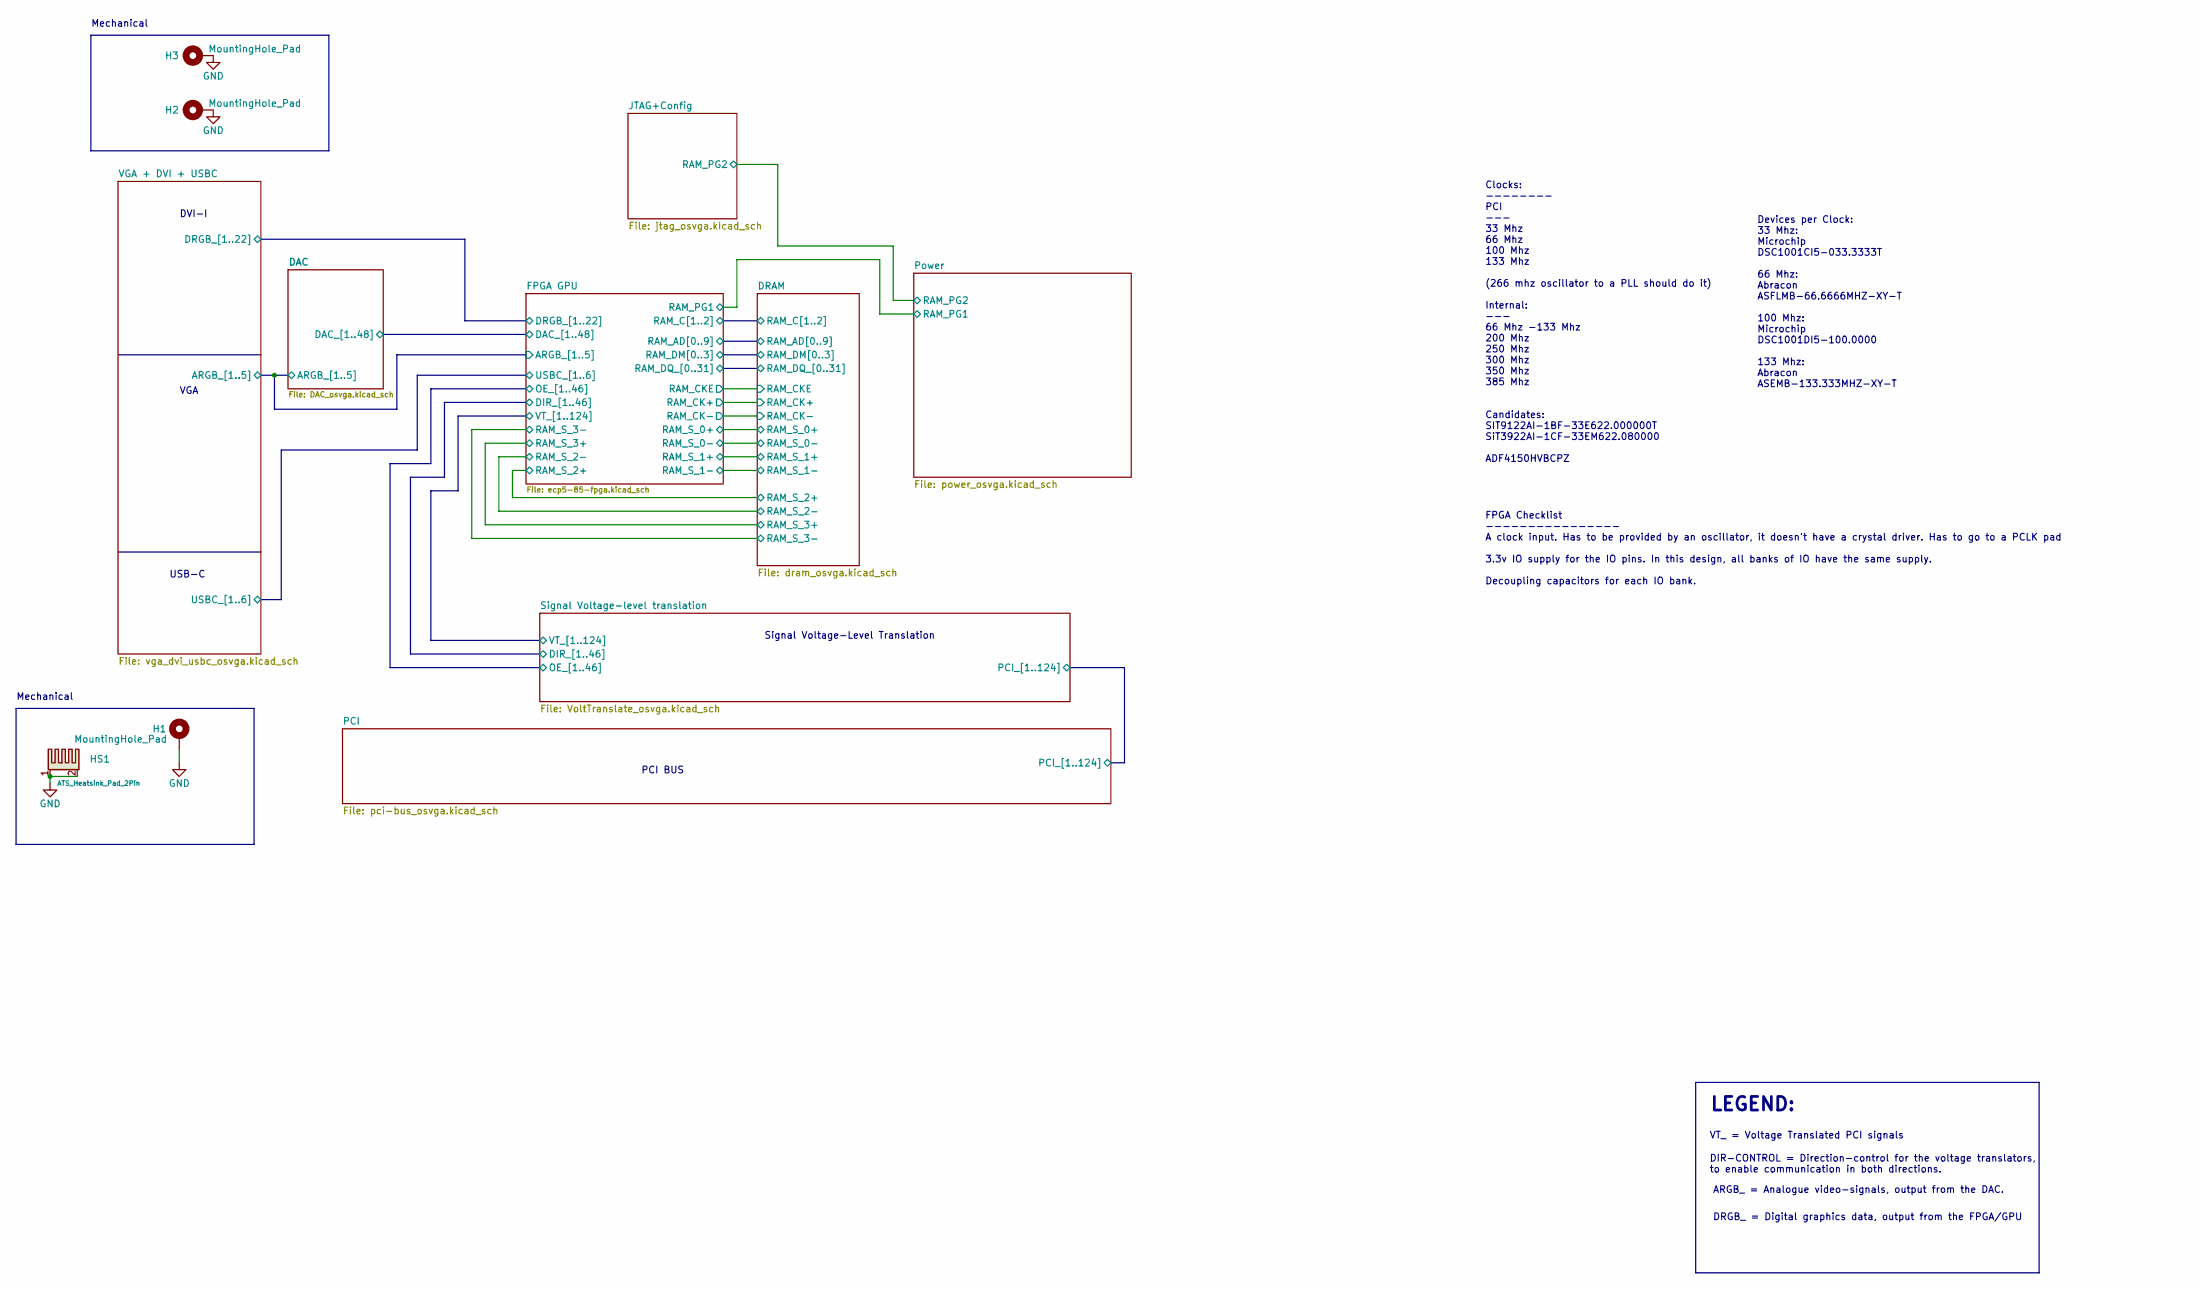
[picture p67: schematic svga-devboard.kicad_sch]

Parts:
H1, H2, H3: MountingHole_Pad; MountingHole_3.2mm_M3_Pad_Via
HS1: ATS_Heatsink_Pad_2Pin; Heatsink_ATS_25x25mm_2xFixation3.175mm; MPN ATS-CPX025025025-168-C1-R0

Connections:
GND: H1.1, H2.1, H3.1, HS1.1, HS1.2

Notes on the sheet:
DRGB_ = Digital graphics data, output from the FPGA/GPU
VGA
PCI BUS
Mechanical
VT_ = Voltage Translated PCI signals
DIR-CONTROL = Direction-control for the voltage translators, to enable communication in both directions.
Devices per Clock: 33 Mhz: Microchip DSC1001CI5-033.3333T 66 Mhz: Abracon ASFLMB-66.6666MHZ-XY-T 100 Mhz: Microchip DSC1001DI5-100.0000 133 Mhz: Abracon ASEMB-133.333MHZ-XY-T
Signal Voltage-Level Translation
LEGEND:
DVI-I
USB-C
Clocks: -------- PCI --- 33 Mhz 66 Mhz 100 Mhz 133 Mhz (266 mhz oscillator to a PLL should do it) Internal: --- 66 Mhz -133 Mhz 200 Mhz 250 Mhz 300 Mhz 350 Mhz 385 Mhz Candidates: SIT9122AI-1BF-33E622.000000T SiT3922AI-1CF-33EM622.080000 ADF4150HVBCPZ
FPGA Checklist ---------------- A clock input. Has to be provided by an oscillator, it doesn't have a crystal driver. Has to go to a PCLK pad 3.3v IO supply for the IO pins. In this design, all banks of IO have the same supply. Decoupling capacitors for each IO bank.
ARGB_ = Analogue video-signals, output from the DAC.
