Doomn00b/Open-SVGA/Hardware/svga-devboard/vga_dvi_usbc_osvga.kicad_sch

## KiCad design Hardware/svga-devboard/vga_dvi_usbc_osvga.kicad_sch (2023-07-21, an earlier design)

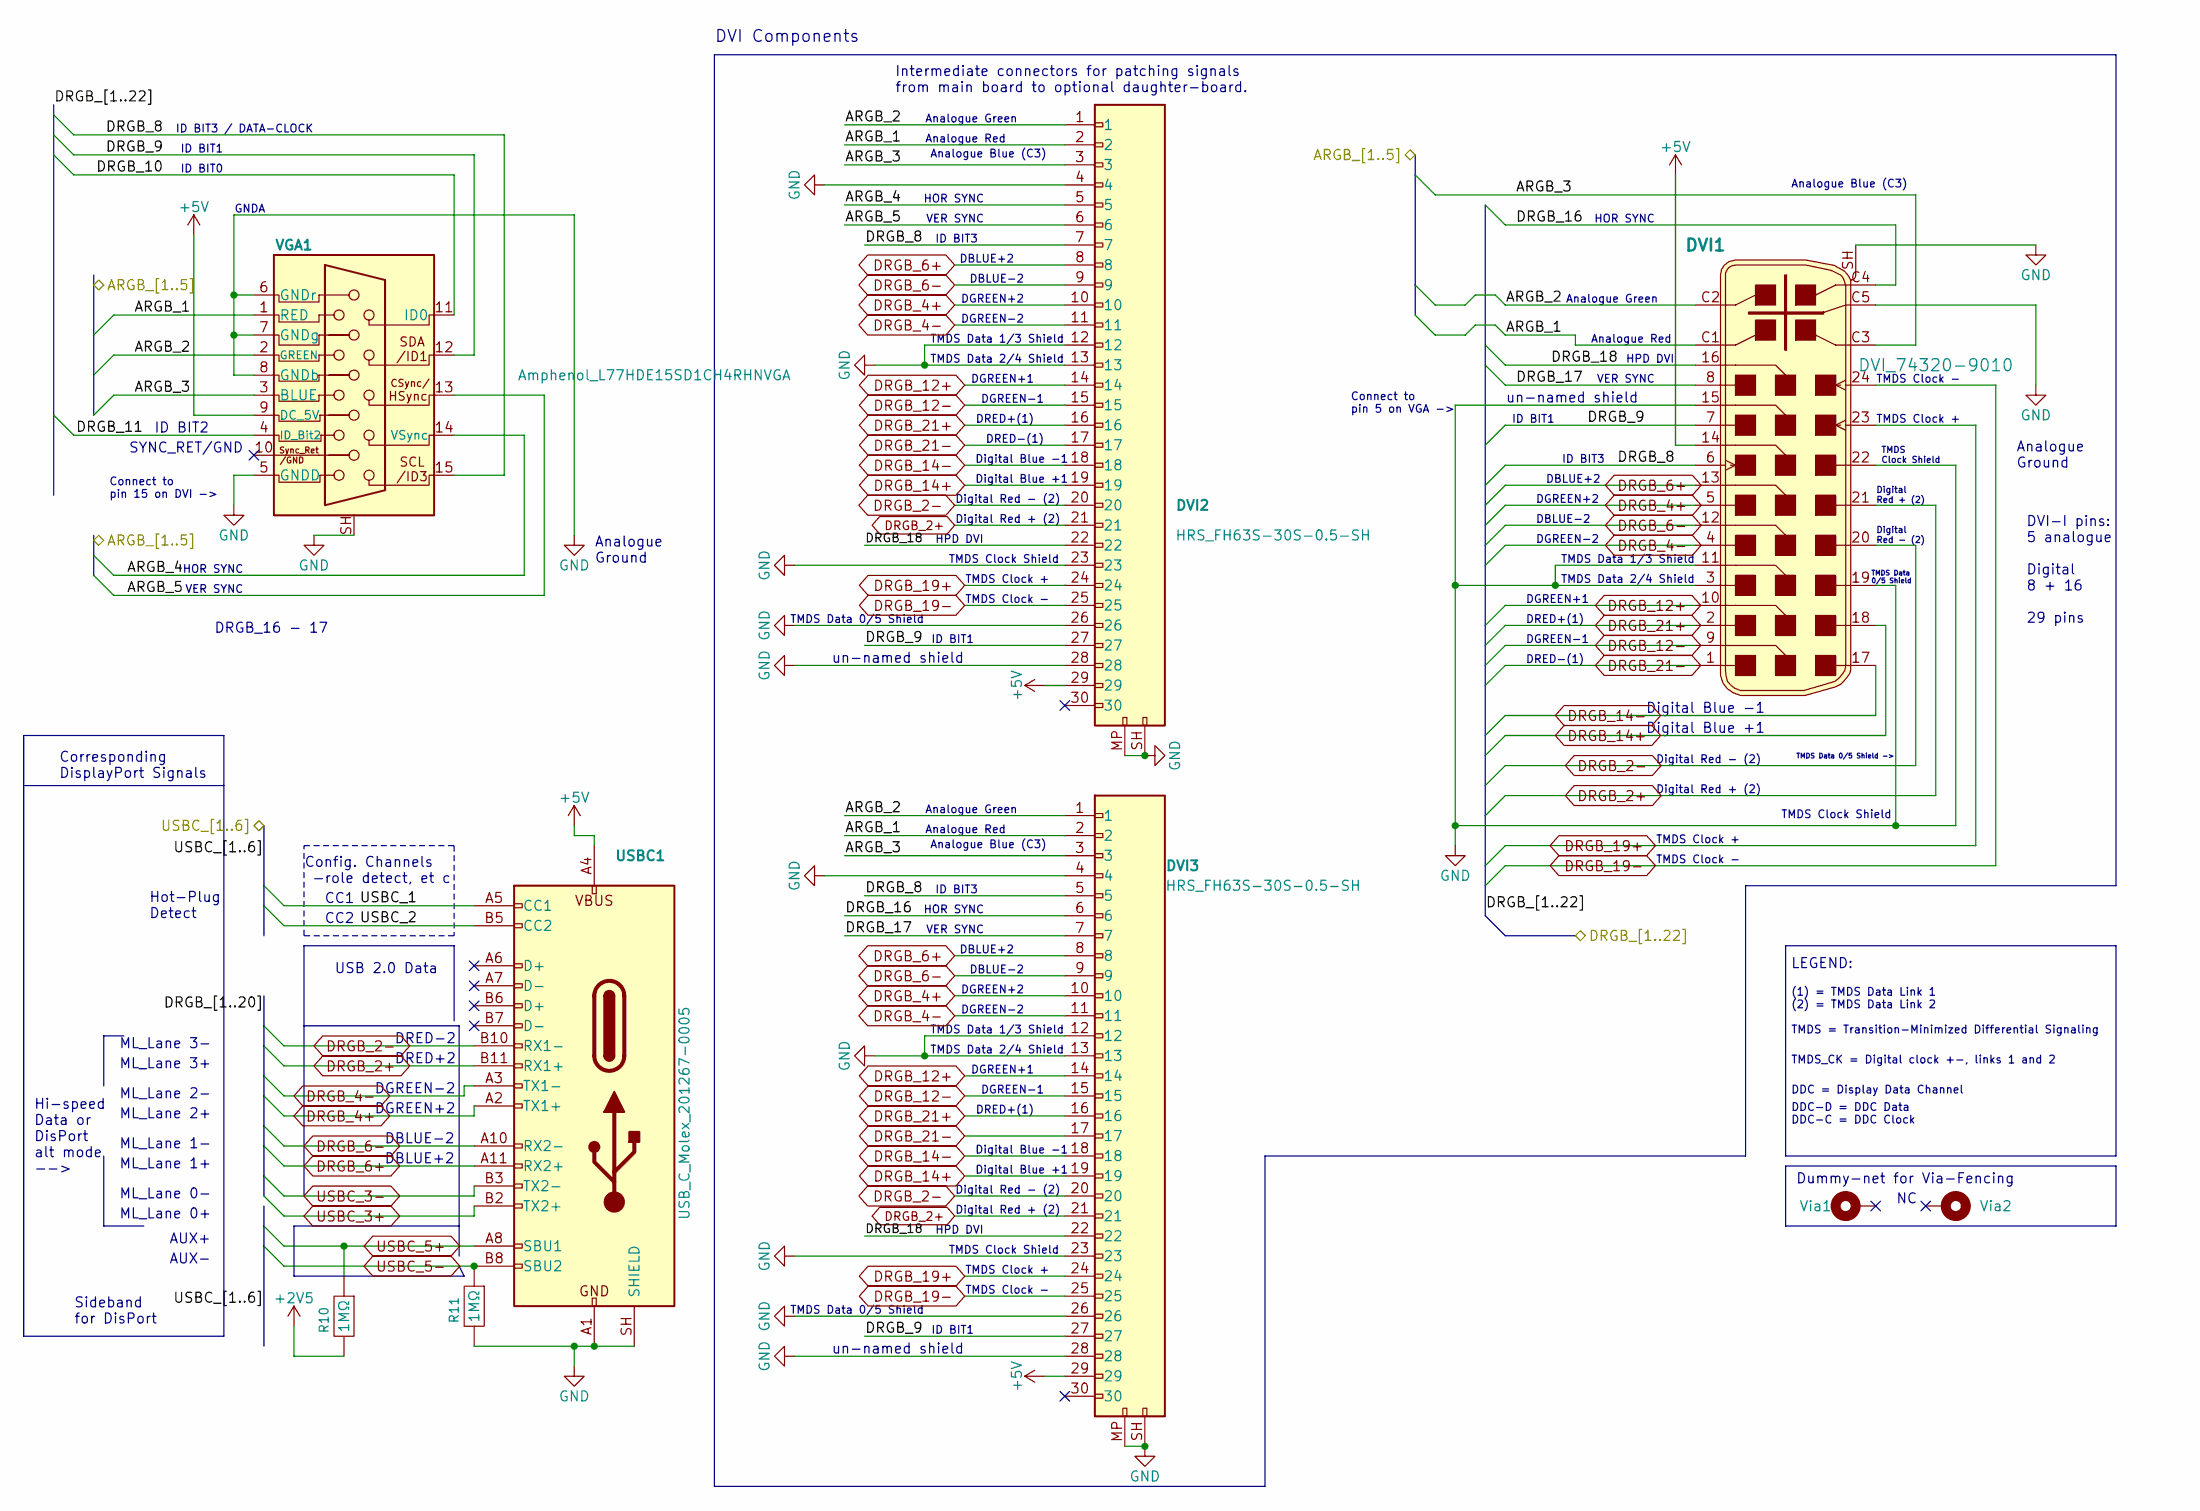
[picture p68: schematic vga_dvi_usbc_osvga.kicad_sch]

Parts:
DVI1: DVI_74320-9010; Molex_DVI_Female_74320-9010; MPN 74320-9010; Digi-Key_PN WM6096-ND
DVI2, DVI3: HRS_FH63S-30S-0.5-SH; Hirose_FH63S-30S-0.5SH_1x30-1MP_P0.50mm_Horizontal; Voltage Rating 50V; Current Rating 0.5A; MPN FH63S-30S-0.5-SH
R10, R11: R_CMP2010-FX-1004ELF; R_2010_5025Metric_Pad1.40x2.65mm_HandSolder; MPN CMP2010-FX-1004ELF
USBC1: USB_C_Molex_201267-0005; USB-C_Receptacle_2012670005; Voltage rating 30V; Current rating 5A; MPN 201267-0005
VGA1: Amphenol_L77HDE15SD1CH4RHNVGA; DSUB-Amphenol_L77HDE15SD1CH4RHNVGA; MPN L77HDE15SD1CH4RHNVGA
Via1, Via2: Dummy_Via_Pad; MountingHole_0.2mm

Connections:
+2V5: R10.2
+5V: DVI1.14, DVI2.29, DVI3.29, USBC1.A4 (VBUS), USBC1.A9 (VBUS), USBC1.B4 (VBUS), USBC1.B9 (VBUS), VGA1.9 (DC_5V)
ARGB_1: DVI1.C1, DVI2.2, DVI3.2, VGA1.1 (RED)
ARGB_2: DVI1.C2, DVI2.1, DVI3.1, VGA1.2 (GREEN)
ARGB_3: DVI1.C3, DVI2.3, DVI3.3, VGA1.3 (BLUE)
ARGB_4: DVI2.5, VGA1.14 (VSync)
ARGB_5: DVI2.6, VGA1.13 (CSync/HSync)
DRGB_2+: DVI1.21, DVI2.21, DVI3.21, USBC1.B11 (RX1+)
DRGB_2-: DVI1.20, DVI2.20, DVI3.20, USBC1.B10 (RX1-)
DRGB_4+: DVI1.5, DVI2.10, DVI3.10, USBC1.A2 (TX1+)
DRGB_4-: DVI1.4, DVI2.11, DVI3.11, USBC1.A3 (TX1-)
DRGB_6+: DVI1.13, DVI2.8, DVI3.8, USBC1.A11 (RX2+)
DRGB_6-: DVI1.12, DVI2.9, DVI3.9, USBC1.A10 (RX2-)
DRGB_8: DVI1.6, DVI2.7, DVI3.5, VGA1.15 (SCL/ID3)
DRGB_9: DVI1.7, DVI2.27, DVI3.27, VGA1.12 (SDA/ID1)
DRGB_10: VGA1.11 (ID0)
DRGB_11: VGA1.4 (ID_Bit2)
DRGB_12+: DVI1.10, DVI2.14, DVI3.14
DRGB_12-: DVI1.9, DVI2.15, DVI3.15
DRGB_14+: DVI1.18, DVI2.19, DVI3.19
DRGB_14-: DVI1.17, DVI2.18, DVI3.18
DRGB_16: DVI1.C4, DVI3.6
DRGB_17: DVI1.8, DVI3.7
DRGB_18: DVI1.16, DVI2.22, DVI3.22
DRGB_19+: DVI1.23, DVI2.24, DVI3.24
DRGB_19-: DVI1.24, DVI2.25, DVI3.25
DRGB_21+: DVI1.2, DVI2.16, DVI3.16
DRGB_21-: DVI1.1, DVI2.17, DVI3.17
GND: DVI1.3, DVI1.11, DVI1.15, DVI1.19, DVI1.22, DVI1.C5, DVI1.SH, DVI2.4, DVI2.12, DVI2.13, DVI2.23, DVI2.26, DVI2.28, DVI2.MP, DVI2.SH, DVI3.4, DVI3.12, DVI3.13, DVI3.23, DVI3.26, DVI3.28, DVI3.MP, DVI3.SH, R11.2, USBC1.A1 (GND), USBC1.A12 (GND), USBC1.B1 (GND), USBC1.B12 (GND), USBC1.SH (SHIELD), VGA1.5 (GNDD), VGA1.6 (GNDr), VGA1.7 (GNDg), VGA1.8 (GNDb), VGA1.SH
USBC_1: USBC1.A5 (CC1)
USBC_2: USBC1.B5 (CC2)
USBC_3+: USBC1.B2 (TX2+)
USBC_3-: USBC1.B3 (TX2-)
USBC_5+: R10.1, USBC1.A8 (SBU1)
USBC_5-: R11.1, USBC1.B8 (SBU2)

Notes on the sheet:
DRED+2
un-named shield
ID BIT2
DGREEN+1
Intermediate connectors for patching signals from main board to optional daughter-board.
VER SYNC
Hot-Plug Detect
TMDS Data 1/3 Shield
DGREEN-1
Hi-speed Data or DisPort alt mode -->
TMDS Clock +
ML_Lane 2-
AUX+
DVI Components
DBLUE+2
Connect to pin 5 on VGA ->
ID BIT3
ML_Lane 1+
TMDS Data 0/5 Shield
Digital Red - (2)
DBLUE-2
ID BIT1
DGREEN+2
TMDS Clock Shield
Digital Red + (2)
TMDS Data 0/5 Shield ->
DRED-(1)
DGREEN-2
HOR SYNC
HPD DVI
TMDS Clock -
ML_Lane 2+
Corresponding DisplayPort Signals
Analogue Blue (C3)
ID BIT0
DRED+(1)
Analogue Green
Analogue Red
Analogue Ground
Digital Red - (2)
Config. Channels -role detect, et c
Sideband for DisPort
ML_Lane 3+
ML_Lane 3-
Dummy-net for Via-Fencing
ML_Lane 1-
SYNC_RET/GND
USB 2.0 Data
(1) = TMDS Data Link 1 (2) = TMDS Data Link 2 TMDS = Transition-Minimized Differential Signaling
DRED-2
Digital Blue +1
DDC-D = DDC Data DDC-C = DDC Clock
Digital Red + (2)
LEGEND:
Connect to pin 15 on DVI ->
TMDS_CK = Digital clock +-, links 1 and 2
DDC = Display Data Channel
CC2
TMDS Data 2/4 Shield
DVI-I pins: 5 analogue Digital 8 + 16 29 pins
CC1
GNDA
Digital Blue -1
AUX-
ML_Lane 0-
TMDS Data 0/5 Shield
TMDS Clock Shield
ML_Lane 0+
ID BIT3 / DATA-CLOCK
DRGB_16 - 17
