Doomn00b/Open-SVGA/Gateware/hdl/altera_ddr3_128/ddr3_int_phy_alt_mem_phy.v

//

`default_nettype none

`ifdef ALT_MEM_PHY_DEFINES
`else
`include "alt_mem_phy_defines.v"
`endif

//
(* altera_attribute = "-name MESSAGE_DISABLE 14130", altera_attribute = "-name SYNCHRONIZER_IDENTIFICATION OFF" *) module ddr3_int_phy_alt_mem_phy (
                        //Clock and reset inputs:
                        pll_ref_clk,
                        global_reset_n,
                        soft_reset_n,

                        // Used to indicate PLL loss of lock for system reset management:
                        reset_request_n,

                        // Clock and reset for the controller interface:
                        ctl_clk,
                        ctl_reset_n,

                        // Write data interface:
                        ctl_dqs_burst,
                        ctl_wdata_valid,
                        ctl_wdata,
                        ctl_dm,
                        ctl_wlat,

                        // Address and command interface:
                        ctl_addr,
                        ctl_ba,
                        ctl_cas_n,
                        ctl_cke,
                        ctl_cs_n,
                        ctl_odt,
                        ctl_ras_n,
                        ctl_we_n,
                        ctl_rst_n,
                        ctl_mem_clk_disable,

                        // Read data interface:
                        ctl_doing_rd,
                        ctl_rdata,
                        ctl_rdata_valid,
                        ctl_rlat,

                        //re-calibration request & configuration:
                        ctl_cal_req,
                        ctl_cal_byte_lane_sel_n,

                        //Calibration status interface:
                        ctl_cal_success,
                        ctl_cal_fail,
                        ctl_cal_warning,

                        //ports to memory device(s):
                        mem_addr,
                        mem_ba,
                        mem_cas_n,
                        mem_cke,
                        mem_cs_n,
                        mem_dm,
                        mem_odt,
                        mem_ras_n,
                        mem_we_n,
                        mem_clk,
                        mem_clk_n,
                        mem_reset_n,

                        // Bidirectional Memory interface signals:
                        mem_dq,
                        mem_dqs,
                        mem_dqs_n,

                        // Auxiliary clocks. Some systems may need these for debugging
                        // purposes, or for full-rate to half-rate bridge interfaces
                        aux_half_rate_clk,
                        aux_full_rate_clk,

                        // On Chip Termination: -  dynamically updated values.
                        oct_ctl_rs_value,
                        oct_ctl_rt_value,

                        // DLL import/export ports
                        dqs_offset_delay_ctrl,
                        dqs_delay_ctrl_import,
                        dqs_delay_ctrl_export,

                        dll_reference_clk,

                        // Debug interface:- ALTERA USE ONLY
                        dbg_clk,
                        dbg_reset_n,
                        dbg_addr,
                        dbg_wr,
                        dbg_rd,
                        dbg_cs,
                        dbg_wr_data,
                        dbg_rd_data,
                        dbg_waitrequest

                      );


// Default parameter values :

parameter FAMILY                          =     "CYCLONEIII";
parameter MEM_IF_MEMTYPE                  =           "DDR2";
parameter SPEED_GRADE                     =             "C6";
parameter DLL_DELAY_BUFFER_MODE           =           "HIGH";
parameter DLL_DELAY_CHAIN_LENGTH          =                8;
parameter DQS_DELAY_CTL_WIDTH             =                6;
parameter DQS_OUT_MODE                    =   "DELAY_CHAIN2";
parameter DQS_PHASE                       =             9000;
parameter DQS_PHASE_SETTING               =                2;
parameter DWIDTH_RATIO                    =                4;
parameter MEM_IF_DWIDTH                   =               64;
parameter MEM_IF_ADDR_WIDTH               =               13;
parameter MEM_IF_BANKADDR_WIDTH           =                3;
parameter MEM_IF_CS_WIDTH                 =                2;
parameter MEM_IF_DM_WIDTH                 =                8;
parameter MEM_IF_DM_PINS_EN               =                1;
parameter MEM_IF_DQ_PER_DQS               =                8;
parameter MEM_IF_DQS_WIDTH                =                8;
parameter MEM_IF_OCT_EN                   =                0;
parameter MEM_IF_CLK_PAIR_COUNT           =                3;
parameter MEM_IF_CLK_PS                   =             4000;
parameter MEM_IF_CLK_PS_STR               =        "4000 ps";
parameter MEM_IF_MR_0                     =                0;
parameter MEM_IF_MR_1                     =                0;
parameter MEM_IF_MR_2                     =                0;
parameter MEM_IF_MR_3                     =                0;
parameter MEM_IF_PRESET_RLAT              =                0;
parameter PLL_STEPS_PER_CYCLE             =               24;
parameter SCAN_CLK_DIVIDE_BY              =                4;
parameter REDUCE_SIM_TIME                 =                0;
parameter CAPABILITIES                    =                0;
parameter TINIT_TCK                       =            40000;
parameter TINIT_RST                       =           100000;
parameter DBG_A_WIDTH                     =               13;
parameter SEQ_STRING_ID                   =       "seq_name";
parameter MEM_IF_CS_PER_RANK              =                1;    // duplicates CS, CKE, ODT, sequencer still controls 1 rank, but it is subdivided from controller perspective.
parameter MEM_IF_RANKS_PER_SLOT           =                1;    // how ranks are arranged into slot - needed for odt setting in the sequencer
parameter MEM_IF_RDV_PER_CHIP             =                0;   // multiple chips, and which gives valid data
parameter GENERATE_ADDITIONAL_DBG_RTL     =                0;   // DDR2 sequencer specific
parameter CAPTURE_PHASE_OFFSET            =                0;
parameter MEM_IF_ADDR_CMD_PHASE           =                0;
parameter DLL_EXPORT_IMPORT               =           "NONE";
parameter MEM_IF_DQSN_EN                  =                1;

parameter RANK_HAS_ADDR_SWAP              =                0;

parameter INVERT_POSTAMBLE_CLK            =          "false";

//
localparam phy_report_prefix              = "ddr3_int_phy_alt_mem_phy (top level) : ";

localparam POSTAMBLE_AWIDTH                   =                6;
localparam POSTAMBLE_HALFT_EN                 =                0;
localparam POSTAMBLE_INITIAL_LAT              =               16;
localparam POSTAMBLE_RESYNC_LAT_CTL_EN        =                0;

// function to set the USE_MEM_CLK_FOR_ADDR_CMD_CLK localparam based on MEM_IF_ADDR_CMD_PHASE
function integer set_mem_clk_for_ac_clk (input reg [23:0] addr_cmd_phase);
    integer return_value;
    begin
        return_value = 0;
        case (addr_cmd_phase)
            0, 180       : return_value = 1;
            90, 270      : return_value = 0;
            default      : begin
                           //synthesis translate_off
                               $display(phy_report_prefix, "Illegal value set on MEM_IF_ADDR_CMD_PHASE parameter: ", addr_cmd_phase);
                               $stop;
                           //synthesis translate_on
                           end
        endcase
        set_mem_clk_for_ac_clk = return_value;
    end
endfunction

// function to set the ADDR_CMD_NEGEDGE_EN localparam based on MEM_IF_ADDR_CMD_PHASE
function integer set_ac_negedge_en(input reg [23:0] addr_cmd_phase);
    integer return_value;
    begin
        return_value = 0;
        case (addr_cmd_phase)
            90, 180      : return_value = 1;
            0, 270       : return_value = 0;
            default      : begin
                           //synthesis translate_off
                               $display(phy_report_prefix, "Illegal value set on MEM_IF_ADDR_CMD_PHASE parameter: ", addr_cmd_phase);
                               $stop;
                           //synthesis translate_on
                           end
        endcase
        set_ac_negedge_en = return_value;
    end
endfunction


localparam USE_MEM_CLK_FOR_ADDR_CMD_CLK   =           set_mem_clk_for_ac_clk(MEM_IF_ADDR_CMD_PHASE);
localparam ADDR_CMD_NEGEDGE_EN            =           set_ac_negedge_en(MEM_IF_ADDR_CMD_PHASE);

localparam LOCAL_IF_DWIDTH                =           MEM_IF_DWIDTH*DWIDTH_RATIO;
localparam MEM_IF_POSTAMBLE_EN_WIDTH      =           MEM_IF_DWIDTH/MEM_IF_DQ_PER_DQS;
localparam LOCAL_IF_CLK_PS                =           MEM_IF_CLK_PS/(DWIDTH_RATIO/2);
localparam PLL_REF_CLK_PS                 =           LOCAL_IF_CLK_PS;

localparam MEM_IF_DQS_CAPTURE_EN          =                1;
localparam ADDR_COUNT_WIDTH               =                4;
localparam RDP_RESYNC_LAT_CTL_EN          =                0;
localparam DEDICATED_MEMORY_CLK_EN        =                0;

localparam ADV_LAT_WIDTH                  =                5;
localparam CAPTURE_MIMIC_PATH             =                0;
localparam DDR_MIMIC_PATH_EN              =                1;
localparam MIMIC_DEBUG_EN                 =                0;
localparam NUM_MIMIC_SAMPLE_CYCLES        =                6;
localparam NUM_DEBUG_SAMPLES_TO_STORE     =             4096;
localparam ASYNCHRONOUS_AVALON_CLOCK      =                1;
localparam RDV_INITIAL_LAT                =               ((DWIDTH_RATIO == 2) && (MEM_IF_MEMTYPE == "DDR2")) ? 25 : 23;
localparam RDP_INITIAL_LAT                =                6;
localparam RESYNC_PIPELINE_DEPTH          =                0;
localparam CLOCK_INDEX_WIDTH              =                3;
localparam OCT_LAT_WIDTH                  =    ADV_LAT_WIDTH;


// I/O Signal definitions :

// Clock and reset I/O :
input  wire                                                    pll_ref_clk;
input  wire                                                    global_reset_n;
input  wire                                                    soft_reset_n;

// This is the PLL locked signal :
output wire                                                    reset_request_n;

// The controller must use this phy_clk to interface to the PHY.  It is
// optional as to whether the remainder of the system uses it :
output wire                                                    ctl_clk;
output wire                                                    ctl_reset_n;

// new AFI I/Os -  write data i/f:
input  wire [MEM_IF_DQS_WIDTH * DWIDTH_RATIO/2 -1 : 0]         ctl_dqs_burst;
input  wire [MEM_IF_DQS_WIDTH * DWIDTH_RATIO/2 -1 : 0]         ctl_wdata_valid;
input  wire [MEM_IF_DWIDTH * DWIDTH_RATIO      -1 : 0]         ctl_wdata;
input  wire [MEM_IF_DM_WIDTH * DWIDTH_RATIO    -1 : 0]         ctl_dm;
output wire [4 : 0]                                            ctl_wlat;

// new AFI I/Os - addr/cmd i/f:
input  wire [MEM_IF_ADDR_WIDTH  * DWIDTH_RATIO/2 -1 : 0]       ctl_addr;
input  wire [MEM_IF_BANKADDR_WIDTH * DWIDTH_RATIO/2 -1 : 0]    ctl_ba;
input  wire [1 * DWIDTH_RATIO/2 -1 : 0]                        ctl_cas_n;
input  wire [MEM_IF_CS_WIDTH * DWIDTH_RATIO/2 - 1:0]           ctl_cke;
input  wire [MEM_IF_CS_WIDTH * DWIDTH_RATIO/2 - 1:0]           ctl_cs_n;
input  wire [MEM_IF_CS_WIDTH * DWIDTH_RATIO/2 - 1:0]           ctl_odt;
input  wire [1 * DWIDTH_RATIO/2 -1 : 0]                        ctl_ras_n;
input  wire [1 * DWIDTH_RATIO/2 -1 : 0]                        ctl_we_n;
input  wire [DWIDTH_RATIO/2 - 1 : 0]                           ctl_rst_n;
input  wire [MEM_IF_CLK_PAIR_COUNT - 1 : 0]                    ctl_mem_clk_disable;

// new AFI I/Os - read data i/f:
input  wire [MEM_IF_DQS_WIDTH * DWIDTH_RATIO / 2 -1 : 0]       ctl_doing_rd;
output wire [MEM_IF_DWIDTH * DWIDTH_RATIO      -1 : 0]         ctl_rdata;
output wire [DWIDTH_RATIO / 2 -1 : 0]                          ctl_rdata_valid;
output wire [4 : 0]                                            ctl_rlat;

// re-calibration request and configuration:
input  wire                                                    ctl_cal_req;
input  wire [MEM_IF_DQS_WIDTH * MEM_IF_CS_WIDTH - 1 : 0]       ctl_cal_byte_lane_sel_n;

// new AFI I/Os - status interface:
output wire                                                    ctl_cal_success;
output wire                                                    ctl_cal_fail;
output wire                                                    ctl_cal_warning;


//Outputs to DIMM :
output wire [MEM_IF_ADDR_WIDTH - 1 : 0]                        mem_addr;
output wire [MEM_IF_BANKADDR_WIDTH - 1 : 0]                    mem_ba;
output wire                                                    mem_cas_n;
output wire [MEM_IF_CS_WIDTH - 1 : 0]                          mem_cke;
output wire [MEM_IF_CS_WIDTH - 1 : 0]                          mem_cs_n;
wire        [MEM_IF_DWIDTH - 1 : 0]                            mem_d;
output wire [MEM_IF_DM_WIDTH - 1 : 0]                          mem_dm;
output wire [MEM_IF_CS_WIDTH - 1 : 0]                          mem_odt;
output wire                                                    mem_ras_n;
output wire                                                    mem_we_n;
output wire                                                    mem_reset_n;

//The mem_clks are outputs, but one is sometimes used for the mimic_path, so
//is looped back in.  Therefore defining as an inout ensures no errors in Quartus :
inout  wire [MEM_IF_CLK_PAIR_COUNT - 1 : 0]                    mem_clk;
inout  wire [MEM_IF_CLK_PAIR_COUNT - 1 : 0]                    mem_clk_n;

//Bidirectional:
inout  tri  [MEM_IF_DWIDTH - 1 : 0]                            mem_dq;
inout  tri  [MEM_IF_DWIDTH / MEM_IF_DQ_PER_DQS - 1 : 0]        mem_dqs;
inout  tri  [MEM_IF_DWIDTH / MEM_IF_DQ_PER_DQS - 1 : 0]        mem_dqs_n;

input  wire [`OCT_SERIES_TERM_CONTROL_WIDTH   -1 : 0]          oct_ctl_rs_value;
input  wire [`OCT_PARALLEL_TERM_CONTROL_WIDTH -1 : 0]          oct_ctl_rt_value;

// DQS offsetting is possible with the ArriaII hardware, however this is unsupported by the IP
// in this release :
input  wire [DQS_DELAY_CTL_WIDTH - 1 : 0 ]	               dqs_offset_delay_ctrl;
input  wire [DQS_DELAY_CTL_WIDTH - 1 : 0 ]                     dqs_delay_ctrl_import;
output wire [DQS_DELAY_CTL_WIDTH - 1 : 0 ]                     dqs_delay_ctrl_export;

output wire                                                    dll_reference_clk;

// AVALON MM Slave   -- debug IF
input  wire                                                    dbg_clk;
input  wire                                                    dbg_reset_n;
input  wire [DBG_A_WIDTH -1 : 0]                               dbg_addr;
input  wire                                                    dbg_wr;
input  wire                                                    dbg_rd;
input  wire                                                    dbg_cs;
input  wire [31 : 0]                                           dbg_wr_data;
output wire [31 : 0]                                           dbg_rd_data;
output wire                                                    dbg_waitrequest;

// Auxillary clocks. These do not have to be connected if the system
// doesn't require them :
output wire                                                    aux_half_rate_clk;
output wire                                                    aux_full_rate_clk;

// Internal signal declarations :

// Clocks :

// full-rate memory clock
wire                                            mem_clk_2x;

// write_clk_2x is a full-rate write clock.  It is -90 degress aligned to the
// system clock :
wire                                            write_clk_2x;

wire                                            phy_clk_1x_src;
wire                                            phy_clk_1x;
wire                                            ac_clk_1x;
wire                                            ac_clk_2x;
wire                                            cs_n_clk_1x;
wire                                            cs_n_clk_2x;
wire                                            postamble_clk_2x;
wire                                            resync_clk_2x;
wire                                            measure_clk_1x;
wire                                            measure_clk_2x;

wire                                            half_rate_clk;

wire [DQS_DELAY_CTL_WIDTH - 1 : 0 ]             dedicated_dll_delay_ctrl;

// resets, async assert, de-assert is sync'd to each clock domain
wire                                            reset_mem_clk_2x_n;
wire                                            reset_rdp_phy_clk_1x_n;
wire                                            reset_phy_clk_1x_n;
wire                                            reset_ac_clk_1x_n;
wire                                            reset_ac_clk_2x_n;
wire                                            reset_cs_n_clk_1x_n;
wire                                            reset_cs_n_clk_2x_n;
wire                                            reset_mimic_2x_n;
wire [MEM_IF_DQS_WIDTH - 1 : 0]                 reset_resync_clk_1x_n;
wire                                            reset_resync_clk_2x_n;
wire                                            reset_seq_n;
wire                                            reset_measure_clk_1x_n;
wire                                            reset_measure_clk_2x_n;
wire                                            reset_poa_clk_2x_n;
wire                                            reset_write_clk_2x_n;

// Misc signals :
wire                                            phs_shft_busy;
wire                                            pll_seq_reconfig_busy;

// Postamble signals :

wire [MEM_IF_DQS_WIDTH * DWIDTH_RATIO /2  - 1 : 0]             poa_postamble_en_preset;
wire [MEM_IF_POSTAMBLE_EN_WIDTH - 1 : 0]                       poa_postamble_en_preset_2x;


// Sequencer signals
wire                                                           seq_mmc_start;
wire                                                           seq_pll_inc_dec_n;
wire                                                           seq_pll_start_reconfig;
wire [CLOCK_INDEX_WIDTH - 1 : 0]                               seq_pll_select;
wire [MEM_IF_DQS_WIDTH -1 : 0]                                 seq_rdp_dec_read_lat_1x;
wire [MEM_IF_DQS_WIDTH -1 : 0]                                 seq_rdp_inc_read_lat_1x;
wire [MEM_IF_DQS_WIDTH -1 : 0]                                 seq_poa_lat_dec_1x;
wire [MEM_IF_DQS_WIDTH -1 : 0]                                 seq_poa_lat_inc_1x;
wire                                                           seq_poa_protection_override_1x;

wire                                                           seq_rdp_reset_req_n;

wire                                                           seq_ac_sel;

wire [MEM_IF_ADDR_WIDTH * DWIDTH_RATIO/2 - 1 : 0]              seq_ac_addr;
wire [MEM_IF_BANKADDR_WIDTH * DWIDTH_RATIO/2 - 1 : 0]          seq_ac_ba;
wire [DWIDTH_RATIO/2 -1 : 0]                                   seq_ac_cas_n;
wire [DWIDTH_RATIO/2 -1 : 0]                                   seq_ac_ras_n;
wire [DWIDTH_RATIO/2 -1 : 0]                                   seq_ac_we_n;
wire [MEM_IF_CS_WIDTH * DWIDTH_RATIO/2 - 1 : 0]                seq_ac_cke;
wire [MEM_IF_CS_WIDTH * DWIDTH_RATIO/2 - 1 : 0]                seq_ac_cs_n;
wire [MEM_IF_CS_WIDTH * DWIDTH_RATIO/2 - 1 : 0]                seq_ac_odt;

wire [DWIDTH_RATIO * MEM_IF_DM_WIDTH - 1 : 0 ]                 seq_wdp_dm;
wire [MEM_IF_DQS_WIDTH * (DWIDTH_RATIO/2) - 1 : 0]             seq_wdp_dqs_burst;
wire [MEM_IF_DWIDTH * DWIDTH_RATIO - 1 : 0 ]                   seq_wdp_wdata;
wire [MEM_IF_DQS_WIDTH * (DWIDTH_RATIO/2) - 1 : 0]             seq_wdp_wdata_valid;
wire [DWIDTH_RATIO - 1 :0]                                     seq_wdp_dqs;
wire                                                           seq_wdp_ovride;

wire [MEM_IF_DQS_WIDTH * (DWIDTH_RATIO/2) - 1 : 0]             oct_rsst_sel;

wire [MEM_IF_DQS_WIDTH * DWIDTH_RATIO/2 - 1 : 0]               seq_doing_rd;
wire                                                           seq_rdata_valid_lat_inc;
wire                                                           seq_rdata_valid_lat_dec;

wire  [DWIDTH_RATIO/2 - 1 : 0]                                 seq_rdata_valid;

reg  [DQS_DELAY_CTL_WIDTH - 1 : 0 ]                            dedicated_dll_delay_ctrl_r;

wire [DQS_DELAY_CTL_WIDTH - 1 : 0 ]                            dqs_delay_ctrl_internal;
wire [DQS_DELAY_CTL_WIDTH - 1 : 0 ]                            dqs_delay_ctrl; // Output from clk_reset block

// set pll clock index of resync and mimic clocks
wire [CLOCK_INDEX_WIDTH                        - 1 : 0]        pll_resync_clk_index;
wire [CLOCK_INDEX_WIDTH                        - 1 : 0]        pll_measure_clk_index;

// The clk_reset block provides the sc_clk to the sequencer and DP blocks.
wire                                               sc_clk;
wire [MEM_IF_DQS_WIDTH - 1 : 0]                    sc_clk_dp;

// Mimic signals :
wire                                               mmc_seq_done;
wire                                               mmc_seq_value;
wire                                               mimic_data;

wire                                               mux_seq_controller_ready;
wire                                               mux_seq_wdata_req;


// Read datapath signals :

// Connections from the IOE to the read datapath :
wire [MEM_IF_DWIDTH - 1 : 0]                       dio_rdata_h_2x;
wire [MEM_IF_DWIDTH - 1 : 0]                       dio_rdata_l_2x;


// Write datapath signals :



// wires from the wdp to the dpio :
wire [MEM_IF_DWIDTH - 1 : 0]                 wdp_wdata3_1x;
wire [MEM_IF_DWIDTH - 1 : 0]                 wdp_wdata2_1x;
wire [MEM_IF_DWIDTH - 1 : 0]                 wdp_wdata1_1x;
wire [MEM_IF_DWIDTH - 1 : 0]                 wdp_wdata0_1x;


wire [MEM_IF_DWIDTH - 1 : 0]                 wdp_wdata_h_2x;
wire [MEM_IF_DWIDTH - 1 : 0]                 wdp_wdata_l_2x;
wire [MEM_IF_DWIDTH - 1 : 0]                 wdp_wdata_oe_2x;
wire  [(LOCAL_IF_DWIDTH/8) - 1 : 0]          ctl_mem_be;

wire [MEM_IF_DQS_WIDTH - 1 : 0]              wdp_wdata_oe_h_1x;
wire [MEM_IF_DQS_WIDTH - 1 : 0]              wdp_wdata_oe_l_1x;

wire [MEM_IF_DQS_WIDTH - 1 : 0]              wdp_dqs3_1x;
wire [MEM_IF_DQS_WIDTH - 1 : 0]              wdp_dqs2_1x;
wire [MEM_IF_DQS_WIDTH - 1 : 0]              wdp_dqs1_1x;
wire [MEM_IF_DQS_WIDTH - 1 : 0]              wdp_dqs0_1x;

wire [(MEM_IF_DQS_WIDTH) - 1 : 0]            wdp_wdqs_2x;

wire [MEM_IF_DQS_WIDTH - 1 : 0]              wdp_dqs_oe_h_1x;
wire [MEM_IF_DQS_WIDTH - 1 : 0]              wdp_dqs_oe_l_1x;

wire [(MEM_IF_DQS_WIDTH) - 1 : 0]            wdp_wdqs_oe_2x;

wire [MEM_IF_DM_WIDTH -1 : 0]                wdp_dm3_1x;
wire [MEM_IF_DM_WIDTH -1 : 0]                wdp_dm2_1x;
wire [MEM_IF_DM_WIDTH -1 : 0]                wdp_dm1_1x;
wire [MEM_IF_DM_WIDTH -1 : 0]                wdp_dm0_1x;

wire [MEM_IF_DM_WIDTH -1 : 0]                wdp_dm_h_2x;
wire [MEM_IF_DM_WIDTH -1 : 0]                wdp_dm_l_2x;

wire [MEM_IF_DQS_WIDTH -1 : 0]               wdp_oct_h_1x;
wire [MEM_IF_DQS_WIDTH -1 : 0]               wdp_oct_l_1x;

wire [MEM_IF_DQS_WIDTH -1 : 0]               seq_dqs_add_2t_delay;

wire                                         ctl_add_1t_ac_lat_internal;
wire                                         ctl_add_1t_odt_lat_internal;
wire                                         ctl_add_intermediate_regs_internal;
wire                                         ctl_negedge_en_internal;

wire                                         ctl_mem_dqs_burst;
wire [MEM_IF_DWIDTH*DWIDTH_RATIO - 1 : 0]    ctl_mem_wdata;
wire                                         ctl_mem_wdata_valid;

// These ports are tied off for DDR,DDR2,DDR3.  Registers are used to reduce Quartus warnings :
(* preserve *) reg [3 : 0]                   ctl_mem_dqs = 4'b1100;

wire [MEM_IF_CS_WIDTH - 1 : 0]               int_rank_has_addr_swap;

//SIII declarations :

//Outputs from the dp_io block to the read_dp block :
wire [MEM_IF_DWIDTH - 1 : 0]                     dio_rdata3_1x;
wire [MEM_IF_DWIDTH - 1 : 0]                     dio_rdata2_1x;
wire [MEM_IF_DWIDTH - 1 : 0]                     dio_rdata1_1x;
wire [MEM_IF_DWIDTH - 1 : 0]                     dio_rdata0_1x;

wire [MEM_IF_DQS_WIDTH * DWIDTH_RATIO/2 - 1 : 0]  merged_doing_rd;

wire [OCT_LAT_WIDTH - 1 : 0]                     seq_oct_oct_delay; // oct_lat
wire [OCT_LAT_WIDTH - 1 : 0]                     seq_oct_oct_extend; //oct_extend_duration
wire seq_oct_val;

wire seq_mem_clk_disable;

wire [DWIDTH_RATIO/2 - 1 : 0]                    seq_ac_rst_n;

wire                                             dqs_delay_update_en;
wire [DQS_DELAY_CTL_WIDTH - 1 : 0 ]              dlloffset_offsetctrl_out;


// Use either the imported DQS delay or the clock/reset output :
generate

    if (DLL_EXPORT_IMPORT == "IMPORT")
        assign dqs_delay_ctrl_internal = dqs_delay_ctrl_import;
    else
        assign dqs_delay_ctrl_internal = dqs_delay_ctrl;

endgenerate


// Generate auxillary clocks:
generate

    // Half-rate mode :
    if (DWIDTH_RATIO == 4)
    begin
        assign aux_half_rate_clk = phy_clk_1x;
        assign aux_full_rate_clk = mem_clk_2x;
    end

    // Full-rate mode :
    else
    begin
        assign aux_half_rate_clk = half_rate_clk;
        assign aux_full_rate_clk = phy_clk_1x;
    end

endgenerate

// The top level I/O should not have the "Nx" clock domain suffices, so this is
// assigned here.  Also note that to avoid delta delay issues both the external and
// internal phy_clks are assigned to a common 'src' clock :
assign ctl_clk         = phy_clk_1x_src;
assign phy_clk_1x      = phy_clk_1x_src;

assign ctl_reset_n     = reset_phy_clk_1x_n;

// Export the internally generated DQS delay :
assign dqs_delay_ctrl_export = dqs_delay_ctrl;
assign dll_reference_clk     = mem_clk_2x;

// Instance I/O modules :


//
ddr3_int_phy_alt_mem_phy_dp_io #(
    .MEM_IF_DWIDTH              (MEM_IF_DWIDTH),
    .MEM_IF_DM_PINS_EN          (MEM_IF_DM_PINS_EN),
    .MEM_IF_DM_WIDTH            (MEM_IF_DM_WIDTH),
    .MEM_IF_DQ_PER_DQS          (MEM_IF_DQ_PER_DQS),
    .MEM_IF_DQS_WIDTH           (MEM_IF_DQS_WIDTH),
    .MEM_IF_MEMTYPE             (MEM_IF_MEMTYPE),
    .MEM_IF_DQSN_EN             (MEM_IF_DQSN_EN),
    .MEM_IF_POSTAMBLE_EN_WIDTH  (MEM_IF_POSTAMBLE_EN_WIDTH),
    .DQS_DELAY_CTL_WIDTH        (DQS_DELAY_CTL_WIDTH)
) dpio (
    .reset_write_clk_2x_n       (reset_write_clk_2x_n),
    .resync_clk_2x              (resync_clk_2x),
    .postamble_clk_2x           (postamble_clk_2x),
    .mem_clk_2x                 (mem_clk_2x),
    .write_clk_2x               (write_clk_2x),
    .dqs_delay_ctrl             (dqs_delay_ctrl_internal),
    .mem_dm                     (mem_dm),
    .mem_dq                     (mem_dq),
    .mem_dqs                    (mem_dqs),
    .mem_dqsn                   (mem_dqs_n),
    .dio_rdata_h_2x             (dio_rdata_h_2x),
    .dio_rdata_l_2x             (dio_rdata_l_2x),
    .poa_postamble_en_preset_2x (poa_postamble_en_preset_2x),
    .wdp_dm_h_2x                (wdp_dm_h_2x),
    .wdp_dm_l_2x                (wdp_dm_l_2x),
    .wdp_wdata_h_2x             (wdp_wdata_h_2x),
    .wdp_wdata_l_2x             (wdp_wdata_l_2x),
    .wdp_wdata_oe_2x            (wdp_wdata_oe_2x),
    .wdp_wdqs_2x                (wdp_wdqs_2x),
    .wdp_wdqs_oe_2x             (wdp_wdqs_oe_2x)
);

// Instance the read datapath :

//
ddr3_int_phy_alt_mem_phy_read_dp #(
    .ADDR_COUNT_WIDTH          (ADDR_COUNT_WIDTH),
    .BIDIR_DPINS               (1),
    .DWIDTH_RATIO              (DWIDTH_RATIO),
    .MEM_IF_CLK_PS             (MEM_IF_CLK_PS),
    .FAMILY                    (FAMILY),
    .LOCAL_IF_DWIDTH           (LOCAL_IF_DWIDTH),
    .MEM_IF_DQ_PER_DQS         (MEM_IF_DQ_PER_DQS),
    .MEM_IF_DQS_WIDTH          (MEM_IF_DQS_WIDTH),
    .MEM_IF_DWIDTH             (MEM_IF_DWIDTH),
    .RDP_INITIAL_LAT           (RDP_INITIAL_LAT),
    .RDP_RESYNC_LAT_CTL_EN     (RDP_RESYNC_LAT_CTL_EN),
    .RESYNC_PIPELINE_DEPTH     (RESYNC_PIPELINE_DEPTH)
) rdp (
    .phy_clk_1x                (phy_clk_1x),
    .resync_clk_2x             (resync_clk_2x),
    .reset_phy_clk_1x_n        (reset_rdp_phy_clk_1x_n),
    .reset_resync_clk_2x_n     (reset_resync_clk_2x_n),
    .seq_rdp_dec_read_lat_1x   (seq_rdp_dec_read_lat_1x[0]),
    .seq_rdp_dmx_swap          (1'b0),
    .seq_rdp_inc_read_lat_1x   (seq_rdp_inc_read_lat_1x[0]),
    .dio_rdata_h_2x            (dio_rdata_h_2x),
    .dio_rdata_l_2x            (dio_rdata_l_2x),
    .ctl_mem_rdata             (ctl_rdata)
);
//          enhancements a different delay per dqs group may be implemented using the
//          full vector


// Instance the write datapath :

generate

    // Half-rate Write datapath :
    if (DWIDTH_RATIO == 4)
    begin : half_rate_wdp_gen

        //
        ddr3_int_phy_alt_mem_phy_write_dp #(
                    .MEM_IF_MEMTYPE        (MEM_IF_MEMTYPE),
            .BIDIR_DPINS           (1),
            .LOCAL_IF_DRATE        ("HALF"),
            .LOCAL_IF_DWIDTH       (LOCAL_IF_DWIDTH),
            .MEM_IF_DM_WIDTH       (MEM_IF_DM_WIDTH),
            .MEM_IF_DQ_PER_DQS     (MEM_IF_DQ_PER_DQS),
            .MEM_IF_DQS_WIDTH      (MEM_IF_DQS_WIDTH),
            .GENERATE_WRITE_DQS    (1),
            .MEM_IF_DWIDTH         (MEM_IF_DWIDTH),
            .DWIDTH_RATIO          (DWIDTH_RATIO)
        ) wdp (
            .phy_clk_1x            (phy_clk_1x),
            .mem_clk_2x            (mem_clk_2x),
            .write_clk_2x          (write_clk_2x),
            .reset_phy_clk_1x_n    (reset_phy_clk_1x_n),
            .reset_mem_clk_2x_n    (reset_mem_clk_2x_n),
            .reset_write_clk_2x_n  (reset_write_clk_2x_n),
            .ctl_mem_be            (ctl_dm),
            .ctl_mem_dqs_burst     (ctl_dqs_burst),
            .ctl_mem_wdata         (ctl_wdata),
            .ctl_mem_wdata_valid   (ctl_wdata_valid),
            .seq_be                (seq_wdp_dm),
            .seq_dqs_burst         (seq_wdp_dqs_burst),
            .seq_wdata             (seq_wdp_wdata),
            .seq_wdata_valid       (seq_wdp_wdata_valid),
            .seq_ctl_sel           (seq_wdp_ovride),
            .wdp_wdata_h_2x        (wdp_wdata_h_2x),
            .wdp_wdata_l_2x        (wdp_wdata_l_2x),
            .wdp_wdata_oe_2x       (wdp_wdata_oe_2x),
            .wdp_wdqs_2x           (wdp_wdqs_2x),
            .wdp_wdqs_oe_2x        (wdp_wdqs_oe_2x),
            .wdp_dm_h_2x           (wdp_dm_h_2x),
            .wdp_dm_l_2x           (wdp_dm_l_2x)
        );

    end

    // Full-rate :
    else
    begin : full_rate_wdp_gen

        //
        ddr3_int_phy_alt_mem_phy_write_dp_fr #(
                    .BIDIR_DPINS           (1),
            .LOCAL_IF_DRATE        ("FULL"),
            .LOCAL_IF_DWIDTH       (LOCAL_IF_DWIDTH),
            .MEM_IF_DM_WIDTH       (MEM_IF_DM_WIDTH),
            .MEM_IF_DQ_PER_DQS     (MEM_IF_DQ_PER_DQS),
            .MEM_IF_DQS_WIDTH      (MEM_IF_DQS_WIDTH),
            .GENERATE_WRITE_DQS    (1),
            .MEM_IF_DWIDTH         (MEM_IF_DWIDTH),
            .DWIDTH_RATIO          (DWIDTH_RATIO)
        ) wdp (
            .phy_clk_1x            (phy_clk_1x),
            .mem_clk_2x            (mem_clk_2x),
            .write_clk_2x          (write_clk_2x),
            .reset_phy_clk_1x_n    (reset_phy_clk_1x_n),
            .reset_mem_clk_2x_n    (reset_mem_clk_2x_n),
            .reset_write_clk_2x_n  (reset_write_clk_2x_n),
            .ctl_mem_be            (ctl_dm),
            .ctl_mem_dqs_burst     (ctl_dqs_burst),
            .ctl_mem_wdata         (ctl_wdata),
            .ctl_mem_wdata_valid   (ctl_wdata_valid),
            .seq_be                (seq_wdp_dm),
            .seq_dqs_burst         (seq_wdp_dqs_burst),
            .seq_wdata             (seq_wdp_wdata),
            .seq_wdata_valid       (seq_wdp_wdata_valid),
            .seq_ctl_sel            (seq_wdp_ovride),
            .wdp_wdata_h_2x        (wdp_wdata_h_2x),
            .wdp_wdata_l_2x        (wdp_wdata_l_2x),
            .wdp_wdata_oe_2x       (wdp_wdata_oe_2x),
            .wdp_wdqs_2x           (wdp_wdqs_2x),
            .wdp_wdqs_oe_2x        (wdp_wdqs_oe_2x),
            .wdp_dm_h_2x           (wdp_dm_h_2x),
            .wdp_dm_l_2x           (wdp_dm_l_2x)
        );

    end

endgenerate


// Instance the address and command :
// A CIII ADC block is used, as the ADC clock may be set to one of four quadrant positions,
// not an arbitrary PLL phase :
generate

    // Half-rate address and command :
    if (DWIDTH_RATIO == 4)
    begin : half_rate_adc_gen

        //
        ddr3_int_phy_alt_mem_phy_addr_cmd #(
                     .DWIDTH_RATIO                 (DWIDTH_RATIO),
             .MEM_ADDR_CMD_BUS_COUNT       (1),
             .MEM_IF_BANKADDR_WIDTH        (MEM_IF_BANKADDR_WIDTH),
             .MEM_IF_CS_WIDTH              (MEM_IF_CS_WIDTH),
             .MEM_IF_MEMTYPE               (MEM_IF_MEMTYPE),
             .MEM_IF_ROWADDR_WIDTH         (MEM_IF_ADDR_WIDTH)
        ) adc (
             .ac_clk_1x                    (ac_clk_1x),
             .ac_clk_2x                    (ac_clk_2x),
             .cs_n_clk_1x                  (cs_n_clk_1x),
             .cs_n_clk_2x                  (cs_n_clk_2x),
             .phy_clk_1x                   (phy_clk_1x),
             .reset_ac_clk_1x_n            (reset_ac_clk_1x_n),
             .reset_ac_clk_2x_n            (reset_ac_clk_2x_n),
             .reset_cs_n_clk_1x_n          (reset_cs_n_clk_1x_n),
             .reset_cs_n_clk_2x_n          (reset_cs_n_clk_2x_n),
             .ctl_add_1t_ac_lat            (ctl_add_1t_ac_lat_internal),
             .ctl_add_1t_odt_lat           (ctl_add_1t_odt_lat_internal),
             .ctl_add_intermediate_regs    (ctl_add_intermediate_regs_internal),
        //     .ctl_negedge_en               (ctl_negedge_en_internal),
             .ctl_negedge_en               (ADDR_CMD_NEGEDGE_EN[0 : 0]),
             .ctl_mem_addr_h               (ctl_addr[MEM_IF_ADDR_WIDTH -1 : 0]),
             .ctl_mem_addr_l               (ctl_addr[(MEM_IF_ADDR_WIDTH  * DWIDTH_RATIO/2) -1 : MEM_IF_ADDR_WIDTH]),
             .ctl_mem_ba_h                 (ctl_ba[MEM_IF_BANKADDR_WIDTH -1 : 0]),
             .ctl_mem_ba_l                 (ctl_ba[MEM_IF_BANKADDR_WIDTH * DWIDTH_RATIO/2 -1 : MEM_IF_BANKADDR_WIDTH]),
             .ctl_mem_cas_n_h              (ctl_cas_n[0]),
             .ctl_mem_cas_n_l              (ctl_cas_n[1]),
             .ctl_mem_cke_h                (ctl_cke[MEM_IF_CS_WIDTH - 1 : 0]),
             .ctl_mem_cke_l                (ctl_cke[MEM_IF_CS_WIDTH * DWIDTH_RATIO/2 - 1 : MEM_IF_CS_WIDTH]),
             .ctl_mem_cs_n_h               (ctl_cs_n[MEM_IF_CS_WIDTH - 1 : 0]),
             .ctl_mem_cs_n_l               (ctl_cs_n[MEM_IF_CS_WIDTH * DWIDTH_RATIO/2 - 1 : MEM_IF_CS_WIDTH]),
             .ctl_mem_odt_h                (ctl_odt[MEM_IF_CS_WIDTH - 1 : 0]),
             .ctl_mem_odt_l                (ctl_odt[MEM_IF_CS_WIDTH * DWIDTH_RATIO/2 - 1 : MEM_IF_CS_WIDTH]),
             .ctl_mem_ras_n_h              (ctl_ras_n[0]),
             .ctl_mem_ras_n_l              (ctl_ras_n[1]),
             .ctl_mem_we_n_h               (ctl_we_n[0]),
             .ctl_mem_we_n_l               (ctl_we_n[1]),
             .ctl_mem_rst_n_h              (ctl_rst_n[0]),
             .ctl_mem_rst_n_l              (ctl_rst_n[1]),
             .seq_addr_h                   (seq_ac_addr[MEM_IF_ADDR_WIDTH -1 : 0]),
             .seq_addr_l                   (seq_ac_addr[MEM_IF_ADDR_WIDTH  * DWIDTH_RATIO/2 -1 : MEM_IF_ADDR_WIDTH]),
             .seq_ba_h                     (seq_ac_ba[MEM_IF_BANKADDR_WIDTH -1 : 0]),
             .seq_ba_l                     (seq_ac_ba[MEM_IF_BANKADDR_WIDTH * DWIDTH_RATIO/2 -1 : MEM_IF_BANKADDR_WIDTH]),
             .seq_cas_n_h                  (seq_ac_cas_n[0]),
             .seq_cas_n_l                  (seq_ac_cas_n[1]),
             .seq_cke_h                    (seq_ac_cke[MEM_IF_CS_WIDTH - 1 : 0]),
             .seq_cke_l                    (seq_ac_cke[MEM_IF_CS_WIDTH * DWIDTH_RATIO/2 - 1 : MEM_IF_CS_WIDTH]),
             .seq_cs_n_h                   (seq_ac_cs_n[MEM_IF_CS_WIDTH - 1 : 0]),
             .seq_cs_n_l                   (seq_ac_cs_n[MEM_IF_CS_WIDTH * DWIDTH_RATIO/2 - 1 : MEM_IF_CS_WIDTH]),
             .seq_odt_h                    (seq_ac_odt[MEM_IF_CS_WIDTH - 1 : 0]),
             .seq_odt_l                    (seq_ac_odt[MEM_IF_CS_WIDTH * DWIDTH_RATIO/2 - 1 : MEM_IF_CS_WIDTH]),
             .seq_ras_n_h                  (seq_ac_ras_n[0]),
             .seq_ras_n_l                  (seq_ac_ras_n[1]),
             .seq_we_n_h                   (seq_ac_we_n[0]),
             .seq_we_n_l                   (seq_ac_we_n[1]),
             .seq_mem_rst_n_h              (seq_ac_rst_n[0]),
             .seq_mem_rst_n_l              (seq_ac_rst_n[1]),
             .seq_ac_sel                   (seq_ac_sel),
             .mem_addr                     (mem_addr),
             .mem_ba                       (mem_ba),
             .mem_cas_n                    (mem_cas_n),
             .mem_cke                      (mem_cke),
             .mem_cs_n                     (mem_cs_n),
             .mem_odt                      (mem_odt),
             .mem_ras_n                    (mem_ras_n),
             .mem_we_n                     (mem_we_n),
             .mem_rst_n                    (mem_reset_n)
        );
    end

    // Full-rate :
    else
    begin : full_rate_adc_gen

        //
        ddr3_int_phy_alt_mem_phy_addr_cmd #(
                     .DWIDTH_RATIO                 (DWIDTH_RATIO),
             .MEM_ADDR_CMD_BUS_COUNT       (1),
             .MEM_IF_BANKADDR_WIDTH        (MEM_IF_BANKADDR_WIDTH),
             .MEM_IF_CS_WIDTH              (MEM_IF_CS_WIDTH),
             .MEM_IF_MEMTYPE               (MEM_IF_MEMTYPE),
             .MEM_IF_ROWADDR_WIDTH         (MEM_IF_ADDR_WIDTH)
        ) adc (
             .ac_clk_1x                    (ac_clk_1x),
             .ac_clk_2x                    (ac_clk_2x),
             .cs_n_clk_1x                  (cs_n_clk_1x),
             .cs_n_clk_2x                  (cs_n_clk_2x),
             .phy_clk_1x                   (phy_clk_1x),
             .reset_ac_clk_1x_n            (reset_ac_clk_1x_n),
             .reset_ac_clk_2x_n            (reset_ac_clk_2x_n),
             .reset_cs_n_clk_1x_n          (reset_cs_n_clk_1x_n),
             .reset_cs_n_clk_2x_n          (reset_cs_n_clk_2x_n),
             .ctl_add_1t_ac_lat            (ctl_add_1t_ac_lat_internal),
             .ctl_add_1t_odt_lat           (ctl_add_1t_odt_lat_internal),
             .ctl_add_intermediate_regs    (ctl_add_intermediate_regs_internal),
        //     .ctl_negedge_en               (ctl_negedge_en_internal),
             .ctl_negedge_en               (ADDR_CMD_NEGEDGE_EN[0 : 0]),
             .ctl_mem_addr_h               (),
             .ctl_mem_addr_l               (ctl_addr[MEM_IF_ADDR_WIDTH  -1 : 0]),
             .ctl_mem_ba_h                 (),
             .ctl_mem_ba_l                 (ctl_ba[MEM_IF_BANKADDR_WIDTH -1 : 0]),
             .ctl_mem_cas_n_h              (),
             .ctl_mem_cas_n_l              (ctl_cas_n[0]),
             .ctl_mem_cke_h                (),
             .ctl_mem_cke_l                (ctl_cke[MEM_IF_CS_WIDTH - 1 : 0]),
             .ctl_mem_cs_n_h               (),
             .ctl_mem_cs_n_l               (ctl_cs_n[MEM_IF_CS_WIDTH - 1 : 0]),
             .ctl_mem_odt_h                (),
             .ctl_mem_odt_l                (ctl_odt[MEM_IF_CS_WIDTH - 1 : 0]),
             .ctl_mem_ras_n_h              (),
             .ctl_mem_ras_n_l              (ctl_ras_n[0]),
             .ctl_mem_we_n_h               (),
             .ctl_mem_we_n_l               (ctl_we_n[0]),
             .ctl_mem_rst_n_h              (),
             .ctl_mem_rst_n_l              (ctl_rst_n[0]),
             .seq_addr_h                   (),
             .seq_addr_l                   (seq_ac_addr[MEM_IF_ADDR_WIDTH -1 : 0]),
             .seq_ba_h                     (),
             .seq_ba_l                     (seq_ac_ba[MEM_IF_BANKADDR_WIDTH -1 : 0]),
             .seq_cas_n_h                  (),
             .seq_cas_n_l                  (seq_ac_cas_n[0]),
             .seq_cke_h                    (),
             .seq_cke_l                    (seq_ac_cke[MEM_IF_CS_WIDTH - 1 : 0]),
             .seq_cs_n_h                   (),
             .seq_cs_n_l                   (seq_ac_cs_n[MEM_IF_CS_WIDTH - 1 : 0]),
             .seq_odt_h                    (),
             .seq_odt_l                    (seq_ac_odt[MEM_IF_CS_WIDTH - 1 : 0]),
             .seq_ras_n_h                  (),
             .seq_ras_n_l                  (seq_ac_ras_n[0]),
             .seq_we_n_h                   (),
             .seq_we_n_l                   (seq_ac_we_n[0]),
             .seq_mem_rst_n_h              (),
             .seq_mem_rst_n_l              (seq_ac_rst_n[0]),
             .seq_ac_sel                   (seq_ac_sel),
             .mem_addr                     (mem_addr),
             .mem_ba                       (mem_ba),
             .mem_cas_n                    (mem_cas_n),
             .mem_cke                      (mem_cke),
             .mem_cs_n                     (mem_cs_n),
             .mem_odt                      (mem_odt),
             .mem_ras_n                    (mem_ras_n),
             .mem_we_n                     (mem_we_n),
             .mem_rst_n                    (mem_reset_n)
        );

    end
endgenerate


//
ddr3_int_phy_alt_mem_phy_postamble #(
    .FAMILY                         (FAMILY),
    .DWIDTH_RATIO                   (DWIDTH_RATIO),
    .MEM_IF_POSTAMBLE_EN_WIDTH      (MEM_IF_POSTAMBLE_EN_WIDTH),
    .POSTAMBLE_AWIDTH               (POSTAMBLE_AWIDTH),
    .POSTAMBLE_HALFT_EN             (POSTAMBLE_HALFT_EN),
    .POSTAMBLE_INITIAL_LAT          (POSTAMBLE_INITIAL_LAT),
    .POSTAMBLE_RESYNC_LAT_CTL_EN    (POSTAMBLE_RESYNC_LAT_CTL_EN)
) poa (
    .phy_clk_1x                     (phy_clk_1x),
    .poa_postamble_en_preset_2x     (poa_postamble_en_preset_2x),
    .postamble_clk_2x               (postamble_clk_2x),
    .reset_phy_clk_1x_n             (reset_rdp_phy_clk_1x_n),
    .reset_poa_clk_2x_n             (reset_poa_clk_2x_n),
    .ctl_doing_rd_beat1_1x          (merged_doing_rd[0]),
    .ctl_doing_rd_beat2_1x          (DWIDTH_RATIO == 4 ? merged_doing_rd[MEM_IF_DQS_WIDTH] : merged_doing_rd[0]),
    .seq_poa_lat_dec_1x             (seq_poa_lat_dec_1x[0]),
    .seq_poa_lat_inc_1x             (seq_poa_lat_inc_1x[0]),
    .seq_poa_protection_override_1x (seq_poa_protection_override_1x)
);

// Generate the data postamble paths (merged_doing_rd)
 assign merged_doing_rd = seq_doing_rd | (ctl_doing_rd & {((DWIDTH_RATIO/2) * MEM_IF_DQS_WIDTH) {ctl_cal_success}});


 assign int_rank_has_addr_swap = RANK_HAS_ADDR_SWAP[MEM_IF_CS_WIDTH - 1 : 0];
 assign pll_resync_clk_index   = 5;
 assign pll_measure_clk_index  = 7;

   //
  ddr3_int_phy_alt_mem_phy_seq_wrapper
      //
    seq_wrapper (
        .phy_clk_1x                         (phy_clk_1x),
        .reset_phy_clk_1x_n                 (reset_phy_clk_1x_n),
        .ctl_cal_success                    (ctl_cal_success),
        .ctl_cal_fail                       (ctl_cal_fail),
        .ctl_cal_warning                    (ctl_cal_warning),
        .ctl_cal_req                        (ctl_cal_req),
        .int_RANK_HAS_ADDR_SWAP             (int_rank_has_addr_swap),
        .ctl_cal_byte_lane_sel_n            (ctl_cal_byte_lane_sel_n),
        .seq_pll_inc_dec_n                  (seq_pll_inc_dec_n),
        .seq_pll_start_reconfig             (seq_pll_start_reconfig),
        .seq_pll_select                     (seq_pll_select),
        .phs_shft_busy                      (phs_shft_busy),
        .pll_resync_clk_index               (pll_resync_clk_index),
        .pll_measure_clk_index              (pll_measure_clk_index),
        .sc_clk_dp                          (),
        .scan_enable_dqs_config             (),
        .scan_update                        (),
        .scan_din                           (),
        .scan_enable_ck                     (),
        .scan_enable_dqs                    (),
        .scan_enable_dqsn                   (),
        .scan_enable_dq                     (),
        .scan_enable_dm                     (),
        .hr_rsc_clk                         (1'b0), // Halfrate resync clock not required for non-SIII style families.
        .seq_ac_addr                        (seq_ac_addr),
        .seq_ac_ba                          (seq_ac_ba),
        .seq_ac_cas_n                       (seq_ac_cas_n),
        .seq_ac_ras_n                       (seq_ac_ras_n),
        .seq_ac_we_n                        (seq_ac_we_n),
        .seq_ac_cke                         (seq_ac_cke),
        .seq_ac_cs_n                        (seq_ac_cs_n),
        .seq_ac_odt                         (seq_ac_odt),
        .seq_ac_rst_n                       (seq_ac_rst_n),
        .seq_ac_sel                         (seq_ac_sel),
        .seq_mem_clk_disable                (seq_mem_clk_disable),
        .ctl_add_1t_ac_lat_internal         (ctl_add_1t_ac_lat_internal),
        .ctl_add_1t_odt_lat_internal        (ctl_add_1t_odt_lat_internal),
        .ctl_add_intermediate_regs_internal (ctl_add_intermediate_regs_internal),
        .seq_rdv_doing_rd                   (seq_doing_rd),
        .seq_rdp_reset_req_n                (seq_rdp_reset_req_n),
        .seq_rdp_inc_read_lat_1x            (seq_rdp_inc_read_lat_1x),
        .seq_rdp_dec_read_lat_1x            (seq_rdp_dec_read_lat_1x),
        .ctl_rdata                          (ctl_rdata),
        .int_rdata_valid_1t                 (seq_rdata_valid),
        .seq_rdata_valid_lat_inc            (seq_rdata_valid_lat_inc),
        .seq_rdata_valid_lat_dec            (seq_rdata_valid_lat_dec),
        .ctl_rlat                           (ctl_rlat),
        .seq_poa_lat_dec_1x                 (seq_poa_lat_dec_1x),
        .seq_poa_lat_inc_1x                 (seq_poa_lat_inc_1x),
        .seq_poa_protection_override_1x     (seq_poa_protection_override_1x),
        .seq_oct_oct_delay                  (seq_oct_oct_delay),
        .seq_oct_oct_extend                 (seq_oct_oct_extend),
        .seq_oct_val                        (seq_oct_val),
        .seq_wdp_dqs_burst                  (seq_wdp_dqs_burst),
        .seq_wdp_wdata_valid                (seq_wdp_wdata_valid),
        .seq_wdp_wdata                      (seq_wdp_wdata),
        .seq_wdp_dm                         (seq_wdp_dm),
        .seq_wdp_dqs                        (seq_wdp_dqs),
        .seq_wdp_ovride                     (seq_wdp_ovride),
        .seq_dqs_add_2t_delay               (seq_dqs_add_2t_delay),
        .ctl_wlat                           (ctl_wlat),
        .seq_mmc_start                      (seq_mmc_start),
        .mmc_seq_done                       (mmc_seq_done),
        .mmc_seq_value                      (mmc_seq_value),
        .mem_err_out_n                      (1'b1),
        .parity_error_n                     (),
        .dbg_clk                            (dbg_clk),
        .dbg_reset_n                        (dbg_reset_n),
        .dbg_addr                           (dbg_addr),
        .dbg_wr                             (dbg_wr),
        .dbg_rd                             (dbg_rd),
        .dbg_cs                             (dbg_cs),
        .dbg_wr_data                        (dbg_wr_data),
        .dbg_rd_data                        (dbg_rd_data),
        .dbg_waitrequest                    (dbg_waitrequest)
    );

// Generate rdata_valid for sequencer and control blocks
//
ddr3_int_phy_alt_mem_phy_rdata_valid #(
     .FAMILY                    (FAMILY),
     .MEM_IF_DQS_WIDTH          (MEM_IF_DQS_WIDTH),
     .RDATA_VALID_AWIDTH        (5),
     .RDATA_VALID_INITIAL_LAT   (RDV_INITIAL_LAT),
     .DWIDTH_RATIO              (DWIDTH_RATIO)
) rdv_pipe (
     .phy_clk_1x                (phy_clk_1x),
     .reset_phy_clk_1x_n        (reset_rdp_phy_clk_1x_n),
     .seq_rdata_valid_lat_dec   (seq_rdata_valid_lat_dec),
     .seq_rdata_valid_lat_inc   (seq_rdata_valid_lat_inc),
     .seq_doing_rd              (seq_doing_rd),
     .ctl_doing_rd              (ctl_doing_rd),
     .ctl_cal_success           (ctl_cal_success),
     .ctl_rdata_valid           (ctl_rdata_valid),
     .seq_rdata_valid           (seq_rdata_valid)
);

// Instance the AII clock and reset :


//
ddr3_int_phy_alt_mem_phy_clk_reset #(
    .CLOCK_INDEX_WIDTH                    (CLOCK_INDEX_WIDTH),
    .DLL_EXPORT_IMPORT                    (DLL_EXPORT_IMPORT),
    .DWIDTH_RATIO                         (DWIDTH_RATIO),
    .LOCAL_IF_CLK_PS                      (LOCAL_IF_CLK_PS),
    .MEM_IF_CLK_PAIR_COUNT                (MEM_IF_CLK_PAIR_COUNT),
    .MEM_IF_CLK_PS                        (MEM_IF_CLK_PS),
    .MEM_IF_CLK_PS_STR                    (MEM_IF_CLK_PS_STR),
    .MEM_IF_DWIDTH                        (MEM_IF_DWIDTH),
    .MEM_IF_MEMTYPE                       (MEM_IF_MEMTYPE),
    .MEM_IF_DQSN_EN                       (MEM_IF_DQSN_EN),
    .DLL_DELAY_BUFFER_MODE                (DLL_DELAY_BUFFER_MODE),
    .DLL_DELAY_CHAIN_LENGTH               (DLL_DELAY_CHAIN_LENGTH),
    .SCAN_CLK_DIVIDE_BY                   (SCAN_CLK_DIVIDE_BY),
    .USE_MEM_CLK_FOR_ADDR_CMD_CLK         (USE_MEM_CLK_FOR_ADDR_CMD_CLK),
    .DQS_DELAY_CTL_WIDTH                  (DQS_DELAY_CTL_WIDTH),
    .INVERT_POSTAMBLE_CLK                 (INVERT_POSTAMBLE_CLK)
) clk (
    .pll_ref_clk                          (pll_ref_clk),
    .global_reset_n                       (global_reset_n),
    .soft_reset_n                         (soft_reset_n),
    .seq_rdp_reset_req_n                  (seq_rdp_reset_req_n),

    .ac_clk_2x                            (ac_clk_2x),
    .measure_clk_2x                       (measure_clk_2x),
    .mem_clk_2x                           (mem_clk_2x),
    .mem_clk                              (mem_clk),
    .mem_clk_n                            (mem_clk_n),
    .phy_clk_1x                           (phy_clk_1x_src),
    .postamble_clk_2x                     (postamble_clk_2x),
    .resync_clk_2x                        (resync_clk_2x),
    .cs_n_clk_2x                          (cs_n_clk_2x),
    .write_clk_2x                         (write_clk_2x),
    .half_rate_clk                        (half_rate_clk),

    .reset_ac_clk_2x_n                    (reset_ac_clk_2x_n),
    .reset_measure_clk_2x_n               (reset_measure_clk_2x_n),
    .reset_mem_clk_2x_n                   (reset_mem_clk_2x_n),
    .reset_phy_clk_1x_n                   (reset_phy_clk_1x_n),
    .reset_poa_clk_2x_n                   (reset_poa_clk_2x_n),
    .reset_resync_clk_2x_n                (reset_resync_clk_2x_n),
    .reset_write_clk_2x_n                 (reset_write_clk_2x_n),
    .reset_cs_n_clk_2x_n                  (reset_cs_n_clk_2x_n),
    .reset_rdp_phy_clk_1x_n               (reset_rdp_phy_clk_1x_n),
    .mem_reset_n                          (),

    .reset_request_n                      (reset_request_n),

    .dqs_delay_ctrl                       (dqs_delay_ctrl),

    .phs_shft_busy                        (phs_shft_busy),
    .seq_pll_inc_dec_n                    (seq_pll_inc_dec_n),
    .seq_pll_select                       (seq_pll_select),
    .seq_pll_start_reconfig               (seq_pll_start_reconfig),
    .mimic_data_2x                        (mimic_data),
    .seq_clk_disable                      (seq_mem_clk_disable),
    .ctrl_clk_disable                     (ctl_mem_clk_disable)
);


// Instance the mimic block :

//
ddr3_int_phy_alt_mem_phy_mimic #(
    .NUM_MIMIC_SAMPLE_CYCLES (NUM_MIMIC_SAMPLE_CYCLES)
) mmc (
    .measure_clk             (measure_clk_2x),
    .reset_measure_clk_n     (reset_measure_clk_2x_n),
    .mimic_data_in           (mimic_data),
    .seq_mmc_start           (seq_mmc_start),
    .mmc_seq_done            (mmc_seq_done),
    .mmc_seq_value           (mmc_seq_value)
);

// If required, instance the Mimic debug block.  If the debug block is used, a top level input
// for mimic_recapture_debug_data should be created.
generate

    if (MIMIC_DEBUG_EN == 1)
    begin : create_mimic_debug_ram

        //
        ddr3_int_phy_alt_mem_phy_mimic_debug #(
                    .NUM_DEBUG_SAMPLES_TO_STORE (NUM_DEBUG_SAMPLES_TO_STORE),
            .PLL_STEPS_PER_CYCLE        (PLL_STEPS_PER_CYCLE)
        ) mmc_debug (
            .measure_clk                (measure_clk_1x),
            .reset_measure_clk_n        (reset_measure_clk_1x_n),
            .mmc_seq_done               (mmc_seq_done),
            .mmc_seq_value              (mmc_seq_value),
            .mimic_recapture_debug_data (1'b0)
        );

    end

endgenerate

endmodule

`default_nettype wire


//

`default_nettype none

`ifdef ALT_MEM_PHY_DEFINES
`else
`include "alt_mem_phy_defines.v"
`endif

//
module ddr3_int_phy_alt_mem_phy_ac (
                            clk_2x,
                            reset_2x_n,
                            phy_clk_1x,
                            ctl_add_1t_ac_lat,
                            ctl_negedge_en,
                            ctl_add_intermediate_regs,
                            period_sel,
                            seq_ac_sel,
                            ctl_ac_h,
                            ctl_ac_l,
                            seq_ac_h,
                            seq_ac_l,
                            mem_ac );
parameter POWER_UP_HIGH = 1;
parameter DWIDTH_RATIO  = 4;

// NB. clk_2x could be either ac_clk_2x or cs_n_clk_2x :
input wire   clk_2x;
input wire   reset_2x_n;
input wire   phy_clk_1x;

input wire   ctl_add_1t_ac_lat;
input wire   ctl_negedge_en;
input wire   ctl_add_intermediate_regs;
input wire   period_sel;
input wire   seq_ac_sel;
             
input wire   ctl_ac_h;
input wire   ctl_ac_l;
             
input wire   seq_ac_h;
input wire   seq_ac_l;

output wire  mem_ac;

(* preserve *) reg  ac_h_r     = POWER_UP_HIGH[0];
(* preserve *) reg  ac_l_r     = POWER_UP_HIGH[0];
(* preserve *) reg  ac_h_2r    = POWER_UP_HIGH[0];
(* preserve *) reg  ac_l_2r    = POWER_UP_HIGH[0];
(* preserve *) reg  ac_1t      = POWER_UP_HIGH[0];
(* preserve *) reg  ac_2x      = POWER_UP_HIGH[0];
(* preserve *) reg  ac_2x_r    = POWER_UP_HIGH[0];
(* preserve *) reg  ac_2x_2r   = POWER_UP_HIGH[0];
(* preserve *) reg  ac_2x_mux  = POWER_UP_HIGH[0];

reg ac_2x_retime     = POWER_UP_HIGH[0];
reg ac_2x_retime_r   = POWER_UP_HIGH[0];
reg ac_2x_deg_choice = POWER_UP_HIGH[0];

reg ac_h;
reg ac_l;

wire reset_2x ;
assign reset_2x         = ~reset_2x_n;

generate 
    
    if (DWIDTH_RATIO == 4) //HR
    begin : hr_mux_gen
    
        // Half Rate DDR memory types require an extra cycle of latency :
        always @(posedge phy_clk_1x)
        begin
        
            casez(seq_ac_sel)
            
            1'b0 :
            begin
                ac_l <= ctl_ac_l;
                ac_h <= ctl_ac_h;
            end
            
            1'b1 :
            begin
                ac_l <= seq_ac_l;
                ac_h <= seq_ac_h;
            end
        
            endcase
            
        end //always   
        
    end
    
    else // FR
    begin : fr_passthru_gen
        
        // Note that "_h" is unused in full-rate and no latency
        // is required :
        always @*
        begin
            
            casez(seq_ac_sel)
            
            1'b0 :
            begin
                ac_l <= ctl_ac_l;
            end
            
            1'b1 :
            begin
                ac_l <= seq_ac_l;
            end
            
            endcase
             
        end
    end
    
endgenerate    

generate

    if (DWIDTH_RATIO == 4)
    begin : half_rate

        // Initial registering of inputs :
        always @(posedge phy_clk_1x)
        begin
            ac_h_r  <= ac_h;
            ac_l_r  <= ac_l;
        end


        // Select high and low phases periodically to create the _2x signal :
        always @*
        begin

            casez(period_sel)

            1'b0     : ac_2x = ac_l_2r;
            1'b1     : ac_2x = ac_h_2r;
            default  : ac_2x = 1'bx; // X propagaton

            endcase

        end
        
        always @(posedge clk_2x)
        begin

            // Second stage of registering - on clk_2x
            ac_h_2r <= ac_h_r;
            ac_l_2r <= ac_l_r;

            // 1t registering - used if ctl_add_1t_ac_lat is true
            ac_1t   <= ac_2x;

            // AC_PHASE==270 requires an extra cycle of delay :
            ac_2x_deg_choice <= ac_1t;

            // If not at AC_PHASE==270, ctl_add_intermediate_regs shall be zero :
            if (ctl_add_intermediate_regs == 1'b0)
            begin
            
                if (ctl_add_1t_ac_lat == 1'b1)
                begin
                    ac_2x_r <= ac_1t;
                end
                
                else
                begin
                    ac_2x_r <= ac_2x;
                end
                
            end
            
            // If at AC_PHASE==270, ctl_add_intermediate_regs shall be one
            // and an extra cycle delay is required :
            else
            begin
           
                if (ctl_add_1t_ac_lat == 1'b1)
                begin
                    ac_2x_r <= ac_2x_deg_choice;
                end
                
                else
                begin
                    ac_2x_r <= ac_1t;
                end            
            
            end

            // Register the above output for use when ctl_negedge_en is set :
            ac_2x_2r <= ac_2x_r;

        end


        // Determine whether to select the "_r" or "_2r" variant :
        always @*
        begin

            casez(ctl_negedge_en)

            1'b0     : ac_2x_mux = ac_2x_r;
            1'b1     : ac_2x_mux = ac_2x_2r;
            default  : ac_2x_mux = 1'bx; // X propagaton

            endcase

        end

        if (POWER_UP_HIGH == 1)
        begin

            altddio_out #(
                .extend_oe_disable      ("UNUSED"),
                .intended_device_family ("Cyclone III"),
                .lpm_hint               ("UNUSED"),
                .lpm_type               ("altddio_out"),
                .oe_reg                 ("UNUSED"),
                .power_up_high          ("ON"),
                .width                  (1)
            ) addr_pin (
                .aset                   (reset_2x),
                .datain_h               (ac_2x_mux),
                .datain_l               (ac_2x_r),
                .dataout                (mem_ac),
                .oe                     (1'b1),
                .outclock               (clk_2x),
                .outclocken             (1'b1),
                .aclr                   (),
                .sset                   (),
                .sclr                   (),
                .oe_out                 ()
            );

        end

        else
        begin

            altddio_out #(
                .extend_oe_disable      ("UNUSED"),
                .intended_device_family ("Cyclone III"),
                .lpm_hint               ("UNUSED"),
                .lpm_type               ("altddio_out"),
                .oe_reg                 ("UNUSED"),
                .power_up_high          ("OFF"),
                .width                  (1)
            ) addr_pin (
                .aclr                   (reset_2x),
                .aset                   (),
                .datain_h               (ac_2x_mux),
                .datain_l               (ac_2x_r),
                .dataout                (mem_ac),
                .oe                     (1'b1),
                .outclock               (clk_2x),
                .outclocken             (1'b1),
                .sset                   (),
                .sclr                   (),
                .oe_out                 ()
                
            );

        end

    end // Half-rate

    // full-rate
    else
    begin : full_rate
   
        always @(posedge phy_clk_1x)
        begin
        
            // 1t registering - only used if ctl_add_1t_ac_lat is true
            ac_1t <= ac_l;
        
            // add 1 addr_clock delay if "Add 1T" is set:
           if (ctl_add_1t_ac_lat == 1'b1)
               ac_2x <= ac_1t;
           else
               ac_2x <= ac_l;
        
        end
        
        always @(posedge clk_2x)
        begin
            ac_2x_deg_choice <= ac_2x;
        end   
        
        // Note this is for 270 degree operation to align it to the correct clock phase.
        always @*
        begin
            casez(ctl_add_intermediate_regs)
                1'b0     : ac_2x_r = ac_2x;
                1'b1     : ac_2x_r = ac_2x_deg_choice;
                default  : ac_2x_r = 1'bx; // X propagaton
            endcase
        end
        
        always @(posedge clk_2x)
        begin
            ac_2x_2r <= ac_2x_r;
        end
        
        // Determine whether to select the "_r" or "_2r" variant :
        always @*
        begin
            casez(ctl_negedge_en)
                1'b0     : ac_2x_mux = ac_2x_r;
                1'b1     : ac_2x_mux = ac_2x_2r;
                default  : ac_2x_mux = 1'bx; // X propagaton
            endcase
        end
                       
        if (POWER_UP_HIGH == 1)
        begin
        
            altddio_out #(
                .extend_oe_disable      ("UNUSED"),
                .intended_device_family ("Cyclone III"),
                .lpm_hint               ("UNUSED"),
                .lpm_type               ("altddio_out"),
                .oe_reg                 ("UNUSED"),
                .power_up_high          ("ON"),
                .width                  (1)
            ) addr_pin (
                .aset                   (reset_2x),
                .datain_h               (ac_2x_mux),
                .datain_l               (ac_2x_r),
                .dataout                (mem_ac),
                .oe                     (1'b1),
                .outclock               (clk_2x),
                .outclocken             (1'b1),
                .aclr                   (),
                .sclr                   (),
                .sset                   (),
                .oe_out                 ()
            );
        
        end
        
        else
        begin
        
            altddio_out #(
                .extend_oe_disable      ("UNUSED"),
                .intended_device_family ("Cyclone III"),
                .lpm_hint               ("UNUSED"),
                .lpm_type               ("altddio_out"),
                .oe_reg                 ("UNUSED"),
                .power_up_high          ("OFF"),
                .width                  (1)
            ) addr_pin (
                .aclr                   (reset_2x),
                .datain_h               (ac_2x_mux),
                .datain_l               (ac_2x_r),
                .dataout                (mem_ac),
                .oe                     (1'b1),
                .outclock               (clk_2x),
                .outclocken             (1'b1),
                .aset                   (),
                .sclr                   (),
                .sset                   (),
                .oe_out                 ()
            );
            
        end // else: !if(POWER_UP_HIGH == 1) 

    end // block: full_rate

endgenerate

endmodule

`default_nettype wire

//

`default_nettype none

`ifdef ALT_MEM_PHY_DEFINES
`else
`include "alt_mem_phy_defines.v"
`endif

//
module ddr3_int_phy_alt_mem_phy_addr_cmd ( ac_clk_1x,
                                  ac_clk_2x,
                                  cs_n_clk_1x,
                                  cs_n_clk_2x,
                                  phy_clk_1x,
                                  reset_ac_clk_1x_n,
                                  reset_ac_clk_2x_n,
                                  reset_cs_n_clk_1x_n,
                                  reset_cs_n_clk_2x_n,
                                  
                                  // Addr/cmd interface from controller
                                  ctl_add_1t_ac_lat,
                                  ctl_add_1t_odt_lat,				   
                                  ctl_add_intermediate_regs,
                                  
                                  ctl_negedge_en,
				                  ctl_mem_addr_h,
                                  ctl_mem_addr_l,
                                  ctl_mem_ba_h,
                                  ctl_mem_ba_l,
                                  ctl_mem_cas_n_h,
                                  ctl_mem_cas_n_l,
                                  ctl_mem_cke_h,
                                  ctl_mem_cke_l,
                                  ctl_mem_cs_n_h,
                                  ctl_mem_cs_n_l,
                                  ctl_mem_odt_h,
                                  ctl_mem_odt_l,
                                  ctl_mem_ras_n_h,
                                  ctl_mem_ras_n_l,
                                  ctl_mem_we_n_h,
                                  ctl_mem_we_n_l,
				  
                                  // DDR3 Signals
                                  ctl_mem_rst_n_h,
                                  ctl_mem_rst_n_l,
                                  
                                  // Interface from Sequencer, used for calibration
                                  // as the MRS registers need to be controlled :
                                  seq_addr_h,
                                  seq_addr_l,
                                  seq_ba_h,
                                  seq_ba_l,
                                  seq_cas_n_h,
                                  seq_cas_n_l,
                                  seq_cke_h,
                                  seq_cke_l,
                                  seq_cs_n_h,
                                  seq_cs_n_l,
                                  seq_odt_h,
                                  seq_odt_l,
                                  seq_ras_n_h,
                                  seq_ras_n_l,
                                  seq_we_n_h,
                                  seq_we_n_l,

                                  // DDR3 Signals
                                  seq_mem_rst_n_h,
                                  seq_mem_rst_n_l,
                                  
                                  seq_ac_sel,
                                  
                                  mem_addr,
                                  mem_ba,
                                  mem_cas_n,
                                  mem_cke,
                                  mem_cs_n,
                                  mem_odt,
                                  mem_ras_n,
                                  mem_we_n, 
                                  mem_rst_n
				  );


parameter DWIDTH_RATIO            =           4;
parameter MEM_ADDR_CMD_BUS_COUNT  =           1;
parameter MEM_IF_BANKADDR_WIDTH   =           3;
parameter MEM_IF_CS_WIDTH         =           2;
parameter MEM_IF_MEMTYPE          =       "DDR";
parameter MEM_IF_ROWADDR_WIDTH    =          13;

input wire                                  cs_n_clk_1x;
input wire                                  cs_n_clk_2x;
input wire                                  ac_clk_1x;
input wire                                  ac_clk_2x;
input wire                                  phy_clk_1x;

input wire                                  reset_ac_clk_1x_n;
input wire                                  reset_ac_clk_2x_n;
input wire                                  reset_cs_n_clk_1x_n;
input wire                                  reset_cs_n_clk_2x_n;

input wire [MEM_IF_ROWADDR_WIDTH -1:0]      ctl_mem_addr_h;
input wire [MEM_IF_ROWADDR_WIDTH -1:0]      ctl_mem_addr_l;
input wire                                  ctl_add_1t_ac_lat;
input wire                                  ctl_add_1t_odt_lat;   
input wire                                  ctl_negedge_en;
input wire                                  ctl_add_intermediate_regs;    
input wire [MEM_IF_BANKADDR_WIDTH - 1:0]    ctl_mem_ba_h;
input wire [MEM_IF_BANKADDR_WIDTH - 1:0]    ctl_mem_ba_l;
input wire                                  ctl_mem_cas_n_h;
input wire                                  ctl_mem_cas_n_l;
input wire [MEM_IF_CS_WIDTH - 1:0]          ctl_mem_cke_h;
input wire [MEM_IF_CS_WIDTH - 1:0]          ctl_mem_cke_l;
input wire [MEM_IF_CS_WIDTH - 1:0]          ctl_mem_cs_n_h;
input wire [MEM_IF_CS_WIDTH - 1:0]          ctl_mem_cs_n_l;
input wire [MEM_IF_CS_WIDTH - 1:0]          ctl_mem_odt_h;
input wire [MEM_IF_CS_WIDTH - 1:0]          ctl_mem_odt_l;
input wire                                  ctl_mem_ras_n_h;
input wire                                  ctl_mem_ras_n_l;
input wire                                  ctl_mem_we_n_h;
input wire                                  ctl_mem_we_n_l;

input wire                                  ctl_mem_rst_n_h;
input wire                                  ctl_mem_rst_n_l;

input wire [MEM_IF_ROWADDR_WIDTH -1:0]      seq_addr_h;
input wire [MEM_IF_ROWADDR_WIDTH -1:0]      seq_addr_l;
input wire [MEM_IF_BANKADDR_WIDTH - 1:0]    seq_ba_h;
input wire [MEM_IF_BANKADDR_WIDTH - 1:0]    seq_ba_l;
input wire                                  seq_cas_n_h;
input wire                                  seq_cas_n_l;
input wire [MEM_IF_CS_WIDTH - 1:0]          seq_cke_h;
input wire [MEM_IF_CS_WIDTH - 1:0]          seq_cke_l;
input wire [MEM_IF_CS_WIDTH - 1:0]          seq_cs_n_h;
input wire [MEM_IF_CS_WIDTH - 1:0]          seq_cs_n_l;
input wire [MEM_IF_CS_WIDTH - 1:0]          seq_odt_h;
input wire [MEM_IF_CS_WIDTH - 1:0]          seq_odt_l;
input wire                                  seq_ras_n_h;
input wire                                  seq_ras_n_l;
input wire                                  seq_we_n_h;
input wire                                  seq_we_n_l;

input wire                                  seq_mem_rst_n_h;
input wire                                  seq_mem_rst_n_l;

input wire                                  seq_ac_sel;

output wire [MEM_IF_ROWADDR_WIDTH - 1 : 0]  mem_addr;
output wire [MEM_IF_BANKADDR_WIDTH - 1 : 0] mem_ba;
output wire                                 mem_cas_n;
output wire [MEM_IF_CS_WIDTH - 1 : 0]       mem_cke;
output wire [MEM_IF_CS_WIDTH - 1 : 0]       mem_cs_n;
output wire [MEM_IF_CS_WIDTH - 1 : 0]       mem_odt;
output wire                                 mem_ras_n;
output wire                                 mem_we_n;
output wire                                 mem_rst_n;


// Periodical select registers - per group of pins
reg  [`ADC_NUM_PIN_GROUPS-1:0]              count_addr = `ADC_NUM_PIN_GROUPS'b0;
reg  [`ADC_NUM_PIN_GROUPS-1:0]              count_addr_2x = `ADC_NUM_PIN_GROUPS'b0;
reg  [`ADC_NUM_PIN_GROUPS-1:0]              count_addr_2x_r = `ADC_NUM_PIN_GROUPS'b0;
reg  [`ADC_NUM_PIN_GROUPS-1:0]              period_sel_addr = `ADC_NUM_PIN_GROUPS'b0;

// Create new period select for new reset output :
reg                                         period_sel_rst_n = 1'b0;
reg                                         count_addr_rst_n = 1'b0;
reg                                         count_addr_rst_n_2x = 1'b0;
reg                                         count_addr_rst_n_2x_r = 1'b0;


generate
genvar ia;

for (ia=0; ia<`ADC_NUM_PIN_GROUPS - 1; ia=ia+1)
begin : SELECTS

    always @(posedge phy_clk_1x)
    begin
        count_addr[ia] <= ~count_addr[ia];
    end

    always @(posedge ac_clk_2x)
    begin
        count_addr_2x[ia]   <= count_addr[ia];
        count_addr_2x_r[ia] <= count_addr_2x[ia];
        period_sel_addr[ia] <= ~(count_addr_2x_r[ia] ^ count_addr_2x[ia]);
    end

end

endgenerate

// Reset period select :
always @(posedge phy_clk_1x)
begin
    count_addr_rst_n <= ~count_addr_rst_n;
end

always @(posedge ac_clk_2x)
begin
    count_addr_rst_n_2x   <= count_addr_rst_n ;
    count_addr_rst_n_2x_r <= count_addr_rst_n_2x;
    period_sel_rst_n	  <= ~(count_addr_rst_n_2x_r ^ count_addr_rst_n_2x );
end


//now generate cs_n period sel, off the dedicated cs_n clock :
always @(posedge phy_clk_1x)
begin
    count_addr[`ADC_CS_N_PERIOD_SEL] <= ~count_addr[`ADC_CS_N_PERIOD_SEL];
end

always @(posedge cs_n_clk_2x)
begin
    count_addr_2x  [`ADC_CS_N_PERIOD_SEL] <= count_addr   [`ADC_CS_N_PERIOD_SEL];
    count_addr_2x_r[`ADC_CS_N_PERIOD_SEL] <= count_addr_2x[`ADC_CS_N_PERIOD_SEL];
    period_sel_addr[`ADC_CS_N_PERIOD_SEL] <= ~(count_addr_2x_r[`ADC_CS_N_PERIOD_SEL] ^ count_addr_2x[`ADC_CS_N_PERIOD_SEL]);
end


// Create the ADDR I/O structure :
	
generate
genvar ib;

    for (ib=0; ib<MEM_IF_ROWADDR_WIDTH; ib=ib+1)
    begin : addr

        //
        ddr3_int_phy_alt_mem_phy_ac # ( 
                    .POWER_UP_HIGH (1),
            .DWIDTH_RATIO (DWIDTH_RATIO)
        ) addr_struct (
            .clk_2x                    (ac_clk_2x),
            .reset_2x_n                (1'b1),
            .phy_clk_1x                (phy_clk_1x),
            .ctl_add_1t_ac_lat         (ctl_add_1t_ac_lat),
            .ctl_negedge_en            (ctl_negedge_en),
            .ctl_add_intermediate_regs (ctl_add_intermediate_regs),
            .period_sel                (period_sel_addr[`ADC_ADDR_PERIOD_SEL]),
            .seq_ac_sel                (seq_ac_sel),
            .ctl_ac_h                  (ctl_mem_addr_h[ib]),
            .ctl_ac_l                  (ctl_mem_addr_l[ib]),
            .seq_ac_h                  (seq_addr_h[ib]),
            .seq_ac_l                  (seq_addr_l[ib]),
            .mem_ac                    (mem_addr[ib])
        );
        
    end

endgenerate

// Create the BANK_ADDR I/O structure :
generate
genvar ic;

    for (ic=0; ic<MEM_IF_BANKADDR_WIDTH; ic=ic+1)
    begin : ba

        //
        ddr3_int_phy_alt_mem_phy_ac #(
                    .POWER_UP_HIGH (0),
            .DWIDTH_RATIO (DWIDTH_RATIO)
        ) ba_struct  ( 
            .clk_2x                    (ac_clk_2x),
            .reset_2x_n                (1'b1),
            .phy_clk_1x                (phy_clk_1x),
            .ctl_add_1t_ac_lat         (ctl_add_1t_ac_lat),
            .ctl_negedge_en            (ctl_negedge_en),
            .ctl_add_intermediate_regs (ctl_add_intermediate_regs),
            .period_sel                (period_sel_addr[`ADC_BA_PERIOD_SEL]),
            .seq_ac_sel                (seq_ac_sel),
            .ctl_ac_h                  (ctl_mem_ba_h[ic]),
            .ctl_ac_l                  (ctl_mem_ba_l[ic]),
            .seq_ac_h                  (seq_ba_h[ic]),
            .seq_ac_l                  (seq_ba_l[ic]),
            .mem_ac                    (mem_ba[ic])
        );

    end

endgenerate

// Create the CAS_N I/O structure :
//
ddr3_int_phy_alt_mem_phy_ac #( 
    .POWER_UP_HIGH (1),
    .DWIDTH_RATIO (DWIDTH_RATIO)

) cas_n_struct ( 
    .clk_2x                    (ac_clk_2x),
    .reset_2x_n                (1'b1),
    .phy_clk_1x                (phy_clk_1x),
    .ctl_add_1t_ac_lat         (ctl_add_1t_ac_lat),
    .ctl_negedge_en            (ctl_negedge_en),
    .ctl_add_intermediate_regs (ctl_add_intermediate_regs),
    .period_sel                (period_sel_addr[`ADC_CAS_N_PERIOD_SEL]),
    .seq_ac_sel                (seq_ac_sel),
    .ctl_ac_h                  (ctl_mem_cas_n_h),
    .ctl_ac_l                  (ctl_mem_cas_n_l),
    .seq_ac_h                  (seq_cas_n_h),
    .seq_ac_l                  (seq_cas_n_l),
    .mem_ac                    (mem_cas_n)
);


// Create the CKE I/O structure :
generate
genvar id;

    for (id=0; id<MEM_IF_CS_WIDTH; id=id+1)
    begin : cke

        //
        ddr3_int_phy_alt_mem_phy_ac # (
                    .POWER_UP_HIGH (0),
            .DWIDTH_RATIO (DWIDTH_RATIO)
        ) cke_struct  ( 
            .clk_2x                    (ac_clk_2x),
            .reset_2x_n                (reset_ac_clk_2x_n),
            .phy_clk_1x                (phy_clk_1x),
            .ctl_add_1t_ac_lat         (ctl_add_1t_ac_lat),
            .ctl_negedge_en            (ctl_negedge_en),
            .ctl_add_intermediate_regs (ctl_add_intermediate_regs),
            .period_sel                (period_sel_addr[`ADC_CKE_PERIOD_SEL]),
            .seq_ac_sel                (seq_ac_sel),
            .ctl_ac_h                  (ctl_mem_cke_h[id]),
            .ctl_ac_l                  (ctl_mem_cke_l[id]),
            .seq_ac_h                  (seq_cke_h[id]),
            .seq_ac_l                  (seq_cke_l[id]),
            .mem_ac                    (mem_cke[id])
        );

    end

endgenerate


// Create the CS_N I/O structure.  Note that the 2x clock is different.
generate
genvar ie;

    for (ie=0; ie<MEM_IF_CS_WIDTH; ie=ie+1)
    begin : cs_n

        //
        ddr3_int_phy_alt_mem_phy_ac # ( 
                    .POWER_UP_HIGH (1),
            .DWIDTH_RATIO (DWIDTH_RATIO)
        ) cs_n_struct ( 
            .clk_2x                    (cs_n_clk_2x),
            .reset_2x_n                (reset_ac_clk_2x_n),
            .phy_clk_1x                (phy_clk_1x),
            .ctl_add_1t_ac_lat         (ctl_add_1t_ac_lat),
            .ctl_negedge_en            (ctl_negedge_en),
            .ctl_add_intermediate_regs (ctl_add_intermediate_regs),
            .period_sel                (period_sel_addr[`ADC_CS_N_PERIOD_SEL]),
            .seq_ac_sel                (seq_ac_sel),
            .ctl_ac_h                  (ctl_mem_cs_n_h[ie]),
            .ctl_ac_l                  (ctl_mem_cs_n_l[ie]),
            .seq_ac_h                  (seq_cs_n_h[ie]),
            .seq_ac_l                  (seq_cs_n_l[ie]),
            .mem_ac                    (mem_cs_n[ie])
        );

    end

endgenerate


// Create the ODT I/O structure :

generate
genvar ig;

    if (MEM_IF_MEMTYPE != "DDR")
    begin : gen_odt
    
        for (ig=0; ig<MEM_IF_CS_WIDTH; ig=ig+1)
        begin : odt

            //
            ddr3_int_phy_alt_mem_phy_ac #(
                    	.POWER_UP_HIGH (0),
        	.DWIDTH_RATIO (DWIDTH_RATIO)
            ) odt_struct  ( 
        	.clk_2x 		           (ac_clk_2x),
        	.reset_2x_n		           (1'b1),
        	.phy_clk_1x		           (phy_clk_1x),
        	.ctl_add_1t_ac_lat	       (ctl_add_1t_odt_lat),
        	.ctl_negedge_en 	       (ctl_negedge_en),
        	.ctl_add_intermediate_regs (ctl_add_intermediate_regs),
        	.period_sel		           (period_sel_addr[`ADC_ODT_PERIOD_SEL]),
        	.seq_ac_sel 	           (seq_ac_sel),
            .ctl_ac_h		           (ctl_mem_odt_h[ig]),
            .ctl_ac_l		           (ctl_mem_odt_l[ig]),
            .seq_ac_h		           (seq_odt_h[ig]),
            .seq_ac_l		           (seq_odt_l[ig]),
            .mem_ac 		           (mem_odt[ig])
            );

        end
	
    end
    
endgenerate


// Create the RAS_N I/O structure :
//
ddr3_int_phy_alt_mem_phy_ac # (
    .POWER_UP_HIGH (1),
    .DWIDTH_RATIO (DWIDTH_RATIO)
) ras_n_struct  ( 
    .clk_2x                    (ac_clk_2x),
    .reset_2x_n                (1'b1),
    .phy_clk_1x                (phy_clk_1x),
    .ctl_add_1t_ac_lat         (ctl_add_1t_ac_lat),
    .ctl_negedge_en            (ctl_negedge_en),
    .ctl_add_intermediate_regs (ctl_add_intermediate_regs),
    .period_sel                (period_sel_addr[`ADC_RAS_N_PERIOD_SEL]),
    .seq_ac_sel                (seq_ac_sel),
    .ctl_ac_h                  (ctl_mem_ras_n_h),
    .ctl_ac_l                  (ctl_mem_ras_n_l),
    .seq_ac_h                  (seq_ras_n_h),
    .seq_ac_l                  (seq_ras_n_l),
    .mem_ac                    (mem_ras_n)
);


// Create the WE_N I/O structure :
//
ddr3_int_phy_alt_mem_phy_ac # (
    .POWER_UP_HIGH (1),
    .DWIDTH_RATIO (DWIDTH_RATIO)
) we_n_struct  (
    .clk_2x                    (ac_clk_2x),
    .reset_2x_n                (1'b1),
    .phy_clk_1x                (phy_clk_1x),
    .ctl_add_1t_ac_lat         (ctl_add_1t_ac_lat),
    .ctl_negedge_en            (ctl_negedge_en),
    .ctl_add_intermediate_regs (ctl_add_intermediate_regs),
    .period_sel                (period_sel_addr[`ADC_WE_N_PERIOD_SEL]),
    .seq_ac_sel                (seq_ac_sel),
    .ctl_ac_h                  (ctl_mem_we_n_h),
    .ctl_ac_l                  (ctl_mem_we_n_l),
    .seq_ac_h                  (seq_we_n_h),
    .seq_ac_l                  (seq_we_n_l),
    .mem_ac                    (mem_we_n)
);


generate

    if (MEM_IF_MEMTYPE == "DDR3")
    begin : ddr3_rst

        // generate rst_n for DDR3
        //
        ddr3_int_phy_alt_mem_phy_ac # (
                    .POWER_UP_HIGH (0),
            .DWIDTH_RATIO   (DWIDTH_RATIO)
        )ddr3_rst_struct (
    	    .clk_2x		       (ac_clk_2x),  
    	    .reset_2x_n 	       (reset_ac_clk_2x_n),	     
    	    .phy_clk_1x 	       (phy_clk_1x), 
            .ctl_add_1t_ac_lat         (ctl_add_1t_ac_lat),
            .ctl_negedge_en            (ctl_negedge_en),
            .ctl_add_intermediate_regs (ctl_add_intermediate_regs),
            .period_sel                (period_sel_rst_n),
            .seq_ac_sel                (seq_ac_sel),
            .ctl_ac_h                  (ctl_mem_rst_n_h),
            .ctl_ac_l                  (ctl_mem_rst_n_l),
            .seq_ac_h                  (seq_mem_rst_n_h),
            .seq_ac_l                  (seq_mem_rst_n_l),
            .mem_ac                    (mem_rst_n)
        );
    
    end
    
    else
    begin : no_ddr3_rst
        assign mem_rst_n = 1'b1;
    end
     
endgenerate

endmodule

`default_nettype wire

/* Legal Notice: (C)2006 Altera Corporation. All rights reserved.  Your
   use of Altera Corporation's design tools, logic functions and other
   software and tools, and its AMPP partner logic functions, and any
   output files any of the foregoing (including device programming or
   simulation files), and any associated documentation or information are
   expressly subject to the terms and conditions of the Altera Program
   License Subscription Agreement or other applicable license agreement,
   including, without limitation, that your use is for the sole purpose
   of programming logic devices manufactured by Altera and sold by Altera
   or its authorized distributors.  Please refer to the applicable
   agreement for further details. */


/*////////////////////////////////////////////////////////////////////////////-
  Title           : Datapath IO elements

  File:  $RCSfile : alt_mem_phy_dp_io.v,v $

  Last Modified   : $Date: 2011/08/15 $

  Revision        : $Revision: #1 $

  Abstract        : NewPhy Datapath IO atoms.  This block shall connect to both
                    the read and write datapath blocks, abstracting the I/O
                    elements from the remainder of the circuit.  This file
                    uses the ALTDQ_DQS WYSIWYG which is configurable to be either
                    of type DQ, DQS or DQSN and just requires connecting to the
                    relevant IO buffers (ALTIOBUF) to create the full IO required
                    for DDR.
////////////////////////////////////////////////////////////////////////////-*/

`include "alt_mem_phy_defines.v"

//
module ddr3_int_phy_alt_mem_phy_dp_io (
                                reset_write_clk_2x_n,
                                resync_clk_2x,
				postamble_clk_2x,
                                mem_clk_2x,
                                write_clk_2x,
                                dqs_delay_ctrl,
                                mem_dm,
                                mem_dq,
                                mem_dqs,
                                mem_dqsn,
                                dio_rdata_h_2x,
                                dio_rdata_l_2x,
                                poa_postamble_en_preset_2x,
                                wdp_dm_h_2x,
                                wdp_dm_l_2x,
                                wdp_wdata_h_2x,
                                wdp_wdata_l_2x,
                                wdp_wdata_oe_2x,
                                wdp_wdqs_2x,
                                wdp_wdqs_oe_2x
                              );

parameter MEM_IF_DWIDTH             =             64;
parameter MEM_IF_DM_PINS_EN         =              1;
parameter MEM_IF_DM_WIDTH           =              8;
parameter MEM_IF_DQ_PER_DQS         =              8;
parameter MEM_IF_DQS_WIDTH          =              8;
parameter MEM_IF_MEMTYPE            =          "DDR";
parameter MEM_IF_DQSN_EN            =              1;
parameter MEM_IF_POSTAMBLE_EN_WIDTH =              8;
parameter DQS_DELAY_CTL_WIDTH       =              6;


input  wire                                             reset_write_clk_2x_n;
input  wire                                             resync_clk_2x;
input  wire                                             postamble_clk_2x;
input  wire                                             mem_clk_2x;
input  wire                                             write_clk_2x;
input  wire [DQS_DELAY_CTL_WIDTH - 1 : 0 ]              dqs_delay_ctrl;
output wire [MEM_IF_DM_WIDTH - 1 : 0]                   mem_dm;
inout  wire [MEM_IF_DWIDTH - 1 : 0]                     mem_dq;
inout  wire [MEM_IF_DQS_WIDTH - 1 : 0]                  mem_dqs;
inout  wire [MEM_IF_DQS_WIDTH - 1 : 0]                  mem_dqsn;
output reg  [MEM_IF_DWIDTH - 1 : 0]                     dio_rdata_h_2x;
output reg  [MEM_IF_DWIDTH - 1 : 0]                     dio_rdata_l_2x;
input  wire [MEM_IF_POSTAMBLE_EN_WIDTH - 1 : 0]         poa_postamble_en_preset_2x;
input  wire [MEM_IF_DM_WIDTH -1 : 0]                    wdp_dm_h_2x;
input  wire [MEM_IF_DM_WIDTH -1 : 0]                    wdp_dm_l_2x;
input  wire [MEM_IF_DWIDTH - 1 : 0]                     wdp_wdata_h_2x;
input  wire [MEM_IF_DWIDTH - 1 : 0]                     wdp_wdata_l_2x;
input  wire [MEM_IF_DWIDTH - 1 : 0]                     wdp_wdata_oe_2x;
input  wire [MEM_IF_DQS_WIDTH - 1 : 0]                  wdp_wdqs_2x;
input  wire [MEM_IF_DQS_WIDTH - 1 : 0]                  wdp_wdqs_oe_2x;


wire [MEM_IF_DWIDTH - 1 : 0]                            wdp_wdata_oe_2x_r;

wire [MEM_IF_DWIDTH - 1 : 0]                            rdata_n_captured;
wire [MEM_IF_DWIDTH - 1 : 0]                            rdata_p_captured;
                                                       
wire [(MEM_IF_DQS_WIDTH) - 1 : 0]                       wdp_wdqs_oe_2x_r;
wire [(MEM_IF_DQS_WIDTH) - 1 : 0]                       wdp_wdqsn_oe_2x_r;
                                                        
// The power-on low values are required to match those within ALTDQ_DQS, not for any functional reason :							
(* preserve *) reg  [MEM_IF_DWIDTH - 1 : 0]             rdata_n_ams = {MEM_IF_DWIDTH{1'b0}};
(* preserve *) reg  [MEM_IF_DWIDTH - 1 : 0]             rdata_p_ams = {MEM_IF_DWIDTH{1'b0}};

wire                                                    reset_write_clk_2x;

wire [MEM_IF_DWIDTH - 1 : 0]                            dq_ddio_dataout;
wire [MEM_IF_DWIDTH - 1 : 0]                            dq_datain;
wire [MEM_IF_DWIDTH - 1 : 0]                            dm_ddio_dataout;
wire [MEM_IF_DQS_WIDTH - 1 : 0]                         dqs_ddio_dataout;

wire [MEM_IF_DM_WIDTH - 1 : 0]                          dm_ddio_oe;

wire [MEM_IF_DQS_WIDTH - 1 : 0]                         dqs_buffered;

wire [(MEM_IF_DQS_WIDTH) - 1 : 0]                       dqs_pseudo_diff_out;
wire [(MEM_IF_DQS_WIDTH) - 1 : 0]                       dqsn_pseudo_diff_out;


// Create non-inverted reset for pads :
assign reset_write_clk_2x = ~reset_write_clk_2x_n;

// Read datapath functionality :

   
// synchronise to the resync_clk_2x_domain    
always @(posedge resync_clk_2x)
begin : capture_regs

    // Resynchronise :
            
    // The comparison to 'X' is performed to prevent X's being captured in non-DQS mode
    // and propagating into the sequencer's control logic.  This can only occur when a Verilog SIMGEN
    // model of the sequencer is being used :
    if (|rdata_p_captured === 1'bX) 
        rdata_p_ams <= {MEM_IF_DWIDTH{1'b0}};  
    else
        rdata_p_ams <= rdata_p_captured; // 'captured' is from the IOEs
        
     if (|rdata_n_captured === 1'bX) 
        rdata_n_ams <= {MEM_IF_DWIDTH{1'b0}};  
    else
        rdata_n_ams <= rdata_n_captured; // 'captured' is from the IOEs
    
    // Output registers :
    dio_rdata_h_2x <= rdata_p_ams;
    dio_rdata_l_2x <= rdata_n_ams;
      
end
    

// DQ pins and their logic

generate
genvar i,j;

// First generate each DQS group :
for (i=0; i<MEM_IF_DQS_WIDTH ; i=i+1)
begin : dqs_group


    // ALTDQ_DQS instances all WYSIWYGs for the DQ, DM and DQS/DQSN pins for a group :
//
    ddr3_int_phy_alt_mem_phy_dq_dqs dq_dqs (
        // DQ pin connections :
            .bidir_dq_areset({MEM_IF_DQ_PER_DQS{reset_write_clk_2x}}),
	    .bidir_dq_input_data_in(dq_datain[ (i+1)*MEM_IF_DQ_PER_DQS - 1 : i*MEM_IF_DQ_PER_DQS] ), // From ibuf
        
	    .bidir_dq_input_data_out_high(rdata_n_captured[ (i+1)*MEM_IF_DQ_PER_DQS - 1 : i*MEM_IF_DQ_PER_DQS]),
	    .bidir_dq_input_data_out_low(rdata_p_captured[ (i+1)*MEM_IF_DQ_PER_DQS - 1 : i*MEM_IF_DQ_PER_DQS]),
	    .bidir_dq_oe_in(wdp_wdata_oe_2x[ (i+1)*MEM_IF_DQ_PER_DQS - 1 : i*MEM_IF_DQ_PER_DQS]),
	    .bidir_dq_oe_out(wdp_wdata_oe_2x_r[ (i+1)*MEM_IF_DQ_PER_DQS - 1 : i*MEM_IF_DQ_PER_DQS]),
	    .bidir_dq_output_data_in_high(wdp_wdata_h_2x[ (i+1)*MEM_IF_DQ_PER_DQS - 1 : i*MEM_IF_DQ_PER_DQS]),
	    .bidir_dq_output_data_in_low(wdp_wdata_l_2x[ (i+1)*MEM_IF_DQ_PER_DQS - 1 : i*MEM_IF_DQ_PER_DQS]),
	    .bidir_dq_output_data_out(dq_ddio_dataout[ (i+1)*MEM_IF_DQ_PER_DQS - 1 : i*MEM_IF_DQ_PER_DQS]), // To obuf
        
        // Misc connections :
	    .dll_delayctrlin(dqs_delay_ctrl), // From DLL
	    .dq_input_reg_clk(dqs_buffered[i]),
	    .dq_output_reg_clk(write_clk_2x),
        
        // DQS/DQSN connections :
	    .dqs_enable_ctrl_in(poa_postamble_en_preset_2x[i]),
	    .dqs_enable_ctrl_clk(postamble_clk_2x),
        
        //NB. Inverted via dq_input_reg_clk_source=INVERTED_DQS_BUS param in ALTDQ_DQS clearbox config file :
	    .dqs_input_data_in(dqs_buffered[i]),
        
	    .dqs_oe_in(wdp_wdqs_oe_2x[i]),
	    .dqs_oe_out(wdp_wdqs_oe_2x_r[i]),
	    .dqs_output_data_in_high(wdp_wdqs_2x[i]), // DQS Output. From the write datapath
	    .dqs_output_data_in_low(1'b0),
	    .dqs_output_data_out(dqs_ddio_dataout[i]), 
	    .dqs_output_reg_clk(mem_clk_2x), 
	    .dqsn_oe_in(wdp_wdqs_oe_2x[i]), // Just use DQS OE to drive DQSN OE also
	    .dqsn_oe_out(wdp_wdqsn_oe_2x_r[i]),
        
        //DM pins are implemented using unidirection DQ pins :
	    .output_dq_oe_in(1'b1),
	    .output_dq_oe_out(dm_ddio_oe[i]),
	    .output_dq_output_data_in_high(wdp_dm_h_2x[i]),
	    .output_dq_output_data_in_low(wdp_dm_l_2x[i]),
	    .output_dq_output_data_out(dm_ddio_dataout[i]) // To obuf
     );
                      
                       
    // For DDR, or DDR2 where DQSN is disabled, it is important to leave the DQSN
    // pad unconnected, as otherwise this path remains in the netlist even
    // though there is no intent to use DQSN, and it is unused as an output :
    if (MEM_IF_MEMTYPE == "DDR" || (MEM_IF_MEMTYPE == "DDR2" && (MEM_IF_DQSN_EN == 0)) )
    begin : ddr_no_dqsn_ibuf_gen

        // Input buf
        arriaii_io_ibuf dqs_inpt_ibuf(
           .i      (mem_dqs[i]),
           .ibar   (),
           .o      (dqs_buffered[i])
           );
          
        // The DQS Output buffer itself :
        // OE input is active HIGH
        arriaii_io_obuf dqs_obuf (
            .i(dqs_ddio_dataout[i]),
            .oe(wdp_wdqs_oe_2x_r[i]), 
            .seriesterminationcontrol(),
            .devoe(),
            .o(mem_dqs[i]), 
            .obar()
        );    
     
        assign mem_dqsn[i] = 1'b0;

    end     
    
    // DDR2 (with DQSN enabled) has true differential DQS inputs :
    else
    begin : ddr2_with_dqsn_buf_gen

        // Input buffer now has DQSN input connection too :
        arriaii_io_ibuf dqs_inpt_ibuf(
           .i      (mem_dqs[i]),
           .ibar   (mem_dqsn[i]),
           .o      (dqs_buffered[i])
           );
    
        // Need to create the DQSN output buffer, which requires the use of the
        // Pseudo-diff atom :
        arriaii_pseudo_diff_out dqs_pdiff_out (
            .i    (dqs_ddio_dataout[i]),
            .o    (dqs_pseudo_diff_out[i]),
            .obar (dqsn_pseudo_diff_out[i])
        );
          
        // The DQS Output buffer itself, driven from 'O' output of pseudo-diff atom :
        // OE input is active HIGH
        arriaii_io_obuf dqs_obuf (
            .i(dqs_pseudo_diff_out[i]),
            .oe(wdp_wdqs_oe_2x_r[i]), 
            .seriesterminationcontrol(),
            .devoe(),
            .o(mem_dqs[i]), 
            .obar()
        );    
        
        // The DQSN Output buffer itself, driven from 'OBAR' output of pseudo-diff atom :
        // OE input is active HIGH
        arriaii_io_obuf dqsn_obuf (
            .i(dqsn_pseudo_diff_out[i]),
            .oe(wdp_wdqsn_oe_2x_r[i]), 
            .seriesterminationcontrol(),
            .devoe(),
            .o(mem_dqsn[i]), 
            .obar()
        );  
        
    end    
     
    // Then generate DQ pins for each group :
    for (j=0; j<MEM_IF_DQ_PER_DQS ; j=j+1)
    begin : dq

        // The DQ buffer (output side) :
        arriaii_io_obuf dq_obuf (
            .i(dq_ddio_dataout[j+(i*MEM_IF_DQ_PER_DQS)]),
            .oe(wdp_wdata_oe_2x_r[j+(i*MEM_IF_DQ_PER_DQS)]),  
            .seriesterminationcontrol(),
            .devoe(),
            .o(mem_dq[j+(i*MEM_IF_DQ_PER_DQS)]), //pad
            .obar()
        );
               
        // The DQ buffer (input side) :
        arriaii_io_ibuf # (
            .simulate_z_as("gnd")
        ) dq_ibuf (
            .i(mem_dq[j+(i*MEM_IF_DQ_PER_DQS)]),//pad
            .ibar(),
            .o(dq_datain[j+(i*MEM_IF_DQ_PER_DQS)])
        );
     
     end

    // The DM buffer (output only) :
        
    // DM Pin - if required :
    if (MEM_IF_DM_PINS_EN)
    begin : gen_dm
    
        arriaii_io_obuf dm_obuf (
            .i(dm_ddio_dataout[i]),
            .oe(dm_ddio_oe[i]),  
            .seriesterminationcontrol(),
            .devoe(),
            .o(mem_dm[i]), //pad
            .obar()
        );
        
    end
    
end 
endgenerate





endmodule

//

`ifdef ALT_MEM_PHY_DEFINES
`else
`include "alt_mem_phy_defines.v"
`endif

// ArriaII Clock/Reset block

//
module ddr3_int_phy_alt_mem_phy_clk_reset (
                               pll_ref_clk,
                               global_reset_n,
                               soft_reset_n,
                               seq_rdp_reset_req_n,
			       
                               ac_clk_2x,
                               measure_clk_2x,
                               mem_clk_2x,
                               mem_clk,
                               mem_clk_n,
                               phy_clk_1x,
                               postamble_clk_2x,
                               resync_clk_2x,
                               cs_n_clk_2x,
                               write_clk_2x,
                               half_rate_clk,

                               reset_ac_clk_2x_n,
                               reset_measure_clk_2x_n,
                               reset_mem_clk_2x_n,
                               reset_phy_clk_1x_n,
                               reset_poa_clk_2x_n,
                               reset_resync_clk_2x_n,
                               reset_write_clk_2x_n,
                               reset_cs_n_clk_2x_n,
                               reset_rdp_phy_clk_1x_n,
                               mem_reset_n,
			       
                               reset_request_n, // new output

                               dqs_delay_ctrl,

                               phs_shft_busy,
                               seq_pll_inc_dec_n,
                               seq_pll_select,
                               seq_pll_start_reconfig,

                               mimic_data_2x,

                               seq_clk_disable,
                               ctrl_clk_disable

                              ) /* synthesis altera_attribute="SUPPRESS_DA_RULE_INTERNAL=\"R101,C104,C106\"" */;


parameter CLOCK_INDEX_WIDTH            =              3;
parameter DLL_EXPORT_IMPORT            =         "NONE";
parameter DWIDTH_RATIO                 =              4;
parameter LOCAL_IF_CLK_PS              =           4000;
parameter MEM_IF_CLK_PAIR_COUNT        =              3;
parameter MEM_IF_CLK_PS                =           4000;
parameter MEM_IF_CLK_PS_STR            =       "4000 ps";
parameter MEM_IF_DWIDTH                =             64;
parameter MEM_IF_MEMTYPE               =          "DDR";
parameter MEM_IF_DQSN_EN               =              1;
parameter DLL_DELAY_BUFFER_MODE        =         "HIGH";
parameter DLL_DELAY_CHAIN_LENGTH       =              8;
parameter SCAN_CLK_DIVIDE_BY           =              2;
parameter USE_MEM_CLK_FOR_ADDR_CMD_CLK =              1;
parameter DQS_DELAY_CTL_WIDTH          =              6;
parameter INVERT_POSTAMBLE_CLK         =        "false";


// Clock/reset inputs :
input                                                 global_reset_n;
input  wire                                           soft_reset_n;
input  wire                                           pll_ref_clk;
input  wire                                           seq_rdp_reset_req_n;

// Clock/reset outputs :

output                                                ac_clk_2x;
output                                                measure_clk_2x;
output                                                mem_clk_2x;
inout  [MEM_IF_CLK_PAIR_COUNT - 1 : 0]                mem_clk;
inout  [MEM_IF_CLK_PAIR_COUNT - 1 : 0]                mem_clk_n;
output                                                phy_clk_1x;
output                                                postamble_clk_2x;
output                                                resync_clk_2x;
output                                                cs_n_clk_2x;
output                                                write_clk_2x;
output wire                                           half_rate_clk;


output wire                                           reset_ac_clk_2x_n;
output wire                                           reset_measure_clk_2x_n;
output wire                                           reset_mem_clk_2x_n;
(*preserve*) (* altera_attribute = "-name global_signal off" *) output reg    reset_phy_clk_1x_n;
output wire                                           reset_poa_clk_2x_n;
output wire                                           reset_resync_clk_2x_n;
output wire                                           reset_write_clk_2x_n;
output wire                                           reset_cs_n_clk_2x_n;
output wire                                           reset_rdp_phy_clk_1x_n;
output wire                                           mem_reset_n;

// This is the PLL locked signal :
output wire                                           reset_request_n;

// Misc I/O :
output wire [DQS_DELAY_CTL_WIDTH - 1 : 0 ]            dqs_delay_ctrl;

output wire                                           phs_shft_busy;

input  wire                                           seq_pll_inc_dec_n;
input  wire [CLOCK_INDEX_WIDTH - 1 : 0 ]              seq_pll_select;
input  wire                                           seq_pll_start_reconfig;

output wire                                           mimic_data_2x;


input wire                                            seq_clk_disable;
input wire [MEM_IF_CLK_PAIR_COUNT - 1 : 0]            ctrl_clk_disable;





// No attributes are applied to the clk/reset wires, as the fitter should be able to
// allocate GCLK/QCLK routing resources appropriately.  For specific GCLk/QCLK requirements
// this HDL may be edited using the following syntax :

// (* keep, altera_attribute = "-name global_signal dual_regional_clock" *) wire resync_clk_2x;

wire                                         global_reset_n;
reg                                          scan_clk = 1'b0;

wire                                         mem_clk_2x;

wire                                         phy_clk_1x;
wire                                         postamble_clk_2x;
wire                                         resync_clk_2x;
wire                                         write_clk_2x;

wire                                         cs_n_clk_2x;
wire                                         ac_clk_2x;
wire                                         measure_clk_2x;
wire                                         phy_internal_reset_n;

wire [MEM_IF_CLK_PAIR_COUNT - 1 : 0]         mem_clk;
wire [MEM_IF_CLK_PAIR_COUNT - 1 : 0]         mem_clk_n;


reg [2:0]                                    divider  = 3'h0;


(*preserve*) reg                             seq_pll_start_reconfig_ams;
(*preserve*) reg                             seq_pll_start_reconfig_r;
(*preserve*) reg                             seq_pll_start_reconfig_2r;
(*preserve*) reg                             seq_pll_start_reconfig_3r;

reg                                          pll_new_dir;
reg [CLOCK_INDEX_WIDTH - 1 : 0 ]             pll_new_phase;
wire                                         pll_phase_auto_calibrate_pulse;
(*preserve*) reg                             pll_reprogram_request;
wire                                         pll_locked_src;
reg                                          pll_locked;

(*preserve*) reg                             pll_reprogram_request_pulse;   // 1 scan clk cycle long
(*preserve*) reg                             pll_reprogram_request_pulse_r;
(*preserve*) reg                             pll_reprogram_request_pulse_2r;
wire                                         pll_reprogram_request_long_pulse; // 3 scan clk cycles long

(*preserve*) reg                             reset_master_ams;

wire [MEM_IF_CLK_PAIR_COUNT - 1 : 0]         mem_clk_pdiff_in;

wire [MEM_IF_CLK_PAIR_COUNT - 1 : 0]         mem_clk_buf_in;
wire [MEM_IF_CLK_PAIR_COUNT - 1 : 0]         mem_clk_n_buf_in;

wire                                         pll_phase_done;
reg                                          phs_shft_busy_siii;

(*preserve*) reg [2:0]                       seq_pll_start_reconfig_ccd_pipe;

(*preserve*) reg                             seq_pll_inc_dec_ccd;
(*preserve*) reg [CLOCK_INDEX_WIDTH - 1 : 0] seq_pll_select_ccd ;

(*preserve*) reg                             global_pre_clear;

wire                                         global_or_soft_reset_n;

(*preserve*) reg                             clk_div_reset_ams_n   = 1'b0;
(*preserve*) reg                             clk_div_reset_ams_n_r = 1'b0;

(*preserve*) reg                             pll_reconfig_reset_ams_n   = 1'b0;
(*preserve*) reg                             pll_reconfig_reset_ams_n_r = 1'b0;

wire                                         clk_divider_reset_n;

wire [MEM_IF_CLK_PAIR_COUNT - 1 : 0]         mimic_data_2x_internal;

wire                                         pll_reset;

wire                                         fb_clk;

wire                                         pll_reconfig_reset_n;


genvar dqs_group;



// Output the PLL locked signal to be used as a reset_request_n - IE. reset when the PLL loses
// lock :
assign reset_request_n = pll_locked;



// Reset the scanclk clock divider if we either have a global_reset or the PLL loses lock
assign pll_reconfig_reset_n = global_reset_n && pll_locked;


// Clock divider circuit reset generation.
always @(posedge phy_clk_1x or negedge pll_reconfig_reset_n)
begin

    if (pll_reconfig_reset_n == 1'b0)
    begin
        clk_div_reset_ams_n   <= 1'b0;
        clk_div_reset_ams_n_r <= 1'b0;
    end

    else
    begin
        clk_div_reset_ams_n   <= 1'b1;
        clk_div_reset_ams_n_r <= clk_div_reset_ams_n;
    end

end


// PLL reconfig and synchronisation circuit reset generation.
always @(posedge scan_clk or negedge pll_reconfig_reset_n)
begin

    if (pll_reconfig_reset_n == 1'b0)
    begin
        pll_reconfig_reset_ams_n   <= 1'b0;
        pll_reconfig_reset_ams_n_r <= 1'b0;
    end

    else
    begin
        pll_reconfig_reset_ams_n   <= 1'b1;
        pll_reconfig_reset_ams_n_r <= pll_reconfig_reset_ams_n;
    end

end

// Create the scan clock.  Used for PLL reconfiguring in this block.

// Clock divider reset is the direct output of the AMS flops :
assign clk_divider_reset_n = clk_div_reset_ams_n_r;

generate

    if (SCAN_CLK_DIVIDE_BY == 1)
    begin : no_scan_clk_divider

        always @(phy_clk_1x)
        begin
            scan_clk = phy_clk_1x;
        end

    end

    else
    begin : gen_scan_clk

        always @(posedge phy_clk_1x or negedge clk_divider_reset_n)
        begin

            if (clk_divider_reset_n == 1'b0)
            begin
                scan_clk  <= 1'b0;
                divider   <= 3'h0;
            end

            else
            begin

                // This method of clock division does not require "divider" to be used
                // as an intermediate clock:
                if (divider == (SCAN_CLK_DIVIDE_BY / 2 - 1))
                begin
                    scan_clk <= ~scan_clk; // Toggle
                    divider  <= 3'h0;
                end

                else
                begin
                    scan_clk <= scan_clk; // Do not toggle
                    divider  <= divider + 3'h1;
                end

            end

        end

    end

endgenerate


function [3:0] lookup_aii;

input [CLOCK_INDEX_WIDTH-1:0] seq_num;
begin
    casez (seq_num)
    4'b0000  : lookup_aii = 4'b0010; // Legal code
    4'b0001  : lookup_aii = 4'b0011; // Legal code
    4'b0010  : lookup_aii = 4'b1111; // illegal - return code 4'b1111
    4'b0011  : lookup_aii = 4'b0101; // Legal code
    4'b0100  : lookup_aii = 4'b1111; // illegal - return code 4'b1111
    4'b0101  : lookup_aii = 4'b0110; // Legal code
    4'b0110  : lookup_aii = 4'b1000; // Legal code
    4'b0111  : lookup_aii = 4'b0111; // Legal code
    4'b1000  : lookup_aii = 4'b0100; // Legal code
    4'b1001  : lookup_aii = 4'b1111; // illegal - return code 4'b1111
    4'b1010  : lookup_aii = 4'b1111; // illegal - return code 4'b1111
    4'b1011  : lookup_aii = 4'b1111; // illegal - return code 4'b1111
    4'b1100  : lookup_aii = 4'b1111; // illegal - return code 4'b1111
    4'b1101  : lookup_aii = 4'b1111; // illegal - return code 4'b1111
    4'b1110  : lookup_aii = 4'b1111; // illegal - return code 4'b1111
    4'b1111  : lookup_aii = 4'b1111; // illegal - return code 4'b1111
    default  : lookup_aii = 4'bxxxx; // X propagation
    endcase
end

endfunction


always @(posedge phy_clk_1x or negedge reset_phy_clk_1x_n)
begin

    if (reset_phy_clk_1x_n == 1'b0)
    begin
        seq_pll_inc_dec_ccd             <= 1'b0;
        seq_pll_select_ccd              <= {CLOCK_INDEX_WIDTH{1'b0}};
        seq_pll_start_reconfig_ccd_pipe <= 3'b000;
    end

    // Generate 'ccd' Cross Clock Domain signals :
    else
    begin

        seq_pll_start_reconfig_ccd_pipe <= {seq_pll_start_reconfig_ccd_pipe[1:0], seq_pll_start_reconfig};

        if (seq_pll_start_reconfig == 1'b1 && seq_pll_start_reconfig_ccd_pipe[0] == 1'b0)
        begin
            seq_pll_inc_dec_ccd <= seq_pll_inc_dec_n;
            seq_pll_select_ccd  <= seq_pll_select;
        end

    end

end
always @(posedge scan_clk or negedge pll_reconfig_reset_ams_n_r)
begin

    if (pll_reconfig_reset_ams_n_r == 1'b0)
    begin
        seq_pll_start_reconfig_ams     <= 1'b0;
        seq_pll_start_reconfig_r       <= 1'b0;
        seq_pll_start_reconfig_2r      <= 1'b0;
        seq_pll_start_reconfig_3r      <= 1'b0;

        pll_reprogram_request_pulse    <= 1'b0;
        pll_reprogram_request_pulse_r  <= 1'b0;
        pll_reprogram_request_pulse_2r <= 1'b0;
        pll_reprogram_request          <= 1'b0;
    end

    else
    begin
        seq_pll_start_reconfig_ams       <= seq_pll_start_reconfig_ccd_pipe[2];
        seq_pll_start_reconfig_r         <= seq_pll_start_reconfig_ams;
        seq_pll_start_reconfig_2r        <= seq_pll_start_reconfig_r;
        seq_pll_start_reconfig_3r        <= seq_pll_start_reconfig_2r;

        pll_reprogram_request_pulse      <= pll_phase_auto_calibrate_pulse;
        pll_reprogram_request_pulse_r    <= pll_reprogram_request_pulse;
        pll_reprogram_request_pulse_2r   <= pll_reprogram_request_pulse_r;
        pll_reprogram_request            <= pll_reprogram_request_long_pulse;
    end

end


// Rising-edge detect to generate a single phase shift step
assign pll_phase_auto_calibrate_pulse = ~seq_pll_start_reconfig_3r && seq_pll_start_reconfig_2r;

// extend the phase shift request pulse to be 3 scan clk cycles long.
assign pll_reprogram_request_long_pulse = pll_reprogram_request_pulse || pll_reprogram_request_pulse_r || pll_reprogram_request_pulse_2r;

// Register the Phase step settings
always @(posedge scan_clk or negedge pll_reconfig_reset_ams_n_r)
begin
    if (pll_reconfig_reset_ams_n_r == 1'b0)
    begin
        pll_new_dir   <= 1'b0;
        pll_new_phase <= 'h0;
    end

    else
    begin

        if (pll_phase_auto_calibrate_pulse)
        begin
            pll_new_dir   <= seq_pll_inc_dec_ccd;
            pll_new_phase <= seq_pll_select_ccd;
        end

    end
end


// generate the busy signal - just the inverse of the done o/p from the pll, and stretched ,
//as the initial pulse might not be long enough to be catched by the sequencer
//the same circuitry in the ciii clock and reset block

always @(posedge scan_clk or negedge pll_reconfig_reset_ams_n_r)
begin

    if (pll_reconfig_reset_ams_n_r == 1'b0)
        phs_shft_busy_siii <= 1'b0;

    else
        phs_shft_busy_siii <= pll_reprogram_request || ~pll_phase_done;

end

assign phs_shft_busy = phs_shft_busy_siii;

// Gate the soft reset input (from SOPC builder for example) with the PLL
// locked signal :
assign global_or_soft_reset_n  = soft_reset_n && global_reset_n;

// Create the PHY internal reset signal :
assign phy_internal_reset_n = pll_locked && global_or_soft_reset_n;

// The PLL resets only on a global reset :
assign pll_reset = !global_reset_n;

generate

    // Half-rate mode :
    if (DWIDTH_RATIO == 4)
    begin : half_rate

        //
        ddr3_int_phy_alt_mem_phy_pll pll (
                     .inclk0             (pll_ref_clk),
             .areset             (pll_reset),
             .c0                 (phy_clk_1x),
             .c1                 (mem_clk_2x),
             .c2                 (), //unused
             .c3                 (write_clk_2x),
             .c4                 (resync_clk_2x),
             .c5                 (measure_clk_2x),
             .phasecounterselect (lookup_aii(pll_new_phase)),
             .phasestep          (pll_reprogram_request),
             .phaseupdown        (pll_new_dir),
             .scanclk            (scan_clk),
             .locked             (pll_locked_src),
             .phasedone          (pll_phase_done)
         );

        assign half_rate_clk = phy_clk_1x;

    end

    // Full-rate mode :
    else
    begin : full_rate


        //
        ddr3_int_phy_alt_mem_phy_pll pll (
                     .inclk0             (pll_ref_clk),
             .areset             (pll_reset),
             .c0                 (half_rate_clk),
             .c1                 (mem_clk_2x),
             .c2                 (), //unused
             .c3                 (write_clk_2x),
             .c4                 (resync_clk_2x),
             .c5                 (measure_clk_2x),
             .phasecounterselect (lookup_aii(pll_new_phase)),
             .phasestep          (pll_reprogram_request),
             .phaseupdown        (pll_new_dir),
             .scanclk            (scan_clk),
             .locked             (pll_locked_src),
             .phasedone          (pll_phase_done)
         );

         // NB. phy_clk_1x is now full-rate, despite the "1x" naming convention :
        assign phy_clk_1x = mem_clk_2x;

    end

endgenerate




//synopsys translate_off
reg [19:0] pll_locked_chain  = 20'h0;

always @(posedge pll_ref_clk)
begin
    pll_locked_chain <= {pll_locked_chain[18:0],pll_locked_src};
end
//synopsys translate_on

always @*
begin
 pll_locked = pll_locked_src;
//synopsys translate_off
 pll_locked = pll_locked_chain[19];
//synopsys translate_on
end

// The postamble clock can be the inverse of the resync clock
assign postamble_clk_2x = (INVERT_POSTAMBLE_CLK == "true") ? ~resync_clk_2x : resync_clk_2x;

generate

    if (USE_MEM_CLK_FOR_ADDR_CMD_CLK == 1)
    begin

        assign ac_clk_2x = mem_clk_2x;
        assign cs_n_clk_2x = mem_clk_2x;

    end

    else
    begin

        assign ac_clk_2x = write_clk_2x;
        assign cs_n_clk_2x = write_clk_2x;

    end

endgenerate


generate

genvar clk_pair;

    for (clk_pair = 0 ; clk_pair < MEM_IF_CLK_PAIR_COUNT; clk_pair = clk_pair + 1)
    begin : DDR_CLK_OUT

        arriaii_ddio_out # (
            .half_rate_mode("false"),
            .sync_mode("clear"), // for mem clk disable
            .use_new_clocking_model("true")
        ) mem_clk_ddio (
            .datainlo        (1'b0),
            .datainhi        (~seq_clk_disable && ~ctrl_clk_disable[clk_pair]),
            .clkhi           (mem_clk_2x),
            .clklo           (mem_clk_2x),
	    //synthesis translate_off
            .clk             (),
	    //synthesis translate_on
            .muxsel          (mem_clk_2x),
            .ena             (1'b1),
            .areset          (1'b0),
            .sreset          (1'b0),
            .dataout         (mem_clk_pdiff_in[clk_pair]),
            .dfflo           (),
            .dffhi           (),
            .devpor          (),
            .devclrn         ()
        );

        // Pseudo-diff used to ensure fanout of 1 from OPA/DDIO_OUT atoms :
        arriaii_pseudo_diff_out mem_clk_pdiff (
             .i    (mem_clk_pdiff_in[clk_pair]),
             .o    (  mem_clk_buf_in[clk_pair]),
             .obar (mem_clk_n_buf_in[clk_pair])
         );

        // The same output buf is for both DDR2 and 3 :
        arriaii_io_obuf # (
            .bus_hold("false"),
            .open_drain_output("false")
        ) mem_clk_obuf (
            .i                         (mem_clk_buf_in[clk_pair]),
            .oe                        (1'b1),
            // synopsys translate_off
            .seriesterminationcontrol(),
            .obar(),
            // synopsys translate_on
            .o(mem_clk[clk_pair]),
            .devoe()
        );

        // The same output buf is used
        arriaii_io_obuf # (
            .bus_hold("false"),
            .open_drain_output("false")
        ) mem_clk_n_obuf (
            .i                         (mem_clk_n_buf_in[clk_pair]),
            .oe                        (1'b1),
            // synopsys translate_off
            .seriesterminationcontrol(),
            .obar(),
            // synopsys translate_on
            .o(mem_clk_n[clk_pair]),
            .devoe()
        );

    end //for

endgenerate


// Mimic path uses single-ended buffer, as this is the SII scheme :
arriaii_io_ibuf fb_clk_ibuf(
    .i      (mem_clk[0]),
    // synopsys translate_off
    .ibar(),
    // synopsys translate_on
    .o      (fb_clk)

);


// DDR2 Mimic Path Generation - in effect this is just a register :
arriaii_ddio_in ddio_mimic(
    .datain     (fb_clk),
    .clk        (measure_clk_2x),
    .clkn       (),
    // synopsys translate_off
    .devclrn(),
    .devpor(),
   // synopsys translate_on
    .ena        (1'b1),
    .areset     (1'b0),
    .sreset     (1'b0),
    .regoutlo   (),
    .regouthi   (mimic_data_2x),
    .dfflo      ()
);


generate
    if (DLL_EXPORT_IMPORT != "IMPORT")
    begin
        arriaii_dll # (
            .input_frequency                 (MEM_IF_CLK_PS_STR),
            .delay_buffer_mode               (DLL_DELAY_BUFFER_MODE),
            .delay_chain_length              (DLL_DELAY_CHAIN_LENGTH),
            .delayctrlout_mode               ("normal"),
            .jitter_reduction                ("true"),
            .sim_valid_lock                  (1280),
            .sim_low_buffer_intrinsic_delay  (350),
            .sim_high_buffer_intrinsic_delay (175),
            .sim_buffer_delay_increment      (10),
            .static_delay_ctrl               (0),
            .lpm_type                        ("arriaii_dll")
        ) dll(
            .clk                    (mem_clk_2x),
            .aload                  (~pll_locked),
            .delayctrlout           (dqs_delay_ctrl),
            .upndnout               (),
            .dqsupdate              (),
            .offsetdelayctrlclkout  (),
            .offsetdelayctrlout     (),
            .devpor                 (),
            .devclrn                (),
            .upndninclkena          (),
            .upndnin                ()
        );
    end

    else
    begin
        assign dqs_delay_ctrl = {DQS_DELAY_CTL_WIDTH{1'b0}};
    end

endgenerate






// Master reset generation :
always @(posedge phy_clk_1x or negedge phy_internal_reset_n)
begin

    if (phy_internal_reset_n == 1'b0)
    begin
        reset_master_ams <= 1'b0;
        global_pre_clear <= 1'b0;
    end

    else
    begin
        reset_master_ams <= 1'b1;
        global_pre_clear <= reset_master_ams;
    end

end


// phy_clk reset generation :
always @(posedge phy_clk_1x or negedge global_pre_clear)
begin

    if (global_pre_clear == 1'b0)
    begin
        reset_phy_clk_1x_n <= 1'b0;
    end

    else
    begin
        reset_phy_clk_1x_n <= global_pre_clear;
    end

end



// phy_clk reset generation for read datapaths :
//
ddr3_int_phy_alt_mem_phy_reset_pipe # (.PIPE_DEPTH (2) ) reset_rdp_phy_clk_pipe(
     .clock     (phy_clk_1x),
     .pre_clear (seq_rdp_reset_req_n && global_pre_clear),
     .reset_out (reset_rdp_phy_clk_1x_n)
);


// NB. phy_clk reset is generated above.

// Instantiate the reset pipes.  The 4 reset signals below are family invariant
// whilst the other resets are generated on a per-family basis :


// mem_clk reset generation :
//
ddr3_int_phy_alt_mem_phy_reset_pipe # (.PIPE_DEPTH (2) )  mem_pipe(
     .clock     (mem_clk_2x),
     .pre_clear (global_pre_clear),
     .reset_out (mem_reset_n)
);

// mem_clk_2x reset generation - required for SIII DDR/DDR2 support :
//
ddr3_int_phy_alt_mem_phy_reset_pipe # (.PIPE_DEPTH (4) ) mem_clk_pipe(
    .clock     (mem_clk_2x),
    .pre_clear (global_pre_clear),
    .reset_out (reset_mem_clk_2x_n)
);

// poa_clk_2x reset generation (also reset on sequencer re-cal request) :
//
ddr3_int_phy_alt_mem_phy_reset_pipe # (.PIPE_DEPTH (2) )  poa_clk_pipe(
    .clock     (postamble_clk_2x),
    .pre_clear (seq_rdp_reset_req_n && global_pre_clear),
    .reset_out (reset_poa_clk_2x_n)
);
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
