Doomn00b/Open-SVGA/Gateware/hdl/de/ded_mskgen.v

///////////////////////////////////////////////////////////////////////////////
//
//  Copyright (C) 2014 Francis Bruno, All Rights Reserved
// 
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
//  This code is available under licenses for commercial use. Please contact
//  Francis Bruno for more information.
//
//  http://www.gplgpu.com
//  http://www.asicsolutions.com
//  
//  Title       :  Drawing Engine Data Path Mask Generator
//  File        :  ded_mskgen.v
//  Author      :  Jim MacLeod
//  Created     :  30-Dec-2008
//  RCS File    :  $Source:$
//  Status      :  $Id:$
//
//
///////////////////////////////////////////////////////////////////////////////
//
//  Description :
//
//////////////////////////////////////////////////////////////////////////////
//
//  Modules Instantiated:
//
///////////////////////////////////////////////////////////////////////////////
//
//  Modification History:
//
//  $Log:$
//
///////////////////////////////////////////////////////////////////////////////
///////////////////////////////////////////////////////////////////////////////
///////////////////////////////////////////////////////////////////////////////
`timescale 1ns / 10ps
module ded_mskgen
  #(parameter BYTES = 4)
  (
   input                de_clk,         // drawing engine clock
                        de_rstn,        // drawing engine reset
                        mclock,         // memory controller clock
                        mc_acken,       // memory controller pop enable
                        mc_popen,       // memory controller pop enable
   input                ld_msk,         // load mask registers
   input                line_actv_4,    // line command active bit
                        blt_actv_4,     // blt command active bit
   input [1:0]          clp_4,          // clipping control register
   input                mem_req,        // memory request signal
   input                mem_rd,         // memory read signal
   input [BYTES-1:0]    pc_msk_in,      // pixel cache mask
   input [31:0]         clpx_bus_2,     // clipping {xmax[15:4],xmin[15:4]}
   input [15:0]         x_bus,          // bus from execution X dest counter
   input [6:0]          xalu_bus,       // bus from execution unit X alu
   input                trnsp_4,        // Transparent bit
   input [BYTES-1:0]    trns_msk_in,    // Transparentcy mask
   input                ps16_2,         // pixel size equals 16
   input                ps32_2,         // pixel size equals 32
   input                mc_eop,         // mc end of page delayed
   input [3:0]          mask_4,         // plane mask
   input [6:0]          lft_enc_4,
   input [6:0]          rht_enc_4,
   input [11:0]         clp_min_4,      // left clipping pointer
   input [11:0]         clp_max_4,      // right clipping pointer
   input [3:0]          cmin_enc_4,
   input [3:0]          cmax_enc_4,
   input                y_clip_4,
   input                sol_4,
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
