Doomn00b/Open-SVGA/(commit log)

2020-09-03 Add files via upload
    Schematics in Kicad-format for the development-board prototype. Subject to constant change.
    [svga-devboard.kicad_pcb, svga-devboard.sch]
2020-09-03 Add files via upload
    Spreadsheets for selecting the most suitable VRAM-modules for the project. The memory-chips are sorted via a points-system, based on pre-requisites like power consumption, clock cycles, CAS delay, and price.
    [DRAM.xlsx, digi-DRAM1.xlsx, digi-dram2.xlsx]
2020-09-03 Add files via upload
    A file listing the 381 pins of the Lattice ECP5-85 FPGA that sits at the core of the project. The purpose is to make a visual guide to help make understanding and utilizing the FPGA easier, and to use for reference for the KiCad-models.
    [ECP5U-pinout-marked.xlsx]
2020-09-03 Add files via upload
    Main design-document collecting as many and varied a topic as the design-specifications, performance-targets, to-do-lists, reference-materials and other assorted information.
2020-09-28 Add files via upload
    Converted to hierarchical scheets, added support-components for SMPS-units - many other changes.
    [VoltTranslate_osvga.sch, dp_osvga.sch, dram_osvga.sch, dvi_osvga.sch, ecp5-85-fpga.sch, file5F5F9E23.sch, file6038529C.sch, file629A7665.sch]
2020-10-17 Add files via upload
    Added Pull-up and pull-down resistors for JTAG and sysConfig connections.
    Added pinheaders for FPGA-Configuration. (replacing edge-connector)
    Combined the DVI+VGA and USB-C hierarchical sheets into one.
    Assigned a dedicated sheet for the DAC.
    Added 75 Ohm terminal-resistors to output of DAC.
    Placed filtering-capacitors for DAC VAA.
    Connected VGA ID-bits and DVI DDC together.
    [DAC_60796DC7.sch, VoltTranslate_osvga.sch, dram_osvga.sch, ecp5-85-fpga.sch, jtag_osvga.sch, pci-bus_osvga.sch, power_osvga.sch, svga-devboard.kicad_pcb]
2023-07-09 Converted the project over to Kicad 7, and fixed all of the artifacts that came with it, such as updating symbols and footprints.
    [10133476-10001LF.stp, 61201021721_Download_STP_61201021721_rev1.stp, DAC_60796DC7.sch, DAC_osvga.kicad_sch, DRAM.xlsx, DVI_743209010.stp, Diff-pairs.txt, ECP5U-pinout-marked.xlsx]
2023-07-21 Disconnected the DVI-connectors from each other, so that they do go over the intended flat-cable to the daughter-board instead.
    [DAC_osvga.kicad_sch, ECP5U85Pinout.xlsx, VoltTranslate_osvga.kicad_sch, dram_osvga.kicad_sch, ecp5-85-fpga.kicad_sch, jtag_osvga.kicad_sch, pci-bus_osvga.kicad_sch, power_osvga.kicad_sch]
