Doomn00b/Open-SVGA/(notices)

Notices in the files:
Gateware/hdl/de3d/des_top.v:
under the terms of the GNU General Public License as published by the Free
Hardware/svga-devboard/jtag_osvga.kicad_sch:
Copyright DoomN00b
